SK21/AOG_AutoSteer/SteeringConfigPGNs.pdf

PGNs | 32300 | 32503
| Teensy steering config | subnet change
0 | 44 | 247
1 | 126 | 126
2 | power relay | IP 0
3 | steer relay | IP 1
4 | WAS | IP 2
5 | Current Sensor | CRC
6 steer switch
7 work switch
8 DIR
9 PWM
10 Receiver port
11 RS232 out port
12 RS232 in port
13 IMU port
14 Commands
15 IMU type
16 CRC
byte 14:
bit 0, zero WAS
bit 1, invert roll
bit 2, use ADS1115
bit 3, Auto zero WAS
byte 15:
0, BNO088
1, TM171
