SK21/AOG_AutoSteer/AutoSteer15-3/AS15-3 PinOut.pdf

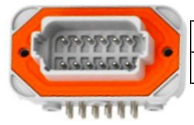
[picture p2: figure]

1 Motor A | 2 GND | 3 12V Out | 4 5V | 5 RS232 TX | 6 RS232 RX
12V In 12 | GND 11 | Motor B 10 | WAS 9 | Str Switch 8 | Wrk Switch 7

AS15-3 PinOut
