SK21/AOG_AutoSteer/AutoSteer15-3/AS15-3 pinout.PNG

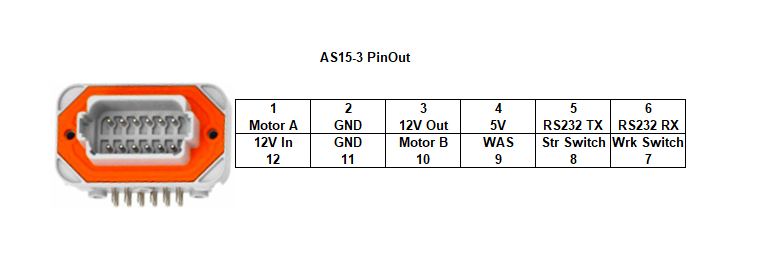
AutoSteer15-3/AS15-3 pinout.PNG
