SK21/AOG_AutoSteer/AutoSteer15-3/AS15.jpg

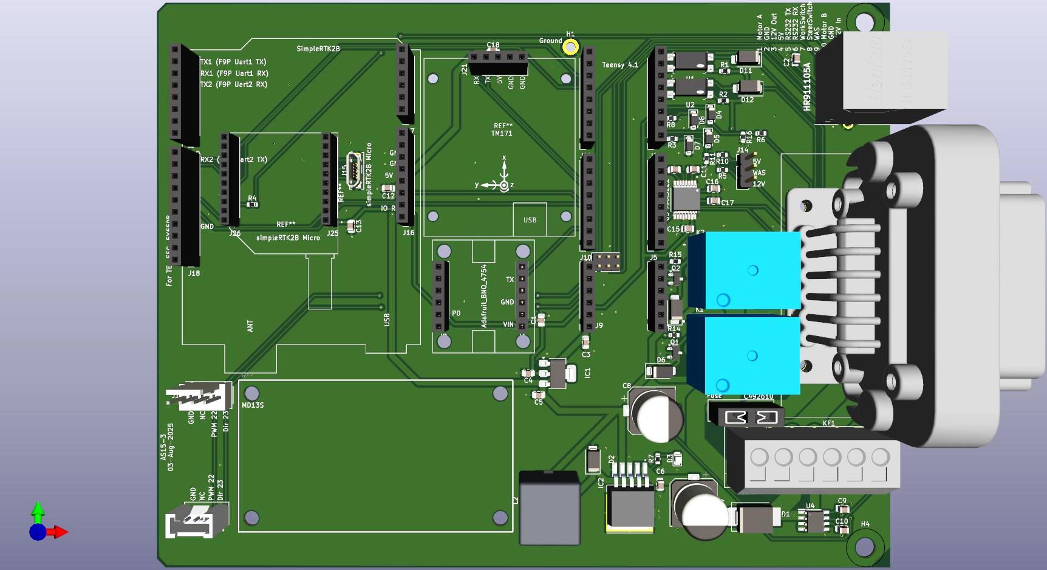
AutoSteer15-3/AS15.jpg
