SK21/AOG_AutoSteer/AutoSteer15-3/Board1.jpg

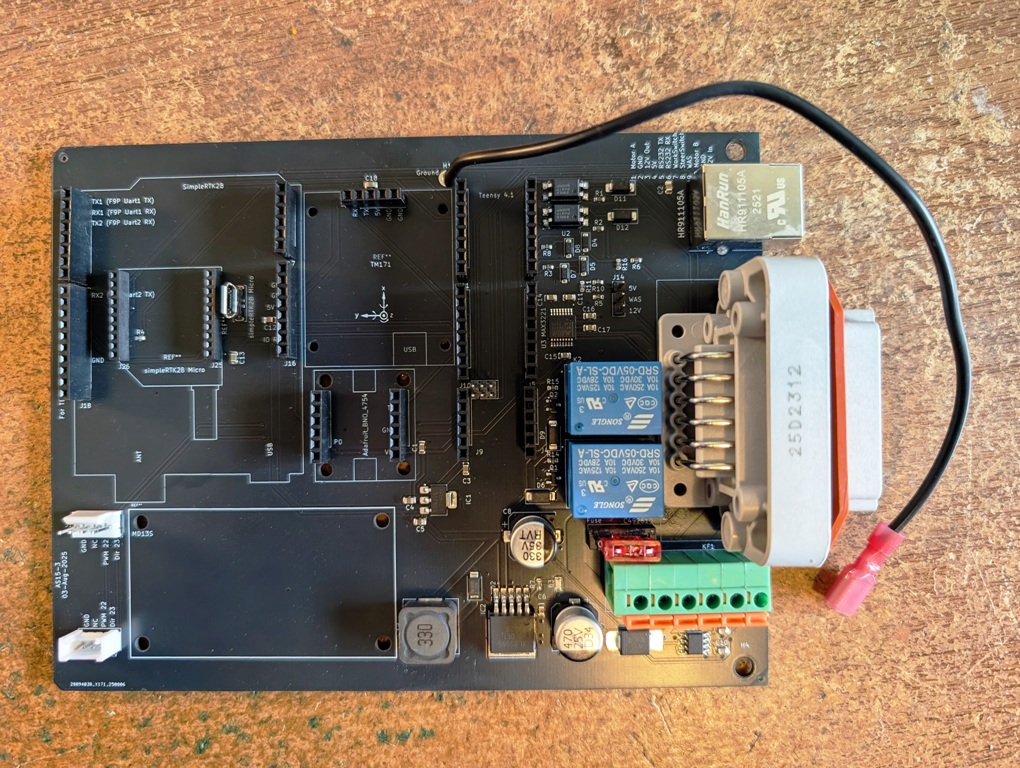
AutoSteer15-3/Board1.jpg
