SK21/AOG_AutoSteer/AutoSteer15-3/Board2.jpg

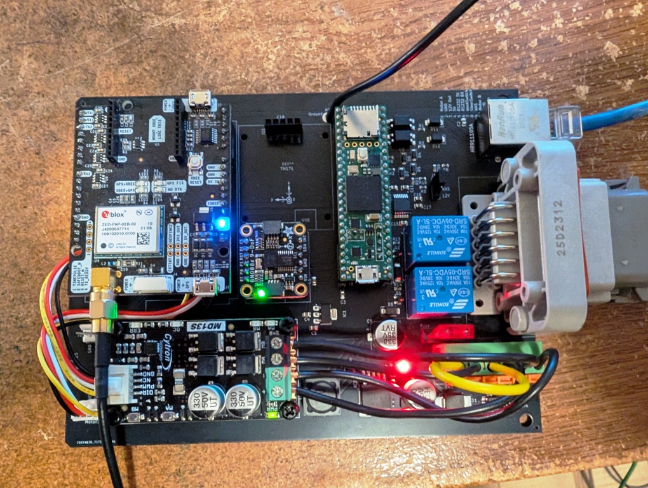
AutoSteer15-3/Board2.jpg
