SK21/AOG_AutoSteer/AutoSteer15-3/control box.jpg

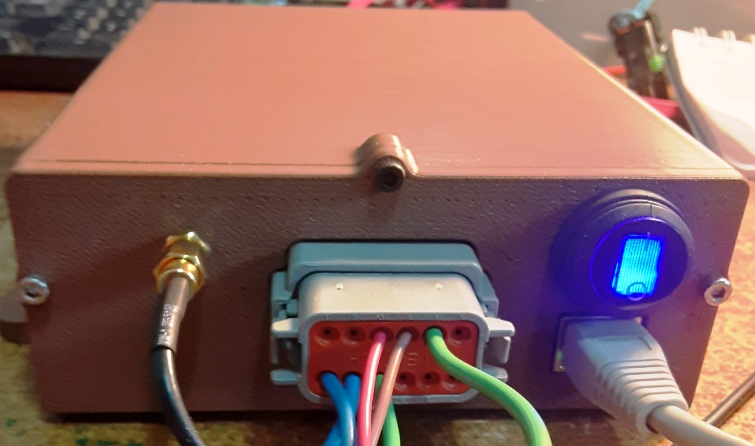
AutoSteer15-3/control box.jpg
