SK21/AOG_AutoSteer/AutoSteer15-3/Grove connector.jpg

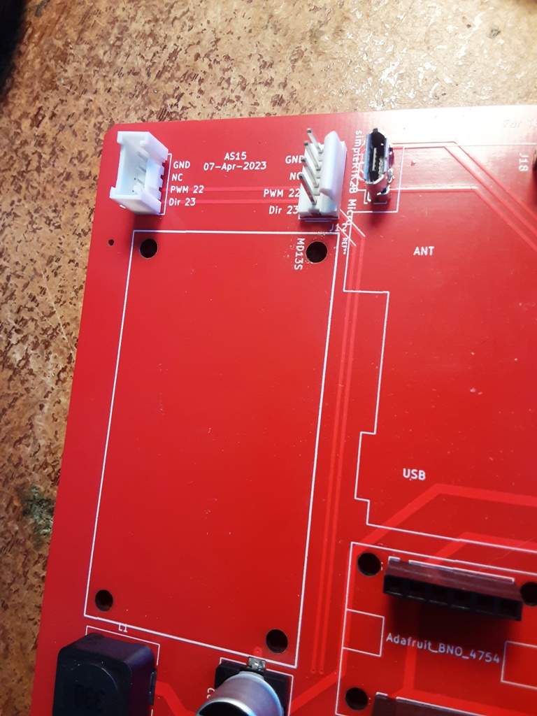
AutoSteer15-3/Grove connector.jpg
