SK21/AOG_AutoSteer/AutoSteer15-3/Teensy ethernet header.jpg

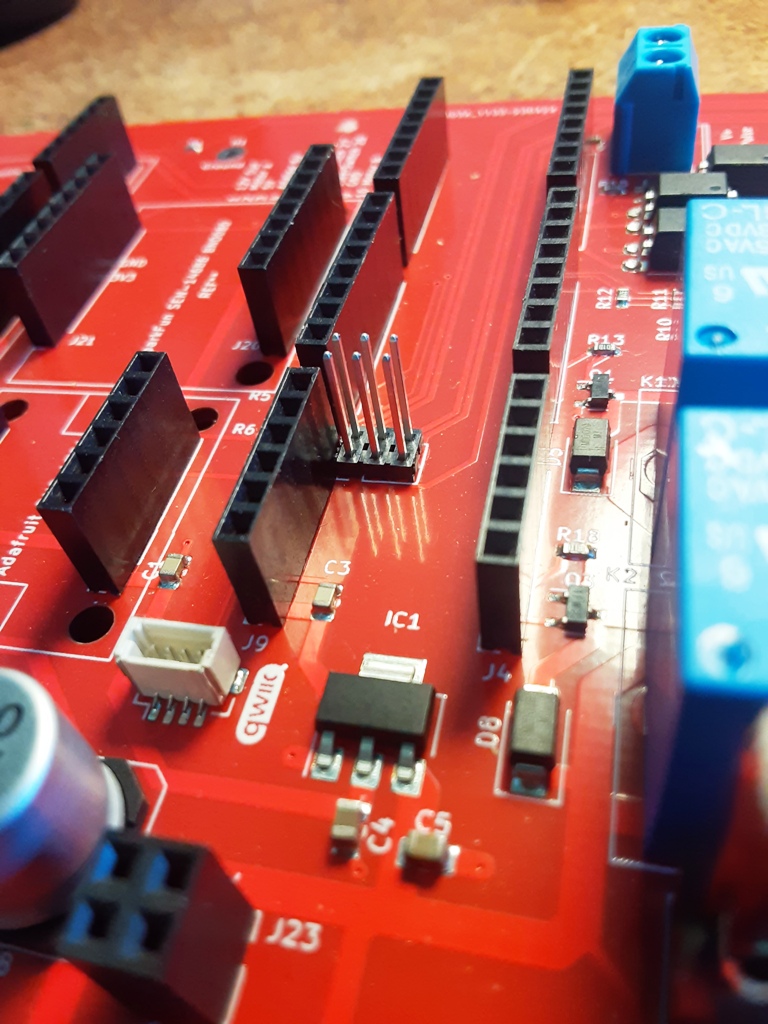
AutoSteer15-3/Teensy ethernet header.jpg
