SK21/AOG_AutoSteer/AutoSteer_for_5/AutoSteer12-2_PCB/AS12.jpg

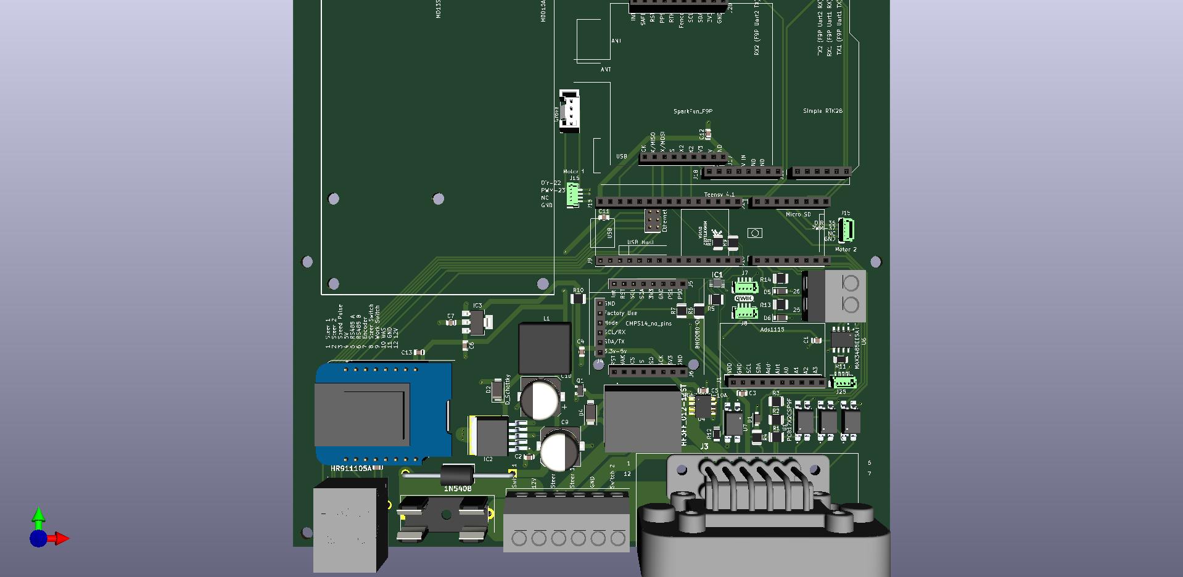
AutoSteer_for_5/AutoSteer12-2_PCB/AS12.jpg
