SK21/AOG_AutoSteer/AutoSteer_for_5/AutoSteer13-3_PCB/AS13pcb.JPG

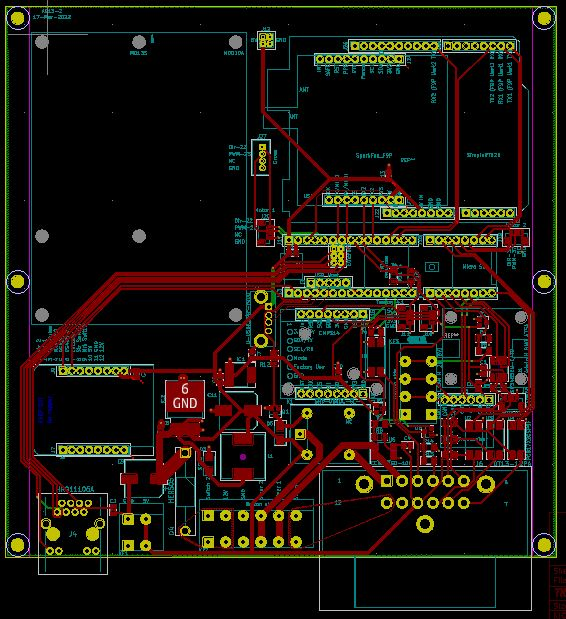
AutoSteer_for_5/AutoSteer13-3_PCB/AS13pcb.JPG
