SK21/AOG_AutoSteer/AutoSteer_for_5/AutoSteer14_PCB/AS14.jpg

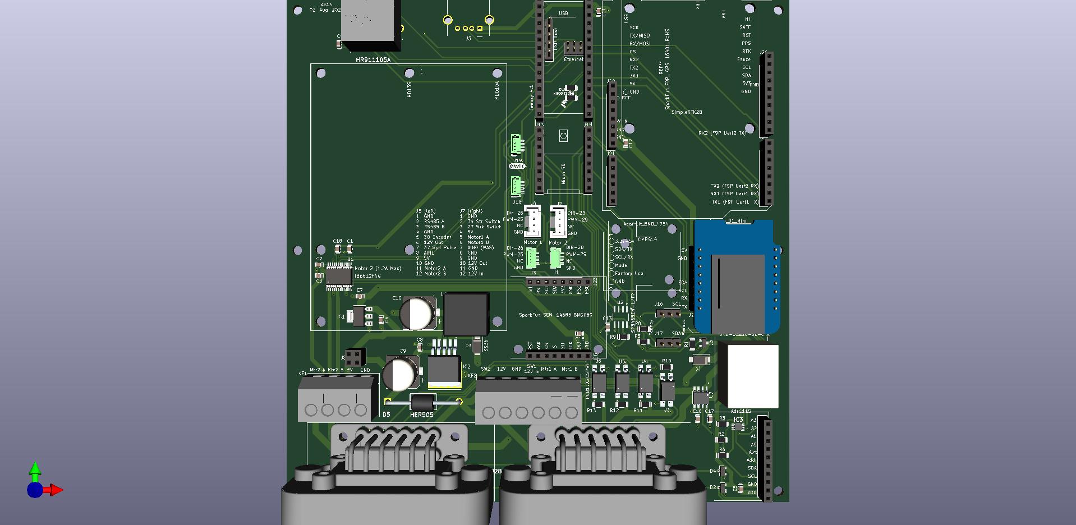
AutoSteer_for_5/AutoSteer14_PCB/AS14.jpg
