SK21/AOG_AutoSteer/AutoSteer_for_5/AutoSteer14_PCB/AS14PinOut.PNG

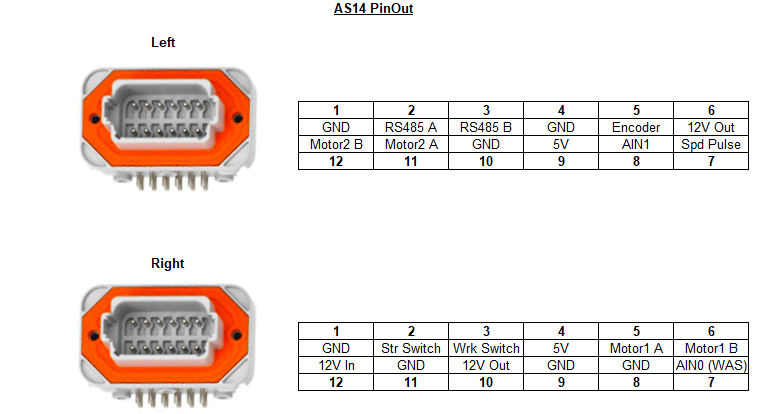
AutoSteer_for_5/AutoSteer14_PCB/AS14PinOut.PNG
