SK21/AOG_AutoSteer/AutoSteer_for_5/Pictures/AS13pic2.jpg

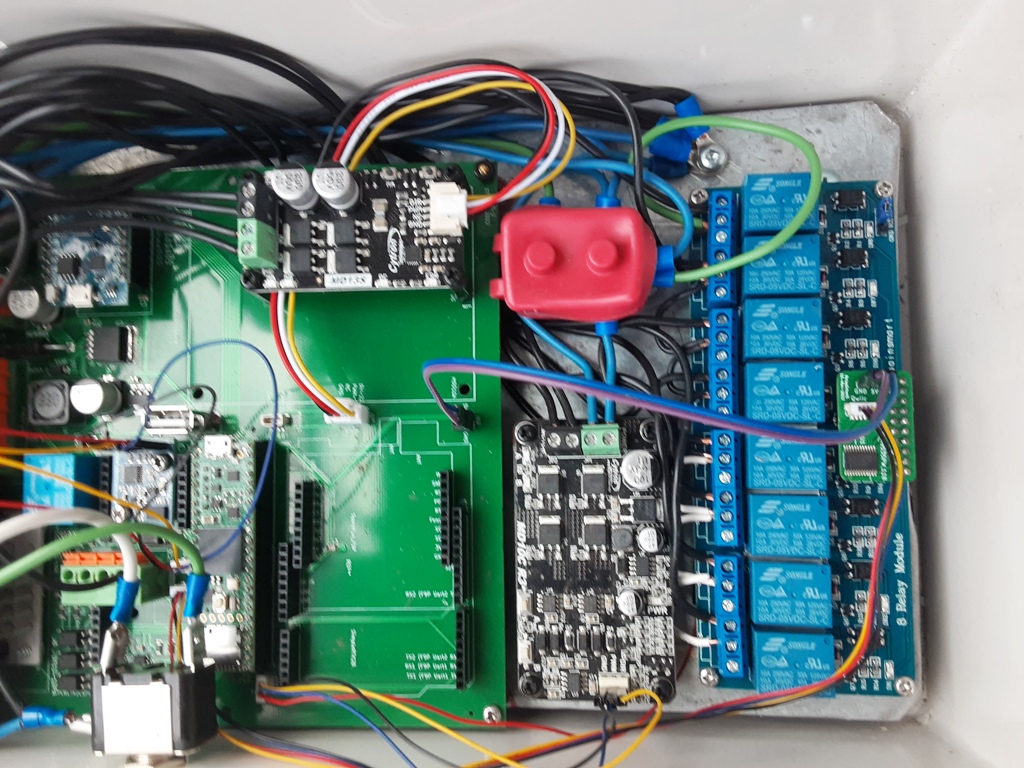
AutoSteer_for_5/Pictures/AS13pic2.jpg
