SK21/AOG_AutoSteer/AutoSteer_for_5/Pictures/AS13pic4.jpg

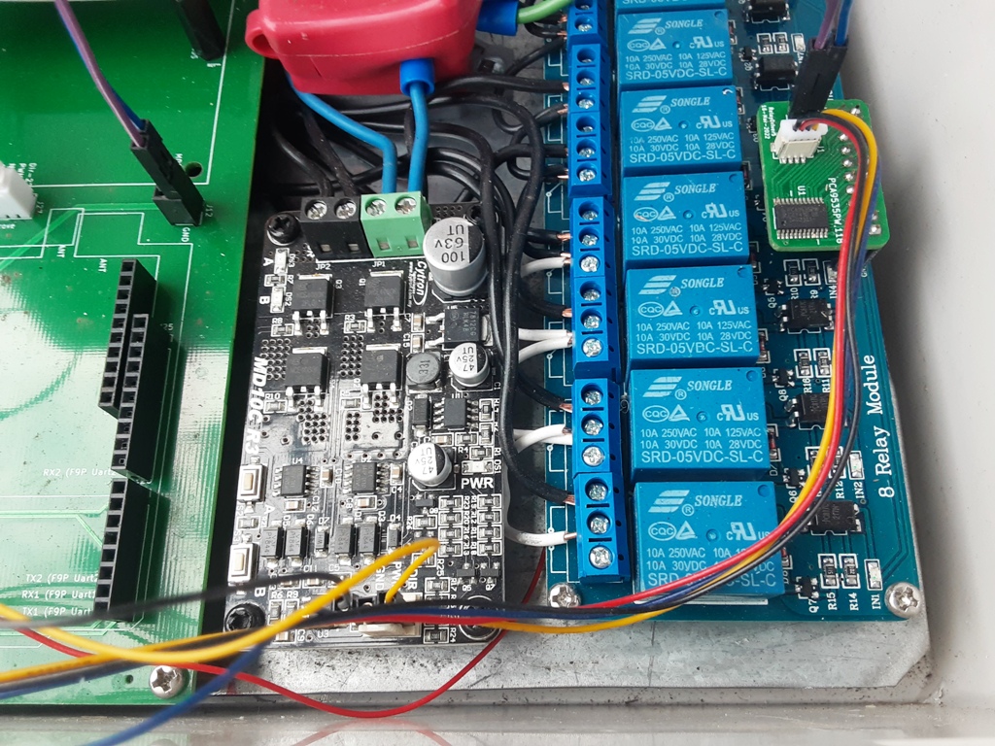
AutoSteer_for_5/Pictures/AS13pic4.jpg
