SK21/AOG_AutoSteer/AutoSteer_for_5/Pictures/AS14.jpg

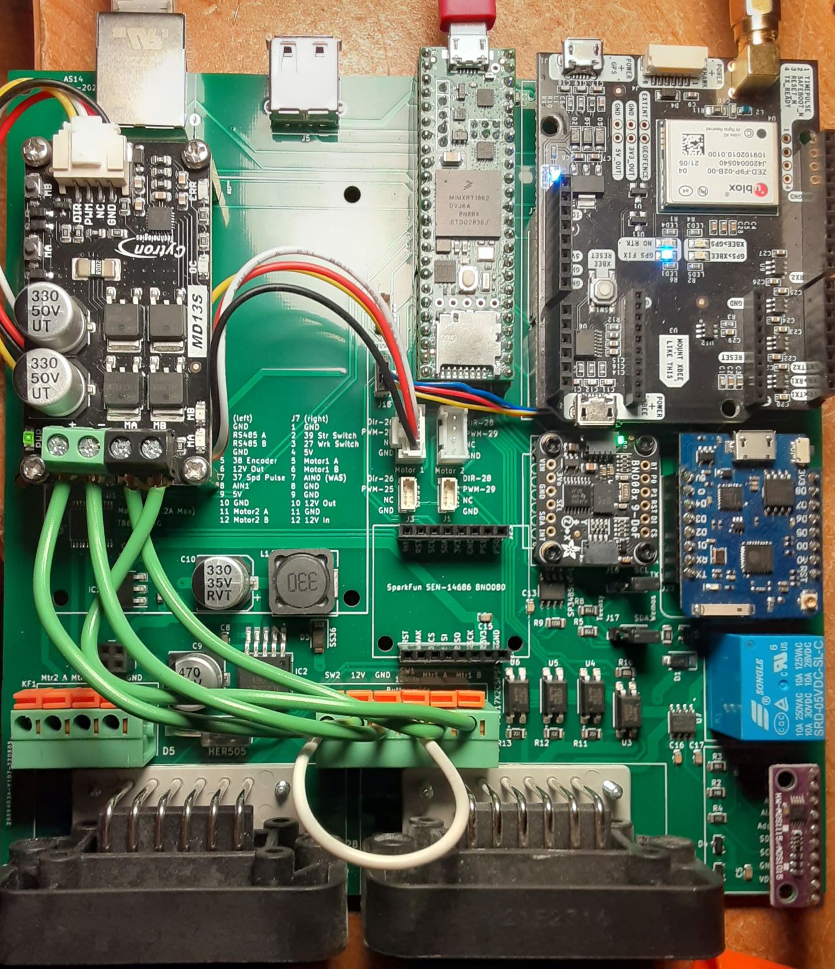
AutoSteer_for_5/Pictures/AS14.jpg
