SK21/AOG_AutoSteer/AutoSteer_for_5/AutoSteer14_PCB/fab/BOM.xls

ID | Name | Designator | Footprint | Quantity | JLCPCB Part #
1 | CL21A106KAYNNNE | C3,C6,C18 | Capacitor_SMD:C_0805_2012Metric | 3 | C15850
2 | 0805F226M250NT | C7 | Capacitor_SMD:C_0805_2012Metric | 1 | C161205
3 | CL21B105KBFNNNE | C8 | Capacitor_SMD:C_0805_2012Metric | 1 | C28323
4 | RVT1V471M1010 | C9 | Capacitor_SMD:CP_Elec_10x10.5 | 1 | C3350
5 | RVT1V331M1010 | C10 | Capacitor_SMD:CP_Elec_10x10.5 | 1 | C72510
6 | CC0805KRX7R9BB104 | C1,C2,C4,C5,C11,C12,C13,C14,C15, C17 | Capacitor_SMD:C_0805_2012Metric | 10 | C49678
7 | CL21B102KBCNNNC | C16 | Capacitor_SMD:C_0805_2012Metric | 1 | C46653
8 | 1N4007F | D1 | Diode_SMD:D_SMA | 1 | C110856
9 | BAV99,215 | D2, D4 | Package_TO_SOT_SMD:SOT-23 | 2 | C2500
10 | SS36 | D3 | MyFootprints:SMA(DO-214AC) | 1 | C116712
11 | HER505 | D5 | MyFootprints:1N5408 | 1 | C364262
12 | AZ1117H-3.3TRE1 | IC1 | Package_TO_SOT_SMD:SOT-223 | 1 | C92517
13 | XL2596S-5.0E1 | IC2 | MyFootprints:TO263-5L | 1 | C74190
14 | PCA9306DCUR | IC3 | MyFootprints:PCA9306DCUR | 1 | C33196
15 | C145961 | J1 | MyFootprints:Qwic_vertical | 1 | C145961
16 | SEEED-110990030 | J2 | MyFootprints:Grove | 1 | C403774
17 | C145961 | J3 | MyFootprints:Qwic_vertical | 1 | C145961
18 | SEEED-110990030 | J4 | MyFootprints:Grove | 1 | C403774
19 | 902-131A1011D10100 | J5 | Connector_USB:USB_A_Molex_67643_Horizontal | 1 | C2345
20 | PZ254V-11-05P | J6 | Connector_PinHeader_2.54mm:PinHeader_1x05_P2.54mm_Vertical | 1 | C492404
21 | DT1312PA | J7, J28 | MyFootprints:DT1312PA | 2
22 | DS1023-2*2SF11 | J8 | Connector_PinSocket_2.54mm:PinSocket_2x02_P2.54mm_Vertical | 1 | C92273
23 | HR911105A | J9 | MyFootprints:HR911105A | 1 | C12074
24 | MTMM-103-10-T-D-355 | J10 | Connector_PinHeader_2.00mm:PinHeader_2x03_P2.00mm_Vertical | 1
25 | C35445 | J11 | Connector_PinSocket_2.54mm:PinSocket_1x10_P2.54mm_Vertical | 1 | C35445
26 | B-2200S15P-A120 | J12, J14 | Connector_PinSocket_2.54mm:PinSocket_1x15_P2.54mm_Vertical | 2 | C124408
27 | C27438 | J13, J15 | Connector_PinSocket_2.54mm:PinSocket_1x08_P2.54mm_Vertical | 2 | C27438
28 | C49257 | J16 | Connector_PinHeader_2.54mm:PinHeader_1x03_P2.54mm_Vertical | 1 | C49257
29 | C49257 | J17 | Connector_PinHeader_2.54mm:PinHeader_1x03_P2.54mm_Vertical | 1 | C49257
30 | C145961 | J18, J19 | MyFootprints:Qwic_vertical | 2 | C145961
31 | C27438 | J20 | Connector_PinSocket_2.54mm:PinSocket_1x08_P2.54mm_Vertical | 1 | C27438
32 | PM254V-11-06-H85 | J21 | Connector_PinSocket_2.54mm:PinSocket_1x06_P2.54mm_Vertical | 1 | C2832269
33 | C27438 | J22 | Connector_PinSocket_2.54mm:PinSocket_1x08_P2.54mm_Vertical | 1 | C27438
34 | C27438 | J23 | Connector_PinSocket_2.54mm:PinSocket_1x08_P2.54mm_Vertical | 1 | C27438
35 | C27438 | J24 | Connector_PinSocket_2.54mm:PinSocket_1x08_P2.54mm_Vertical | 1 | C27438
36 | C27438 | J25 | Connector_PinSocket_2.54mm:PinSocket_1x08_P2.54mm_Vertical | 1 | C27438
37 | C35445 | J26 | Connector_PinSocket_2.54mm:PinSocket_1x10_P2.54mm_Vertical | 1 | C35445
38 | C27438 | J27 | Connector_PinSocket_2.54mm:PinSocket_1x08_P2.54mm_Vertical | 1 | C27438
39 | SRD-05VDC-SL-C | K1 | MyFootprints:Songle_SRD-05VDC-SL-C | 1 | C35449
40 | KF142V-5.08-4P | KF1 | MyFootprints:KF142V-5.08-4P | 1 | C475136
41 | KF142V-5.08-6P | KF2 | MyFootprints:KF142V-5.08-6P | 1 | C475138
42 | SMDRI127-330MT | L1 | MyFootprints:TMPA1265SP-101MN-D | 1 | C9400
43 | BC847B,215 | Q1 | Package_TO_SOT_SMD:SOT-23 | 1 | C57668
44 | 1206W4F1001T5 | R1 | Resistor_SMD:R_1206_3216Metric | 1 | C4410
45 | 1206W4F3480T5E | R2, R3 | Resistor_SMD:R_1206_3216Metric | 2 | C247287
46 | 1206W4J0204T5E | R4 | Resistor_SMD:R_1206_3216Metric | 1 | C37862
47 | 1206W4F2201T5E | R6, R7 | Resistor_SMD:R_1206_3216Metric | 2 | C17948
48 | 1206W4F2150T5E | R5, R8 | Resistor_SMD:R_1206_3216Metric | 2 | C247338
49 | 1206W4F1200T5E | R9 | Resistor_SMD:R_1206_3216Metric | 1 | C17909
50 | 1206W4F1000T5E | R10 | Resistor_SMD:R_1206_3216Metric | 1 | C17901
51 | 1206W4J0201T5E | R11,R12,R13 | Resistor_SMD:R_1206_3216Metric | 3 | C25361
52 | TB6612FNG(O,C,8,EL | U1 | Package_SO:SSOP-24_5.3x8.2mm_P0.65mm | 1 | C88224
53 | SP3485EN-L/TR | U2 | MyFootprints:Maxim_Integrated-S8-2-0-P-MFG | 1 | C8963
54 | PC817X2CSP9F | U3,U4,U5,U6 | MyFootprints:SOIC254P960X420-4N | 4 | C66405
55 | ACS712ELCTR-05B-T | U7 | MyFootprints:SOIC127P600X175-8N | 1 | C44471
