SK21/AOG_AutoSteer/AutoSteer_for_5/AutoSteer12-2_PCB/fab/AS12fab.xls

ID | Name | Designator | Footprint | Quantity | JLCPCB Part #
1 | CL21B105KAFNNNE (https://lcsc.com/product-detail/Multilayer-Ceramic-Capacitors-MLCC-SMD-SMT_Samsung-Electro-Mechanics-CL21B105KAFNNNE_C116352.html) | C2 | Capacitor_SMD:C_0805_2012Metric | 1 | C116352
2 | C2012X5R1E106KT000N (https://lcsc.com/product-detail/Multilayer-Ceramic-Capacitors-MLCC-SMD-SMT_TDK-C2012X5R1E106KT000N_C329933.html) | C6 | Capacitor_SMD:C_0805_2012Metric | 1 | C329933
3 | GRM21BR61E226ME44L (https://lcsc.com/product-detail/Multilayer-Ceramic-Capacitors-MLCC-SMD-SMT_Murata-Electronics-GRM21BR61E226ME44L_C86816.html) | C7 | Capacitor_SMD:C_0805_2012Metric | 1 | C86816
4 | RVT1V471M1010 (https://lcsc.com/product-detail/Aluminum-Electrolytic-Capacitors-SMD_Honor-Elec-RVT1V471M1010_C3350.html) | C9 | Capacitor_SMD:CP_Elec_10x10.5 | 1 | C3350
5 | RVT1V331M1010 (https://lcsc.com/product-detail/Aluminum-Electrolytic-Capacitors-SMD_ROQANG-RVT1V331M1010_C72510.html) | C10 | Capacitor_SMD:CP_Elec_10x10.5 | 1 | C19606
6 | CC0805KRX7R9BB104 (https://lcsc.com/product-detail/Multilayer-Ceramic-Capacitors-MLCC-SMD-SMT_YAGEO-CC0805KRX7R9BB104_C49678.html) | C1,C3,C4,C5,C8,C11,C12,C13 | Capacitor_SMD:C_0805_2012Metric | 8 | C49678
7 | MMSZ5231B (https://lcsc.com/product-detail/Zener-Diodes_Changjiang-Electronics-Tech-CJ-MMSZ5231B_C21563.html) | D1,D5,D6 | Diode_SMD:D_SOD-123F | 3 | C21563
8 | SS36 (https://lcsc.com/product-detail/Schottky-Barrier-Diodes-SBD_Shandong-Jingdao-Microelectronics-SS36_C116712.html) | D2 | MyFootprints:SMA(DO-214AC) | 1 | C116712
9 | 1N5408 (https://lcsc.com/product-detail/Diodes-General-Purpose_Yangzhou-Yangjie-Elec-Tech-1N5408_C698639.html) | D3 | MyFootprints:DO-201AD-28 | 1 | C698639
10 | 1N4007F (https://lcsc.com/product-detail/Diodes-General-Purpose_Shikues-1N4007F_C110856.html) | D4 | D_SMA | 1 | C110856
11 | C3131 (https://lcsc.com/product-detail/span-style-background-color-ff0-Fuse-span-Holders_Xucheng-Elec-C3131_C3131.html) | F1 | MyFootprints:Fuse_Holder_C3131 | 1 | C3131
12 | PCA9306DCUR (https://lcsc.com/product-detail/Translators-Level-Shifters_Texas-Instruments-PCA9306DCUR_C33196.html) | IC1 | SamacSys_Parts:SOP50P310X90-8N | 1 | C33196
13 | XL2596S-5.0E1 (https://lcsc.com/product-detail/DC-DC-Converters_XLSEMI-XL2596S-5-0E1_C74190.html) | IC2 | MyFootprints:TO263-5L | 1 | C74190
14 | AZ1117H-3.3TRE1 (https://lcsc.com/product-detail/Linear-Voltage-Regulators-LDO_Diodes-Incorporated-AZ1117H-3-3TRE1_C92517.html) | IC3 | Package_TO_SOT_SMD:SOT-223 | 1 | C92517
15 | C35445 (https://lcsc.com/product-detail/Female-Headers_BOOMELE-Boom-Precision-Elec-C35445_C35445.html) | J21,J20,J1 | Connector_PinSocket_2.54mm:PinSocket_1x10_P2.54mm_Vertical | 3 | C35445
16 | PM254V-11-06-H85 (https://lcsc.com/product-detail/Female-Headers_XFCN-PM254V-11-06-H85_C2832269.html) | J19,J4 | Connector_PinSocket_2.54mm:PinSocket_1x06_P2.54mm_Vertical | 3 | C2832269
17 | DT1312PA | J3 | MyFootprints:DT1312PA | 1
18 | C27438 (https://lcsc.com/product-detail/Female-Headers_BOOMELE-Boom-Precision-Elec-C27438_C27438.html) | J22,J18,J14,J6,J5,J10,J2,J24 | Connector_PinSocket_2.54mm:PinSocket_1x08_P2.54mm_Vertical | 8 | C27438
19 | C145961 (https://lcsc.com/product-detail/Wire-To-Board-Wire-To-Wire-Connector_BOOMELE-Boom-Precision-Elec-C145961_C145961.html) | J15,J16,J8,J7,J25 | MyFootprints:Qwic_vertical | 5 | C145961
20 | B-2200S15P-A120 (https://lcsc.com/product-detail/Female-Headers_Ckmtw-Shenzhen-Cankemeng-B-2200S15P-A120_C124408.html) | J13,J9 | Connector_PinSocket_2.54mm:PinSocket_1x15_P2.54mm_Vertical | 2 | C124408
21 | MTMM-103-10-T-D-355 | J11 | Connector_PinHeader_2.00mm:PinHeader_2x03_P2.00mm_Vertical | 1
22 | HR911105A (https://lcsc.com/product-detail/Ethernet-Connectors-Modular-Connectors-RJ45-RJ11_HANRUN-Zhongshan-HanRun-Elec-HR911105A_C12074.html) | J12 | Connector_RJ:RJ45_Hanrun_HR911105A | 1 | C12074
23 | X6511FV-09-C85D32 (https://lcsc.com/product-detail/Female-Headers_XKB-Connectivity-X6511FV-09-C85D32_C718236.html) | J17 | Connector_PinSocket_2.54mm:PinSocket_1x09_P2.54mm_Vertical | 1 | C718236
24 | SEEED-110990030 (https://lcsc.com/product-detail/Wire-To-Board-Wire-To-Wire-Connector_Seeed-SEEED-110990030_C403774.html) | J23 | MyFootprints:Grove | 1 | C403774
25 | HF3FF/005-1ZS (https://lcsc.com/product-detail/Power-Relays_HF-Xiamen-Hongfa-Electroacoustic-HF3FF-005-1ZS_C399562.html) | K1 | MyFootprints:HF3FF0121ZST | 1 | C399561
26 | KF142V-5.08-6P (https://lcsc.com/product-detail/Spring-Clamp-System-Terminal-Block_Cixi-Kefa-Elec-KF142V-5-08-6P_C475138.html) | KF1 | MyFootprints:KF142V-5.08-6P | 1 | C475138
27 | KF142V-5.08-2P (https://lcsc.com/product-detail/Spring-Clamp-System-Terminal-Block_Cixi-Kefa-Elec-KF142V-5-08-2P_C475134.html) | KF2 | MyFootprints:KF142V-5.08-2P | 1 | C475134
28 | SMDRI127-330MT (https://lcsc.com/product-detail/Power-Inductors_SXN-Shun-Xiang-Nuo-Elec-SMDRI127-330MT_C9400.html) | L1 | MyFootprints:TMPA1265SP-101MN-D | 1 | C9400
29 | BC847B (https://lcsc.com/product-detail/Bipolar-Transistors-BJT_Guangdong-Hottech-BC847B_C181140.html) | Q1 | Package_TO_SOT_SMD:SOT-23 | 1 | C57668
30 | RK73B2ETTD201J (https://lcsc.com/product-detail/Chip-Resistor-Surface-Mount_KOA-Speer-Elec-RK73B2ETTD201J_C830166.html) | R1,R2,R3,R4,R13,R14 | Resistor_SMD:R_1210_3225Metric | 6 | C830166
31 | CR1210F200KP05Z (https://lcsc.com/product-detail/Chip-Resistor-Surface-Mount_Ever-Ohms-Tech-CR1210F200KP05Z_C174552.html) | R5 | Resistor_SMD:R_1210_3225Metric | 1 | C174552
32 | AC1210FR-07340RL (https://lcsc.com/product-detail/Chip-Resistor-Surface-Mount_YAGEO-AC1210FR-07340RL_C230199.html) | R6,R7 | Resistor_SMD:R_1210_3225Metric | 2 | C230199
33 | RTT12221JTP (https://lcsc.com/product-detail/Chip-Resistor-Surface-Mount_RALEC-RTT12221JTP_C104988.html) | R8,R9 | Resistor_SMD:R_1210_3225Metric | 2 | C104988
34 | 1210W2J0102T5E (https://lcsc.com/product-detail/Chip-Resistor-Surface-Mount_UNI-ROYAL-Uniroyal-Elec-1210W2J0102T5E_C270888.html) | R10 | Resistor_SMD:R_1210_3225Metric | 1 | C270888
35 | 1206W4J0121T5E (https://lcsc.com/product-detail/Chip-Resistor-Surface-Mount_UNI-ROYAL-Uniroyal-Elec-1206W4J0121T5E_C25351.html) | R11 | Resistor_SMD:R_1206_3216Metric | 1 | C25351
36 | RS-06K101JT (https://lcsc.com/product-detail/Chip-Resistor-Surface-Mount_FH-Guangdong-Fenghua-Advanced-Tech-RS-06K101JT_C118845.html) | R12 | Resistor_SMD:R_1206_3216Metric | 1 | C118845
37 | PC817X2CSP9F (https://lcsc.com/product-detail/Optocouplers-Phototransistor-Output_Sharp-Microelectronics-PC817X2CSP9F_C66405.html) | U1,U2,U3,U7 | MyFootprints:SOIC254P960X420-4N | 4 | C66405
38 | CC6900SO-10A (https://lcsc.com/product-detail/Current-Sensors_Cross-chip-CC6900SO-10A_C286005.html) | U4 | MyFootprints:SOIC127P600X175-8N | 1 | C286005
39 | MAX3485EESA+T (https://lcsc.com/product-detail/RS-485-RS-422-ICs_Maxim-Integrated-MAX3485EESA-T_C9943.html) | U6 | MyFootprints:MAX485ESA&plus_T | 1 | C9943
