SK21/AOG_AutoSteer/AutoSteer_for_5/AutoSteer13-3_PCB/fab/AS13fab.xls

Sheet: Sheet1
> C1-C5, C10, C12, C13 | 0.1uF | Capacitor_SMD:C_0805_2012Metric | ~ |  |  |  |  |  |  |  |  | 8
C6 | 10uF | Capacitor_SMD:C_0805_2012Metric | ~ |  |  |  |  |  |  |  |  | 1
C7 | 22uF | Capacitor_SMD:C_0805_2012Metric | ~ |  |  |  |  |  |  |  |  | 1
C8 | 1uF | Capacitor_SMD:C_0805_2012Metric | ~ |  |  |  |  |  |  |  |  | 1
C9 | 470uF | Capacitor_SMD:CP_Elec_10x10.5 | ~ |  |  |  |  |  |  |  |  | 1
C11 | 330uF | Capacitor_SMD:CP_Elec_10x10.5 | ~ |  |  |  |  |  |  |  |  | 1
> D1, D2, D6 | BAV99 | Package_TO_SOT_SMD:SOT-23 | https://assets.nexperia.com/documents/data-sheet/BAV99_SER.pdf |  |  |  |  |  |  |  |  | 3
D3 | SS36 | MyFootprints:SMA(DO-214AC) | ~ |  |  |  |  |  |  |  |  | 1
D4 | HER505 | MyFootprints:1N5408 | ~ |  |  |  |  |  |  |  |  | 1
D5 | 1N4007 | Diode_SMD:D_SMA | ~ |  |  |  |  |  |  |  |  | 1
IC1 | AZ1117 | Package_TO_SOT_SMD:SOT-223 |  |  |  |  |  |  |  |  |  | 1
IC2 | XL2596 | MyFootprints:TO263-5L |  |  |  |  |  |  |  |  |  | 1
J1 | U-USBAS04P-F000 | MyFootprints:U-USBAS04P-F000 | ~ |  |  |  |  |  |  |  |  | 1
J2 | RS485 | MyFootprints:Qwic_vertical | ~ |  |  |  |  |  |  |  |  | 1
J3 | Teensy_USBhost | Connector_PinHeader_2.54mm:PinHeader_1x05_P2.54mm_Vertical | ~ |  |  |  |  |  |  |  |  | 1
J4 | HR911105A | MyFootprints:HR911105A | ~ |  |  |  |  |  |  |  |  | 1
J5 | PM254V-11-06-H85 | Connector_PinSocket_2.54mm:PinSocket_1x06_P2.54mm_Vertical | ~ |  |  |  |  |  |  |  |  | 1
J6 | DT13-12PA | MyFootprints:DT1312PA | https://componentsearchengine.com/Datasheets/1/DT13-12PA.pdf | DT13-12PA | https://www.arrow.com/en/products/dt13-12pa/te-connectivity | Automotive Connectors 12P DT 90DEG RECEP HEADER | 35.26 | TE Connectivity | DT13-12PA | 571-DT13-12PA | https://www.mouser.co.uk/ProductDetail/TE-Connectivity-DEUTSCH/DT13-12PA?qs=vkMqrgFpRahFscUAzs597g%3D%3D | 1
J7 | WemosD1_left | Connector_PinSocket_2.54mm:PinSocket_1x08_P2.54mm_Vertical | ~ |  |  |  |  |  |  |  |  | 1
J8 | Teensy_Ethernet | Connector_PinHeader_2.00mm:PinHeader_2x03_P2.00mm_Vertical | ~ |  |  |  |  |  |  |  |  | 1
J9 | WemosD1_right | Connector_PinSocket_2.54mm:PinSocket_1x08_P2.54mm_Vertical | ~ |  |  |  |  |  |  |  |  | 1
> J10, J11 | I2C-3V3 | MyFootprints:Qwic_vertical | ~ |  |  |  |  |  |  |  |  | 2
> J14, J18 | Conn_01x08_Female | Connector_PinSocket_2.54mm:PinSocket_1x08_P2.54mm_Vertical | ~ |  |  |  |  |  |  |  |  | 2
J15 | BNO080_left | Connector_PinSocket_2.54mm:PinSocket_1x08_P2.54mm_Vertical | ~ |  |  |  |  |  |  |  |  | 1
J16 | BNO080_right | Connector_PinSocket_2.54mm:PinSocket_1x08_P2.54mm_Vertical | ~ |  |  |  |  |  |  |  |  | 1
> J13, J17 | Conn_01x15_Female | Connector_PinSocket_2.54mm:PinSocket_1x15_P2.54mm_Vertical | ~ |  |  |  |  |  |  |  |  | 2
J19 | Motor 2 | MyFootprints:Qwic_vertical | ~ |  |  |  |  |  |  |  |  | 1
J20 | Motor 1 | MyFootprints:Qwic_vertical | ~ |  |  |  |  |  |  |  |  | 1
J21 | SF_F9P_left | Connector_PinSocket_2.54mm:PinSocket_1x09_P2.54mm_Vertical | ~ |  |  |  |  |  |  |  |  | 1
J22 | ArduSimple_tl | Connector_PinSocket_2.54mm:PinSocket_1x08_P2.54mm_Vertical | ~ |  |  |  |  |  |  |  |  | 1
J23 | ArduSimple_bl | Connector_PinSocket_2.54mm:PinSocket_1x06_P2.54mm_Vertical | ~ |  |  |  |  |  |  |  |  | 1
J24 | SF_F9P_right | Connector_PinSocket_2.54mm:PinSocket_1x10_P2.54mm_Vertical | ~ |  |  |  |  |  |  |  |  | 1
J25 | ArduSimple_tr | Connector_PinSocket_2.54mm:PinSocket_1x10_P2.54mm_Vertical | ~ |  |  |  |  |  |  |  |  | 1
J26 | ArduSimple_br | Connector_PinSocket_2.54mm:PinSocket_1x08_P2.54mm_Vertical | ~ |  |  |  |  |  |  |  |  | 1
J27 | Grove | MyFootprints:Grove |  |  |  |  |  |  |  |  |  | 1
K1 | SRD-05VDC-SL-C | MyFootprints:Songle_SRD-05VDC-SL-C |  |  |  |  |  |  |  |  |  | 1
KF1 | KF142V-5.0-2P | MyFootprints:KF142V-5.08-2P |  |  |  |  |  |  |  |  |  | 1
KF2 | KF142V-5.0-6P | MyFootprints:KF142V-5.08-6P |  |  |  |  |  |  |  |  |  | 1
KF3 | KF142V-5.0-4P | MyFootprints:KF142V-5.08-4P |  |  |  |  |  |  |  |  |  | 1
L1 | SMDRI127-330MT | MyFootprints:TMPA1265SP-101MN-D | ~ |  |  |  |  |  |  |  |  | 1
Q1 | BC847 | Package_TO_SOT_SMD:SOT-23 | http://www.infineon.com/dgdl/Infineon-BC847SERIES_BC848SERIES_BC849SERIES_BC850SERIES-DS-v01_01-en.pdf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 |  |  |  |  |  |  |  |  | 1
> R1-R3 | 200 | Resistor_SMD:R_1206_3216Metric | ~ |  |  |  |  |  |  |  |  | 3
R4 | 100 | Resistor_SMD:R_1206_3216Metric | ~ |  |  |  |  |  |  |  |  | 1
R5 | 120 | Resistor_SMD:R_1206_3216Metric | ~ |  |  |  |  |  |  |  |  | 1
> R6, R8, R13 | 1K | Resistor_SMD:R_1206_3216Metric | ~ |  |  |  |  |  |  |  |  | 3
> R7, R9, R14 | 2K | Resistor_SMD:R_1206_3216Metric | ~ |  |  |  |  |  |  |  |  | 3
> R10, R11 | 2.2K | Resistor_SMD:R_1206_3216Metric | ~ |  |  |  |  |  |  |  |  | 2
R12 | 1K | Resistor_SMD:R_1210_3225Metric | ~ |  |  |  |  |  |  |  |  | 1
U1 | SP3485EN-L/TR | MyFootprints:Maxim_Integrated-S8-2-0-P-MFG | https://datasheets.maximintegrated.com/en/ds/MAX3483-MAX3491.pdf |  |  |  |  |  |  |  |  | 1
> U2-U5 | PC817X2CSP9F | MyFootprints:SOIC254P960X420-4N |  |  |  |  |  |  |  |  |  | 4
U6 | CC6900SO-10A | MyFootprints:SOIC127P600X175-8N |  |  |  |  |  |  |  |  |  | 1

Sheet: AS13
ID | Name | Designator | Footprint | Quantity | JLCPCB Part # | Description | Part # verified | Footprint verified | Schematic verified | Notes
1 | RVT1V331M1010 | C11 | CP_Elec_10x10.5 | 1 | C72510 | 330uF | xx | x | x
2 | CC0805KRX7R9BB104 | C2,C5,C4,C3,C10,C1,C13,C12 | C_0805_2012Metric | 8 | C49678 | 0.1uF | xx | x | x
3 | CL21A106KAYNNNE | C6 | C_0805_2012Metric | 1 | C15850 | 10uF | xx | x | x
4 | CL21A226MAQNNNE | C7 | C_0805_2012Metric | 1 | C45783 | 22uF | xx | x | x
5 | CL21B105KBFNNNE | C8 | C_0805_2012Metric | 1 | C28323 | 1uF | xx | x | x
6 | RVT1V471M1010 | C9 | CP_Elec_10x10.5 | 1 | C3350 | 470uF | xx | x | x
7 | SS36 | D3 | SMA(DO-214AC) | 1 | C116712 | SS36 | xx | x | x
8 | HER505 | D4 | 1N5408 | 1 | C364262 | HER505 | xx | x | x
9 | 1N4007F | D5 | D_SMA | 1 | C110856 | 1N4007 | xx | x | x
10 | BAV99,215 | D6,D2,D1 | SOT-23 | 3 | C2500 | BAV99 | xx | x | x
11 | AZ1117H-3.3TRE1 | IC1 | SOT-223 | 1 | C92517 | AZ1117 | xx | x | x
12 | XL2596S-5.0E1 | IC2 | TO263-5L | 1 | C74190 | XL2596 | xx | x | x
13 | U-USBAS04P-F000 | J1 | U-USBAS04P-F000 | 1 | C386735 | U-USBAS04P-F000 | xx | x | x
14 | C145961 | J11,J10 | Qwic_vertical | 2 | C145961 | I2C-3V3 | xx | x | x
15 | C92273 | J12 | PinSocket_2x02_P2.54mm_Vertical | 1 | C92273 | 5V power | xx | x | x
16 | C27438 | J15 | PinSocket_1x08_P2.54mm_Vertical | 1 | C27438 | BNO080_left | xx | x | x
17 | C27438 | J16 | PinSocket_1x08_P2.54mm_Vertical | 1 | C27438 | BNO080_right | xx | x | x
18 | B-2200S15P-A120 | J17,J13 | PinSocket_1x15_P2.54mm_Vertical | 2 | C124408 | Conn_01x15_Female | xx | x | x
19 | C27438 | J18,J14 | PinSocket_1x08_P2.54mm_Vertical | 2 | C27438 | Conn_01x08_Female | xx | x | x
20 | C145961 | J19 | Qwic_vertical | 1 | C145961 | Motor 2 | xx | x | x
21 | C145961 | J2 | Qwic_vertical | 1 | C145961 | RS485 | xx | x | x
22 | C145961 | J20 | Qwic_vertical | 1 | C145961 | Motor 1 | xx | x | x
23 | C39576 | J21 | PinSocket_1x09_P2.54mm_Vertical | 1 | C39576 | SF_F9P_left | xx | x | x
24 | C27438 | J22 | PinSocket_1x08_P2.54mm_Vertical | 1 | C27438 | ArduSimple_tl | xx | x | x
25 | PM254V-11-06-H85 | J23 | PinSocket_1x06_P2.54mm_Vertical | 1 | C2832269 | ArduSimple_bl | xx | x | x
26 | C35445 | J24 | PinSocket_1x10_P2.54mm_Vertical | 1 | C35445 | SF_F9P_right | xx | x | x
27 | C35445 | J25 | PinSocket_1x10_P2.54mm_Vertical | 1 | C35445 | ArduSimple_tr | xx | x | x
28 | C27438 | J26 | PinSocket_1x08_P2.54mm_Vertical | 1 | C27438 | ArduSimple_br | xx | x | x
29 | SEEED-110990030 | J27 | Grove | 1 | C403774 | Grove | xx | x | x
30 | PZ254-1-05-Z-8.5 | J3 | PinHeader_1x05_P2.54mm_Vertical | 1 | C2894928 | Teensy_USBhost | xx | x | x
31 | HR911105A | J4 | HR911105A | 1 | C12074 | HR911105A | xx | x | x
32 | PM254V-11-06-H85 | J5 | PinSocket_1x06_P2.54mm_Vertical | 1 | C2832269 | PM254V-11-06-H85 | xx | x | x
33 | DT13-12PA | J6 | DT1312PA | 1 |  | DT13-12PA
34 | C27438 | J7 | PinSocket_1x08_P2.54mm_Vertical | 1 | C27438 | WemosD1_left | xx | x | x
35 | MTMM-103-10-T-D-355 | J8 | PinHeader_2x03_P2.00mm_Vertical | 1 |  | Teensy_Ethernet
36 | C27438 | J9 | PinSocket_1x08_P2.54mm_Vertical | 1 | C27438 | WemosD1_right | xx | x | x
37 | SRD-05VDC-SL-C | K1 | Songle_SRD-05VDC-SL-C | 1 | C35449 | SRD-05VDC-SL-C | xx | x | x
38 | KF142V-5.08-2P | KF1 | KF142V-5.08-2P | 1 | C475134 | KF142V-5.0-2P | xx | x | x
39 | KF142V-5.08-6P | KF2 | KF142V-5.08-6P | 1 | C475138 | KF142V-5.0-6P | xx | x | x
40 | KF142V-5.08-4P | KF3 | KF142V-5.08-4P | 1 | C475136 | KF142V-5.0-4P | xx | x | x
41 | SMDRI127-330MT | L1 | TMPA1265SP-101MN-D | 1 | C9400 | SMDRI127-330MT | xx | x | x
42 | BC847B,215 | Q1 | SOT-23 | 1 | C57668 | BC847 | xx | x | x
43 | 1206W4F2201T5E | R11,R10 | R_1206_3216Metric | 2 | C17948 | 2.2K | xx | x | x
44 | 1206W4F1001T5 | R12,R13,R8,R6 | R_1206_3216Metric | 4 | C4410 | 1K | xx | x | x
45 | 1206W4F2001T5E | R14,R9,R7 | R_1206_3216Metric | 3 | C17944 | 2K | xx | x | x
46 | 1206W4J0201T5E | R3,R2,R1 | R_1206_3216Metric | 3 | C25361 | 200 | xx | x | x
47 | 1206W4F1000T5E | R4 | R_1206_3216Metric | 1 | C17901 | 100 | xx | x | x
48 | 1206W4F1200T5E | R5 | R_1206_3216Metric | 1 | C17909 | 120 | xx | x | x
49 | SP3485EN-L/TR | U1 | Maxim_Integrated-S8-2-0-P-MFG | 1 | C8963 | SP3485EN-L/TR | xx | x | x
50 | PC817X2CSP9F | U5,U3,U2,U4 | SOIC254P960X420-4N | 4 | C66405 | PC817X2CSP9F | xx | x | x
51 | CC6900SO-10A | U6 | SOIC127P600X175-8N | 1 | C286005 | CC6900SO-10A | xx | x | x
