SK21/AOG_AutoSteer/AutoSteer_for_5/Steer Box/AS14 box v18.3mf

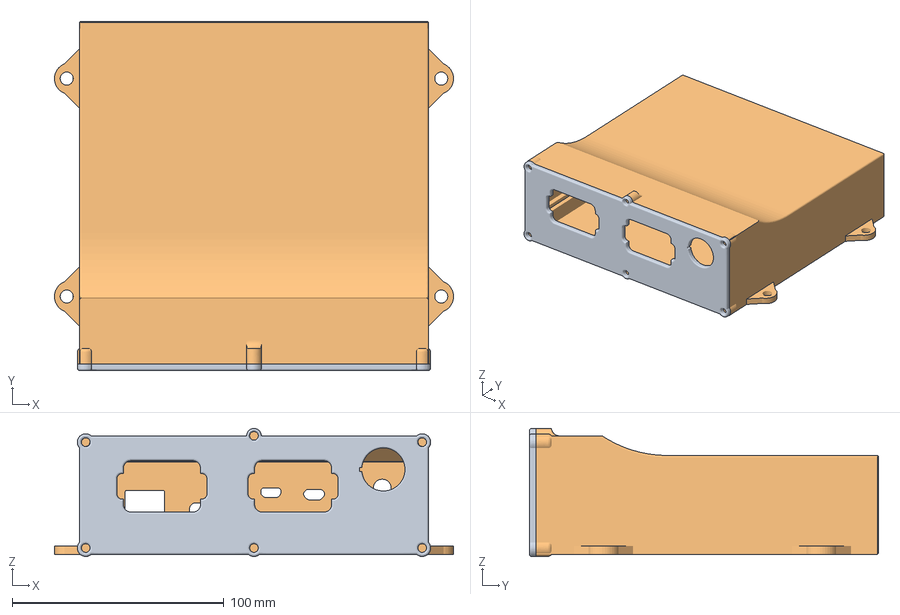
[picture p22: CAD file, 2023-04-19]
AutoSteer_for_5/Steer Box/AS14 box v18.3mf
188.6 x 165.0 x 60.5 mm
