SK21/AOG_AutoSteer/(list of files, cad)

Other CAD files:
AutoSteer_for_5/Steer Box/AS14 box v18.stl
