SK21/AOG_AutoSteer/AutoSteer_for_5/AutoSteer12-2_PCB/Assembly/AS12 config1.JPG

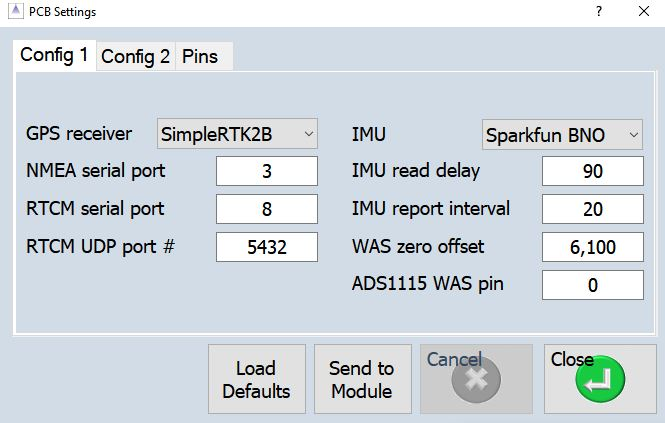
AutoSteer_for_5/AutoSteer12-2_PCB/Assembly/AS12 config1.JPG
