SK21/AOG_AutoSteer/AutoSteer_for_5/AutoSteer12-2_PCB/Assembly/Grove header AS13pcb.jpg

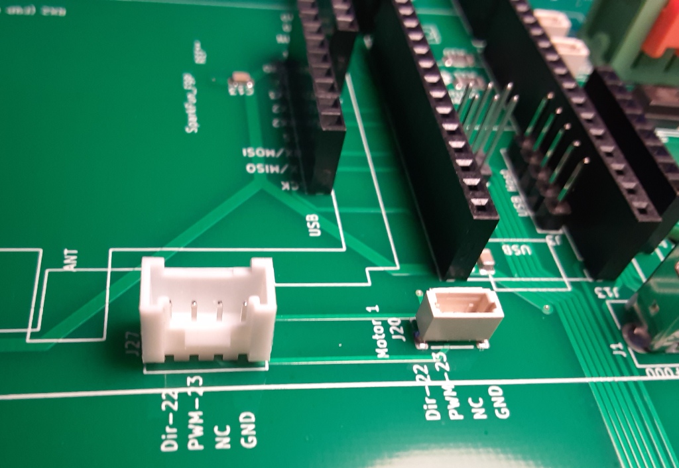
AutoSteer_for_5/AutoSteer12-2_PCB/Assembly/Grove header AS13pcb.jpg
