SK21/AOG_AutoSteer/AutoSteer_for_5/AutoSteer12-2_PCB/Assembly/header_socket_3x2_3.jpg

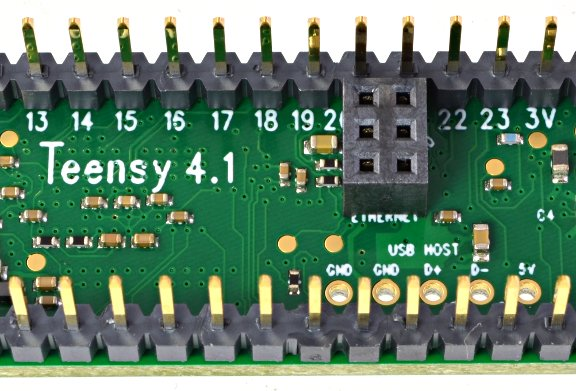
AutoSteer_for_5/AutoSteer12-2_PCB/Assembly/header_socket_3x2_3.jpg
