SK21/AOG_AutoSteer/AutoSteer_for_5/AutoSteer13-3_PCB/Assembly/AS13 config2.JPG

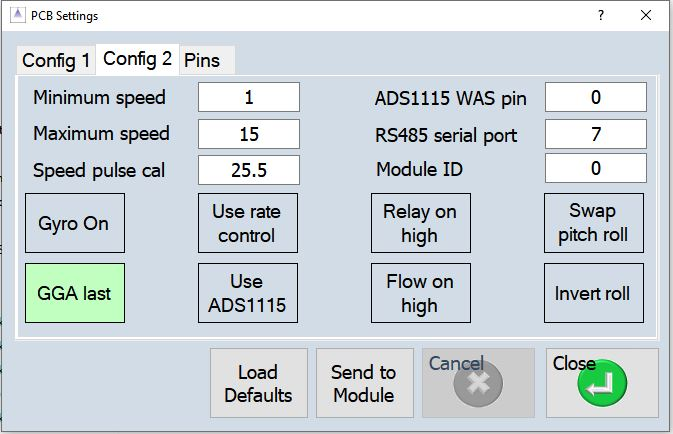
AutoSteer_for_5/AutoSteer13-3_PCB/Assembly/AS13 config2.JPG
