SK21/AOG_AutoSteer/AutoSteer15-3/AS15-3 schematic.pdf

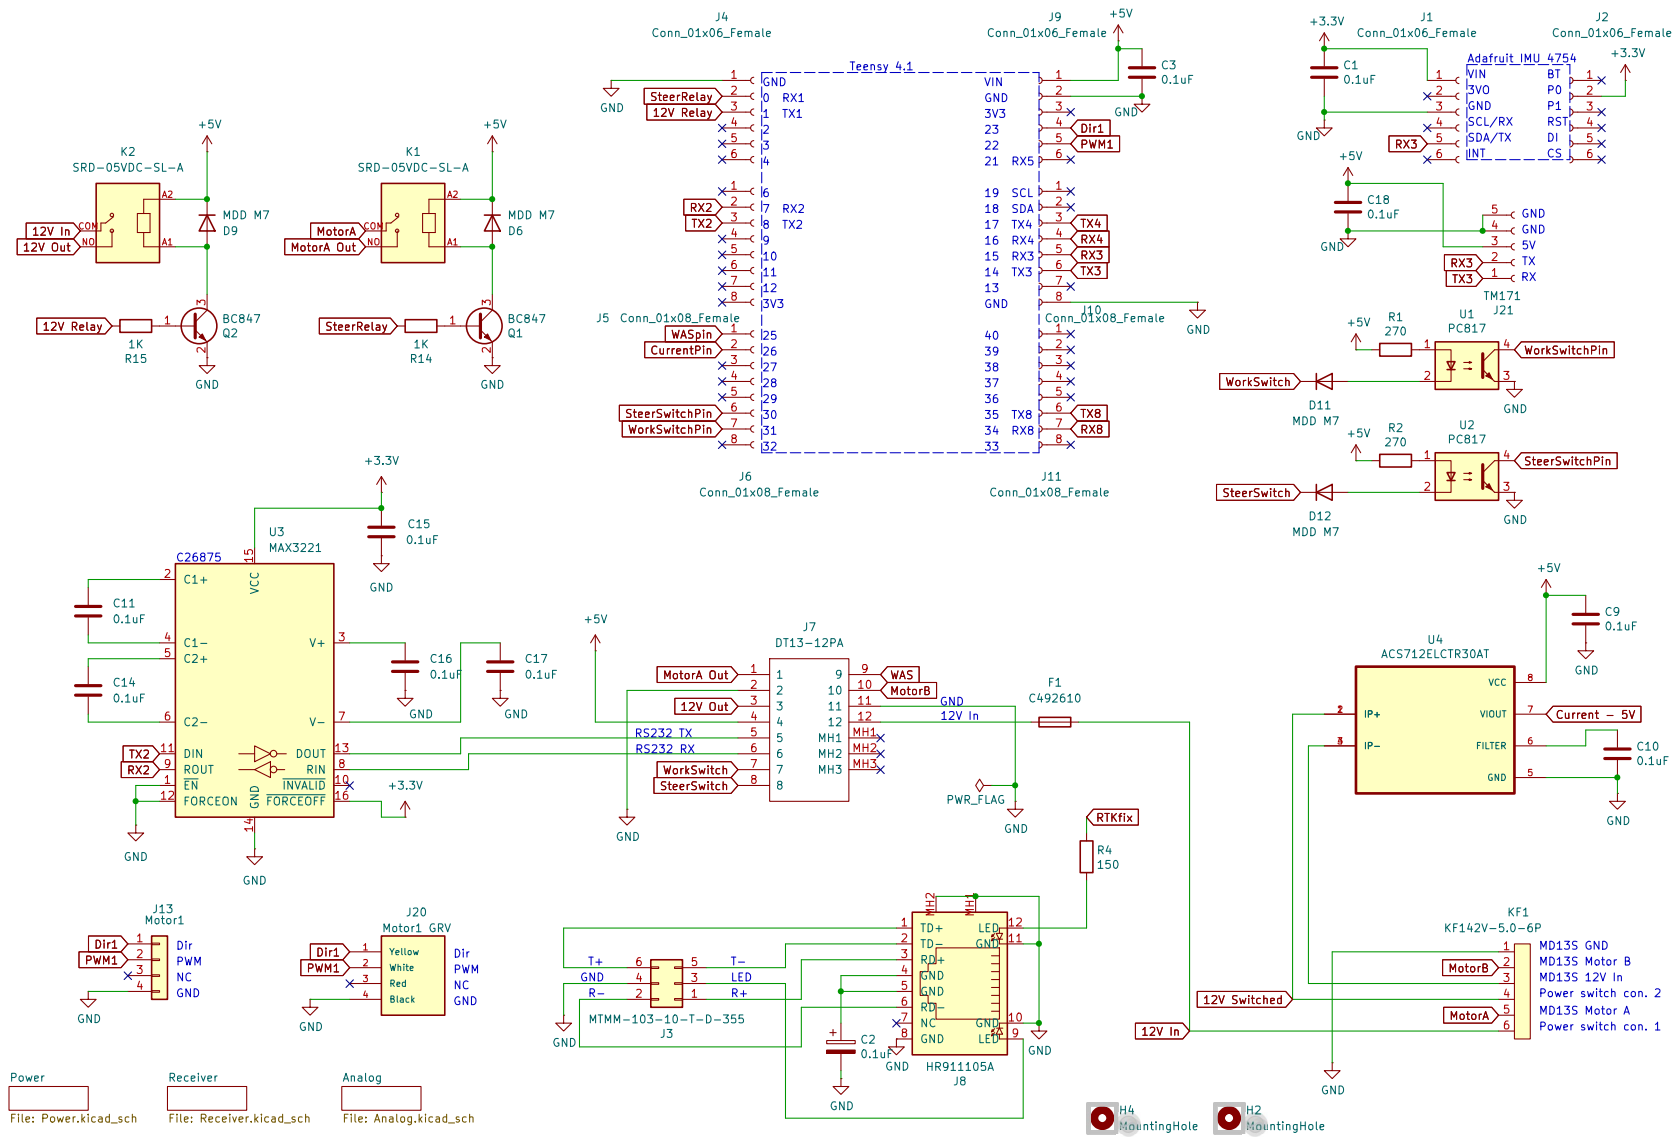
[picture p31: page 1]

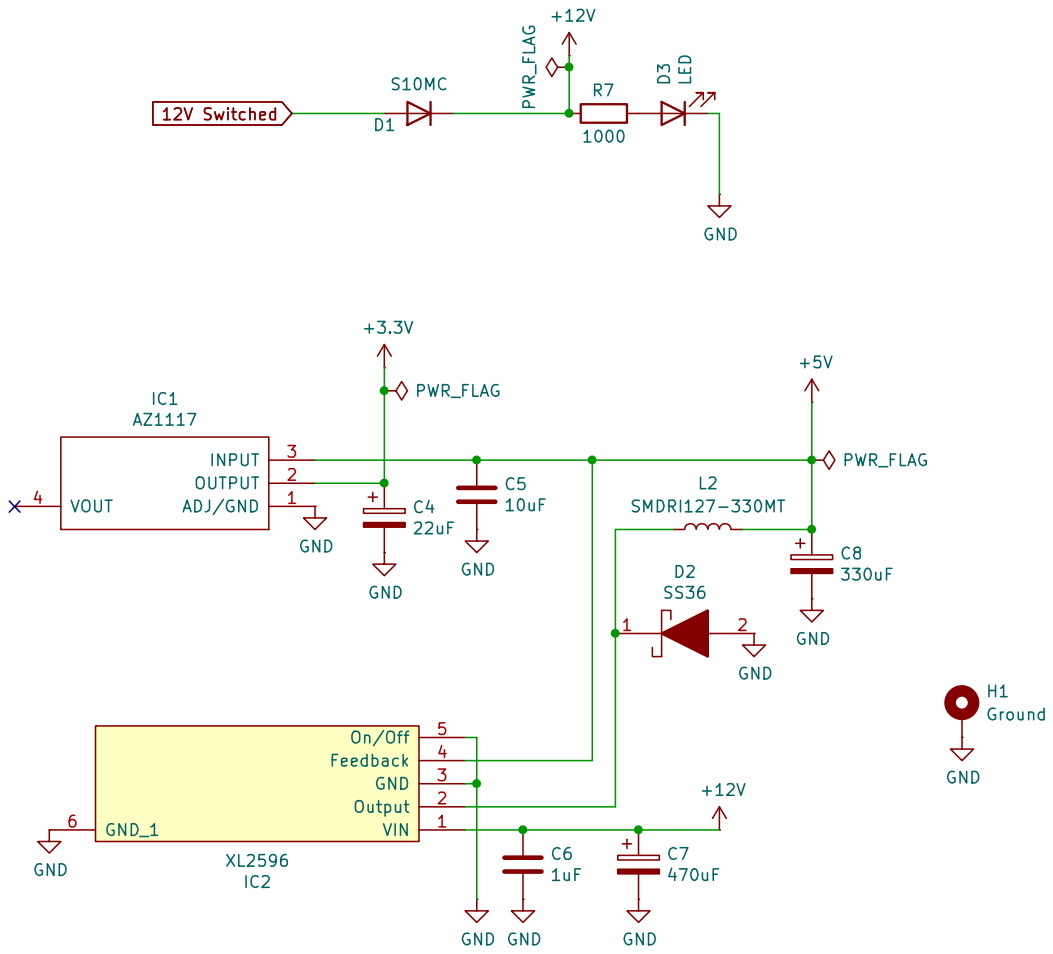
[picture p32: page 2]

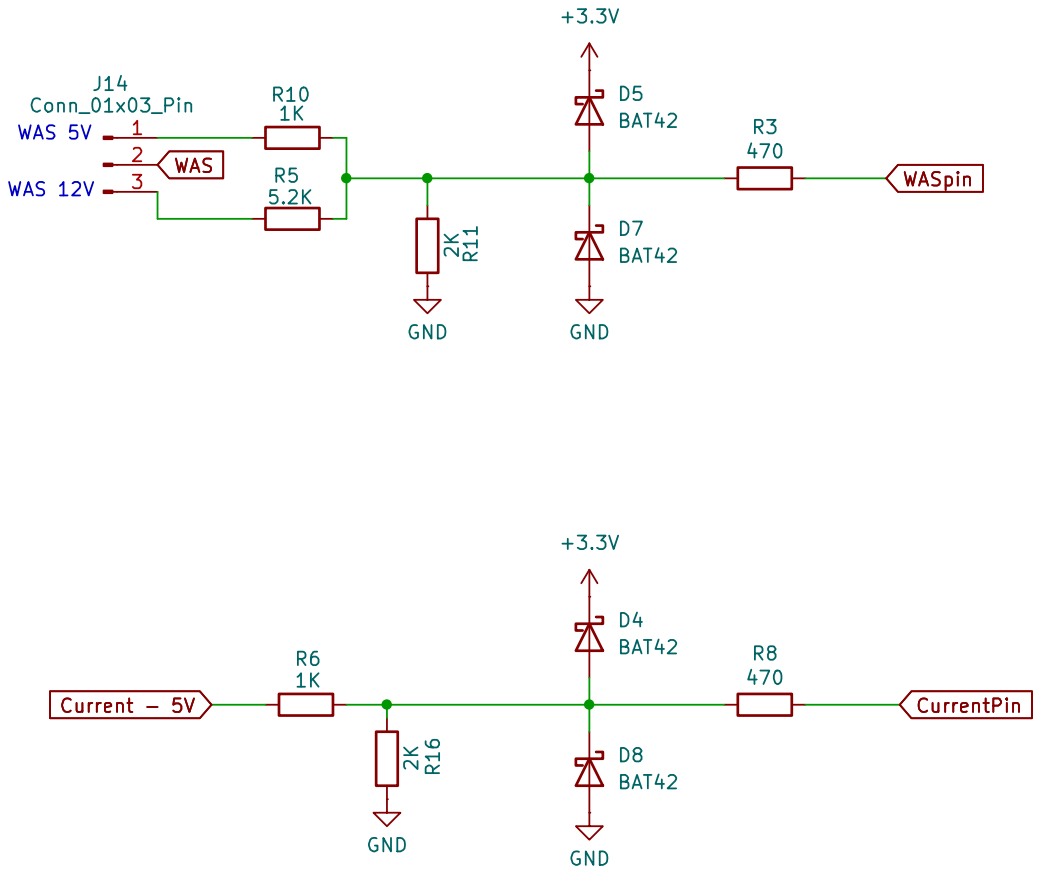
[picture p33: page 3]

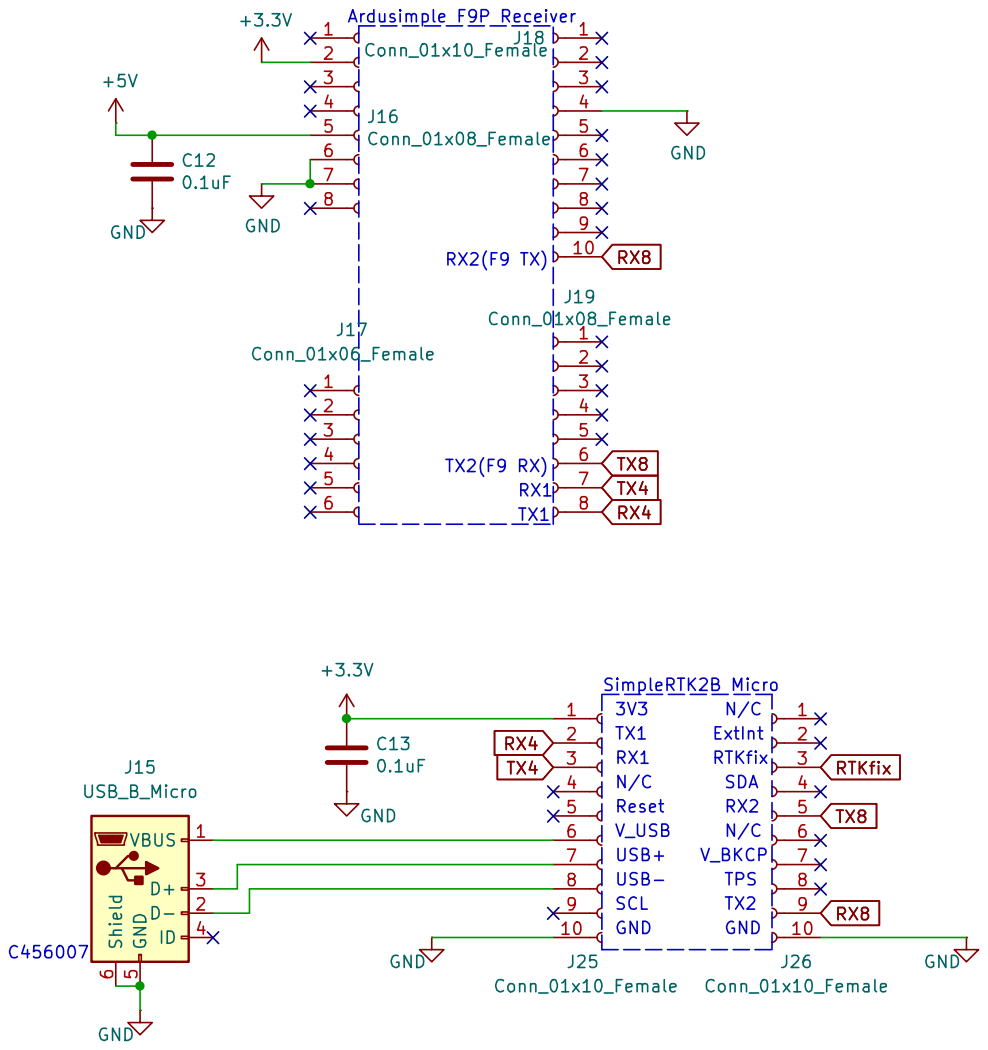
[picture p34: page 4]
