SK21/AOG_AutoSteer/AutoSteer15-3/AS15.kicad_pcb

## KiCad design AutoSteer15-3/AS15.kicad_pcb (2026-08-04)

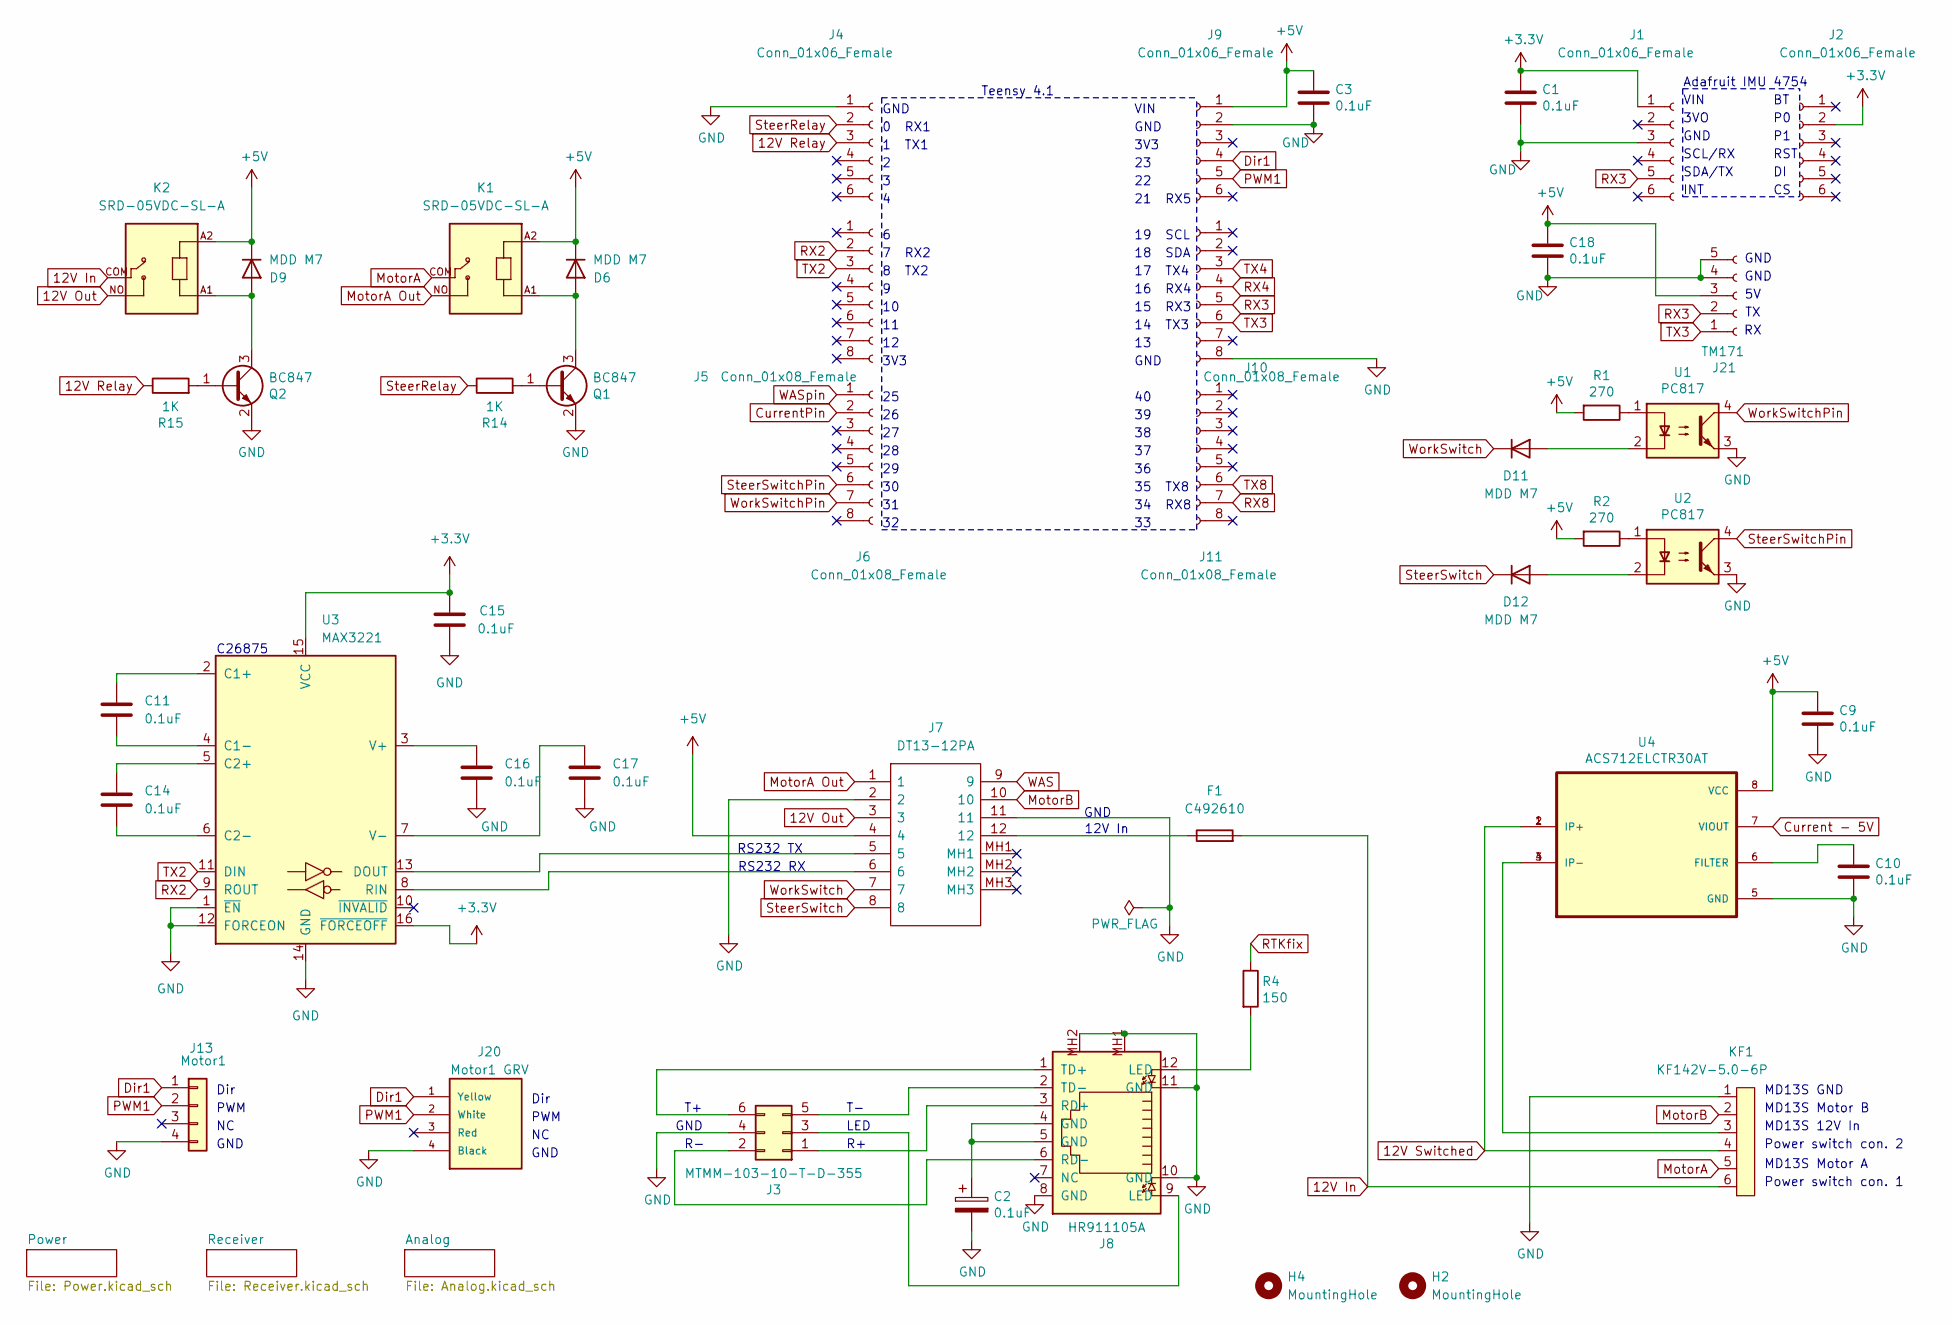
[picture p35: schematic AS15.kicad_sch, AS15-3]

Parts:
C1, C2, C3, C9, C10, C11, C14, C15, C16, C17, C18: 0.1uF; C_0805_2012Metric
D6, D9, D11, D12: MDD M7; D_SMA
F1: C492610; Fuse_Holder_C492610
H2, H4: MountingHole; MountingHole_4.3mm_M4
J1, J2, J4, J9: Conn_01x06_Female; PinSocket_1x06_P2.54mm_Vertical
J3: MTMM-103-10-T-D-355; PinHeader_2x03_P2.00mm_Vertical
J5, J6, J10, J11: Conn_01x08_Female; PinSocket_1x08_P2.54mm_Vertical
J7: DT13-12PA; DT1312PA; Manufacturer_Part_Number DT13-12PA; Mouser Part Number 571-DT13-12PA
J8: HR911105A
J13: Motor1; Molex_KK-254_AE-6410-04A_1x04_P2.54mm_Vertical
J20: Motor1 GRV; Grove
J21: TM171; PinSocket_1x05_P2.54mm_Vertical
K1, K2: SRD-05VDC-SL-A; RELAY_SRD-05VDC-SL-A
KF1: KF142V-5.0-6P; KF142V-5.08-6P
Q1, Q2: BC847; SOT-23
R1, R2: 270; R_0603_1608Metric
R4: 150; R_0603_1608Metric
R14, R15: 1K; R_0603_1608Metric
U1, U2: PC817; SMD-4_4.6x7.62mm_P2.54mm
U3: MAX3221; SOP65P777X199-16N
U4: ACS712ELCTR30AT; SOIC127P600X175-8N; PARTREV 1.0

Connections:
12V In: F1.2, K2.COM, KF1.6
12V Out: J7.3, K2.NO
12V Relay: J4.3, R15.1
12V Switched: KF1.4, U4.1 (IP+), U4.2 (IP+); also elsewhere on the board
+3.3V: C1.1, C15.1, J1.1, J2.2, U3.15 (VCC), U3.16 (~FORCEOFF); also elsewhere on the board
+5V: C3.1, C9.1, C18.1, D6.1 (K), D9.1 (K), J7.4, J9.1, J21.3, K1.A2, K2.A2, R1.2, R2.2, U4.8 (VCC); also elsewhere on the board
Current - 5V: U4.7 (VIOUT); also elsewhere on the board
CurrentPin: J6.2; also elsewhere on the board
Dir1: J9.4, J13.1, J20.1 (Yellow)
GND: C1.2, C2.2, C3.2, C9.2, C10.2, C15.2, C16.2, C17.2, C18.2, J1.3, J3.4, J4.1, J7.2, J7.11, J8.8 (GND), J8.10 (GND), J8.11 (GND), J8.MH1, J8.MH2, J9.2, J10.8, J13.4, J20.4 (Black), J21.4, J21.5, KF1.1, Q1.2 (E), Q2.2 (E), U1.3, U2.3, U3.1 (~EN), U3.12 (FORCEON), U3.14 (GND), U4.5 (GND); also elsewhere on the board
MotorA: K1.COM, KF1.5
MotorA Out: J7.1, K1.NO
MotorB: J7.10, KF1.2
unnamed: C2.1, J8.4 (GND), J8.5 (GND)
unnamed: D6.2 (A), K1.A1, Q1.3 (C)
unnamed: D9.2 (A), K2.A1, Q2.3 (C)
unnamed: D11.2 (A), U1.2
unnamed: D12.2 (A), U2.2
unnamed: F1.1, J7.12
unnamed: J3.1, J8.3 (RD+)
unnamed: J3.2, J8.6 (RD-)
unnamed: J3.3, J8.9 (LED)
unnamed: J3.5, J8.2 (TD-)
unnamed: J3.6, J8.1 (TD+)
unnamed: J8.12 (LED), R4.2
unnamed: KF1.3, U4.3 (IP-), U4.4 (IP-)
unnamed: Q1.1 (B), R14.2
unnamed: Q2.1 (B), R15.2
unnamed: R1.1, U1.1
unnamed: R2.1, U2.1
unnamed: C11.1, U3.2 (C1+)
unnamed: C11.2, U3.4 (C1-)
unnamed: C14.1, U3.5 (C2+)
unnamed: C14.2, U3.6 (C2-)
unnamed: J7.5, U3.13 (DOUT)
unnamed: J7.6, U3.8 (RIN)
unnamed: C16.1, U3.3 (V+)
unnamed: C17.1, U3.7 (V-)
unnamed: C10.1, U4.6 (FILTER)
PWM1: J9.5, J13.2, J20.2 (White)
RTKfix: R4.1; also elsewhere on the board
RX2: J5.2, U3.9 (ROUT)
RX3: J1.5, J10.5, J21.2
RX4: J10.4; also elsewhere on the board
RX8: J11.7; also elsewhere on the board
SteerRelay: J4.2, R14.1
SteerSwitch: D12.1 (K), J7.8
SteerSwitchPin: J6.6, U2.4
TX2: J5.3, U3.11 (DIN)
TX3: J10.6, J21.1
TX4: J10.3; also elsewhere on the board
TX8: J11.6; also elsewhere on the board
WAS: J7.9; also elsewhere on the board
WASpin: J6.1; also elsewhere on the board
WorkSwitch: D11.1 (K), J7.7
WorkSwitchPin: J6.7, U1.4

Notes on the sheet:
3V3
GND
RS232 TX
C26875
7 RX2
19 SCL
Teensy 4.1
MD13S Motor B
LED
8 TX2
35 TX8
Dir
16 RX4
SCL/RX
MD13S GND
14 TX3
VIN
17 TX4
RST
PWM
3VO
12V In
Power switch con. 1
MD13S Motor A
MD13S 12V In
34 RX8
Power switch con. 2
1 TX1
RS232 RX
18 SDA
INT
0 RX1
SDA/TX
21 RX5
15 RX3
Adafruit IMU 4754

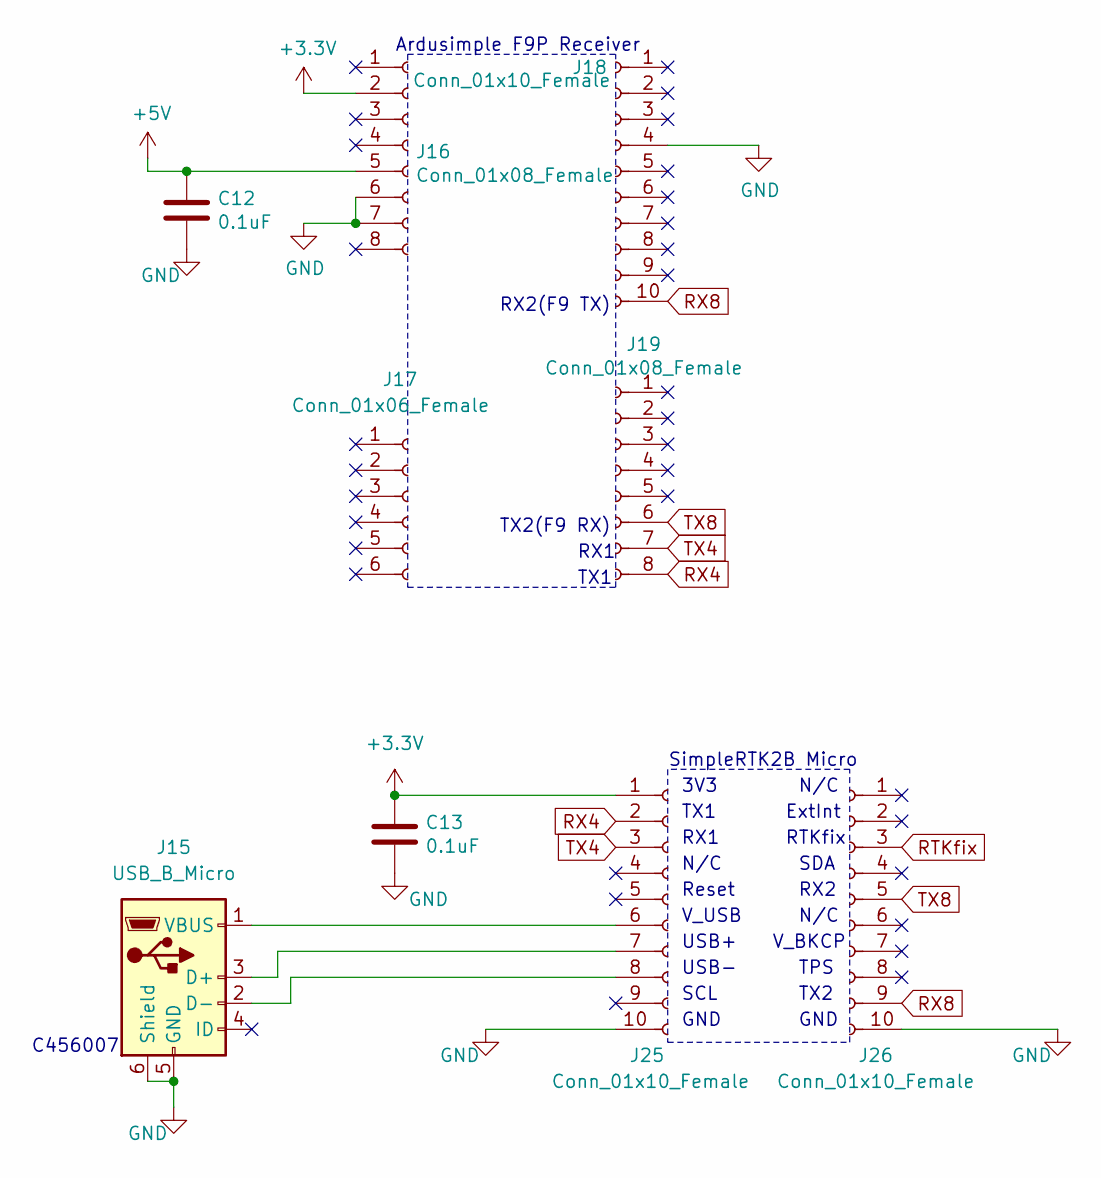
[picture p36: schematic Receiver.kicad_sch]

Parts:
C12, C13: 0.1uF; C_0805_2012Metric
J15: USB_B_Micro; USB_Micro-B_Wuerth_614105150721_Vertical
J16, J19: Conn_01x08_Female; PinSocket_1x08_P2.54mm_Vertical
J17: Conn_01x06_Female; PinSocket_1x06_P2.54mm_Vertical
J18: Conn_01x10_Female; PinSocket_1x10_P2.54mm_Vertical
J25, J26: Conn_01x10_Female; PinSocket_1x10_P2.00mm_Vertical

Connections:
+3.3V: C13.1, J16.2, J25.1; also elsewhere on the board
+5V: C12.1, J16.5; also elsewhere on the board
GND: C12.2, C13.2, J15.5 (GND), J15.6 (Shield), J16.6, J16.7, J18.4, J25.10, J26.10; also elsewhere on the board
unnamed: J15.3 (D+), J25.7
unnamed: J15.2 (D-), J25.8
unnamed: J15.1 (VBUS), J25.6
RTKfix: J26.3; also elsewhere on the board
RX4: J19.8, J25.2; also elsewhere on the board
RX8: J18.10, J26.9; also elsewhere on the board
TX4: J19.7, J25.3; also elsewhere on the board
TX8: J19.6, J26.5; also elsewhere on the board

Notes on the sheet:
RX1
3V3
TX1
SCL
RX2(F9 TX)
GND
N/C
USB-
TPS
SDA
TX2
V_USB
V_BKCP
RX2
C456007
ExtInt
Reset
Ardusimple F9P Receiver
SimpleRTK2B Micro
RTKfix
TX2(F9 RX)
USB+

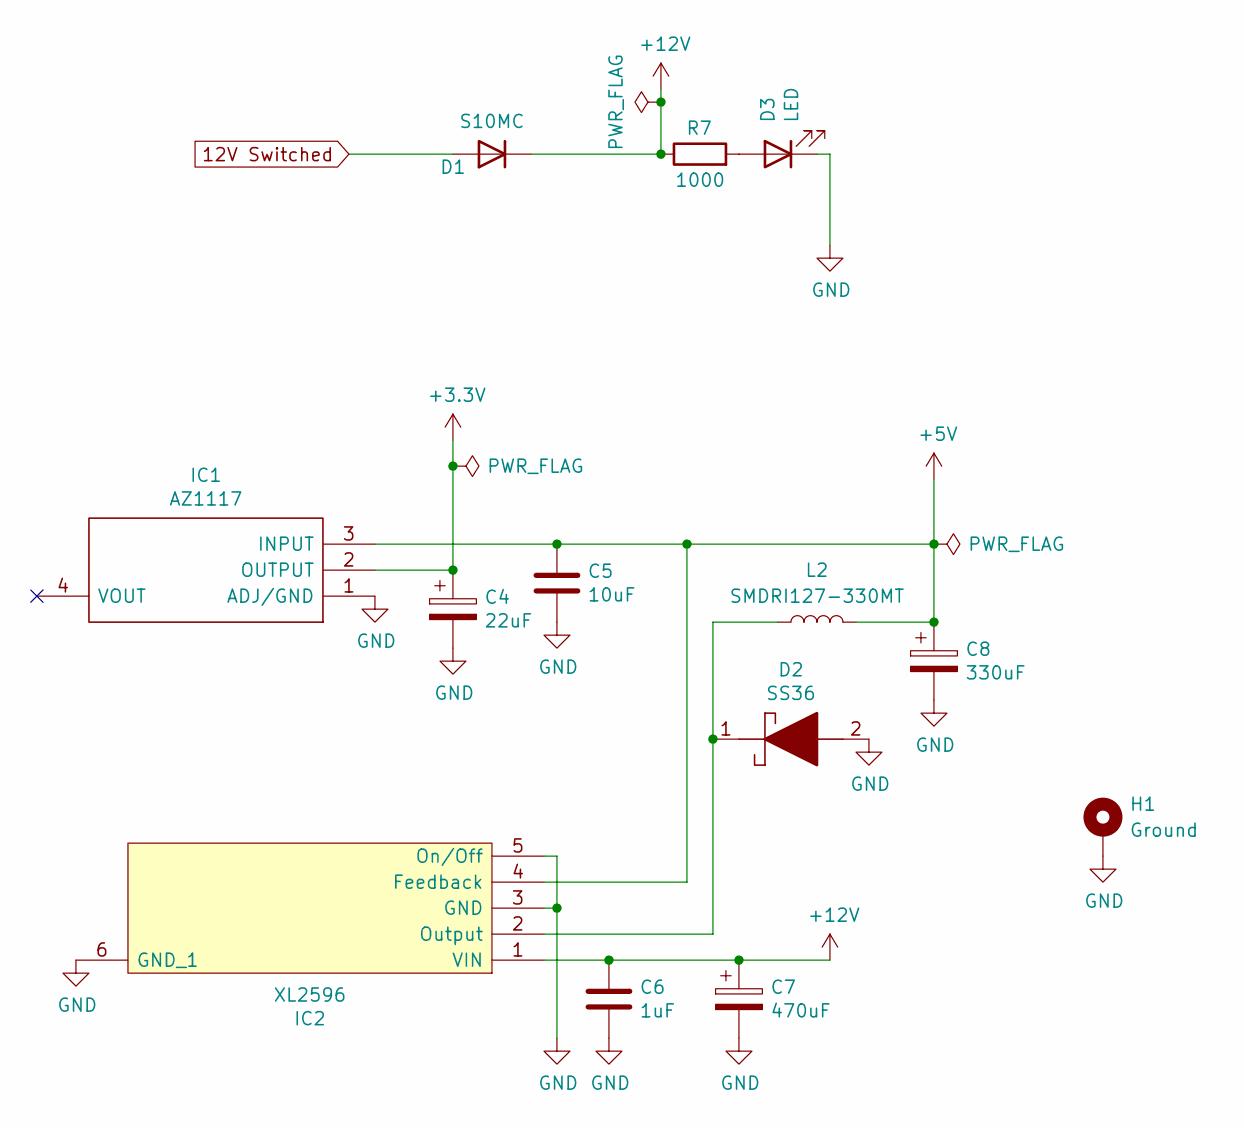
[picture p37: schematic Power.kicad_sch]

Parts:
C4: 22uF; C_0805_2012Metric
C5: 10uF; C_0805_2012Metric
C6: 1uF; C_0805_2012Metric
C7: 470uF; CP_Elec_10x10.5
C8: 330uF; CP_Elec_10x10.5
D1: S10MC; D_SMC_larger_pads
D2: SS36; SMA(DO-214AC)
D3: LED; LED_0805_2012Metric
H1: Ground; MountingHole_2.2mm_M2_DIN965_Pad
IC1: AZ1117; SOT-223
IC2: XL2596; TO263-5L
L2: SMDRI127-330MT; TMPA1265SP-101MN-D
R7: 1000; R_0603_1608Metric

Connections:
12V Switched: D1.2 (A); also elsewhere on the board
+3.3V: C4.1, IC1.2 (OUTPUT); also elsewhere on the board
+5V: C5.1, C8.1, IC1.3 (INPUT), IC2.4 (Feedback), L2.2; also elsewhere on the board
+12V: C6.1, C7.1, D1.1 (K), IC2.1 (VIN), R7.1
GND: C4.2, C5.2, C6.2, C7.2, C8.2, D2.2, D3.1 (K), H1.1, IC1.1 (ADJ/GND), IC2.3 (GND), IC2.5 (On/Off), IC2.6 (GND_1); also elsewhere on the board
unnamed: D3.2 (A), R7.2
unnamed: D2.1, IC2.2 (Output), L2.1

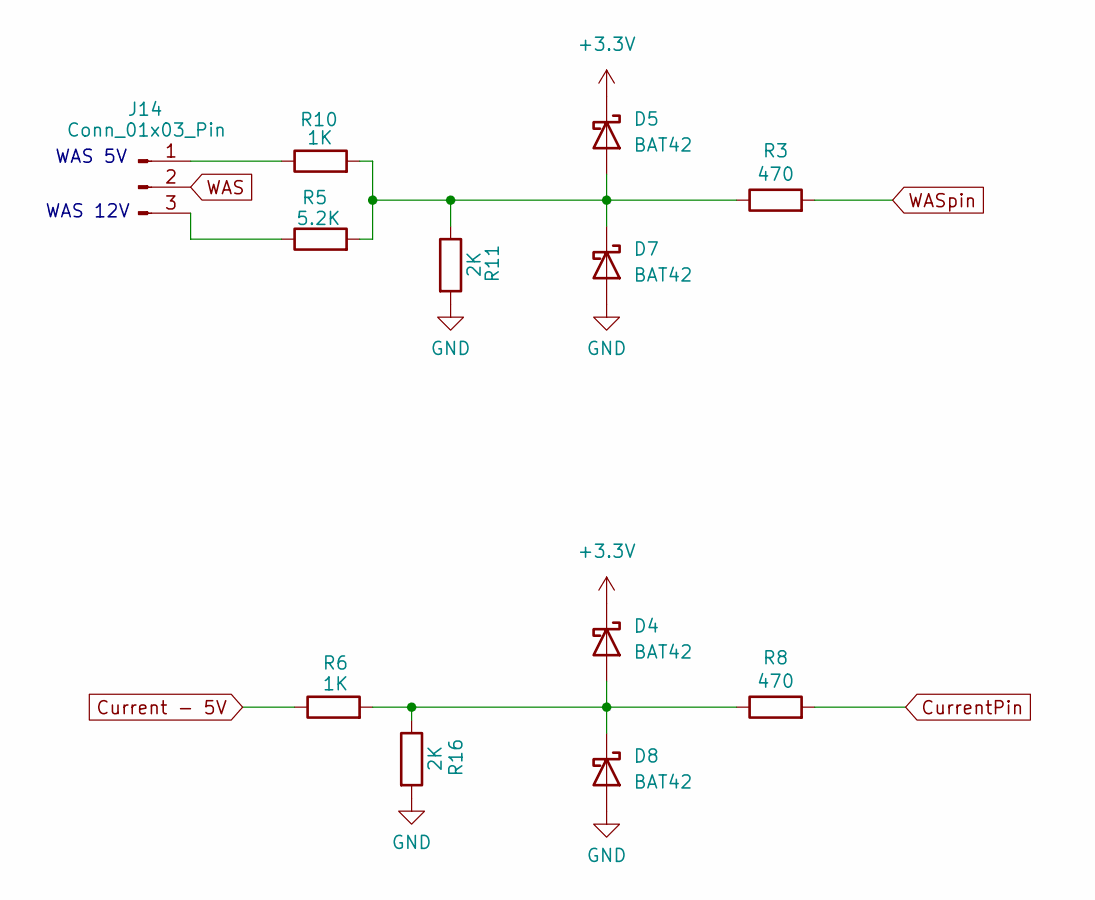
[picture p38: schematic Analog.kicad_sch]

Parts:
D4, D5, D7, D8: BAT42; D_SOD-123
J14: Conn_01x03_Pin; PinHeader_1x03_P2.54mm_Vertical
R3, R8: 470; R_0603_1608Metric
R5: 5.2K; R_0603_1608Metric
R6, R10: 1K; R_0603_1608Metric
R11, R16: 2K; R_0603_1608Metric

Connections:
+3.3V: D4.1 (K), D5.1 (K); also elsewhere on the board
Current - 5V: R6.1; also elsewhere on the board
CurrentPin: R8.2; also elsewhere on the board
GND: D7.2 (A), D8.2 (A), R11.2, R16.2; also elsewhere on the board
unnamed: D4.2 (A), D8.1 (K), R6.2, R8.1, R16.1
unnamed: D5.2 (A), D7.1 (K), R3.1, R5.2, R10.2, R11.1
unnamed: J14.1, R10.1
unnamed: J14.3, R5.1
WAS: J14.2; also elsewhere on the board
WASpin: R3.2; also elsewhere on the board

Notes on the sheet:
WAS 12V
WAS 5V

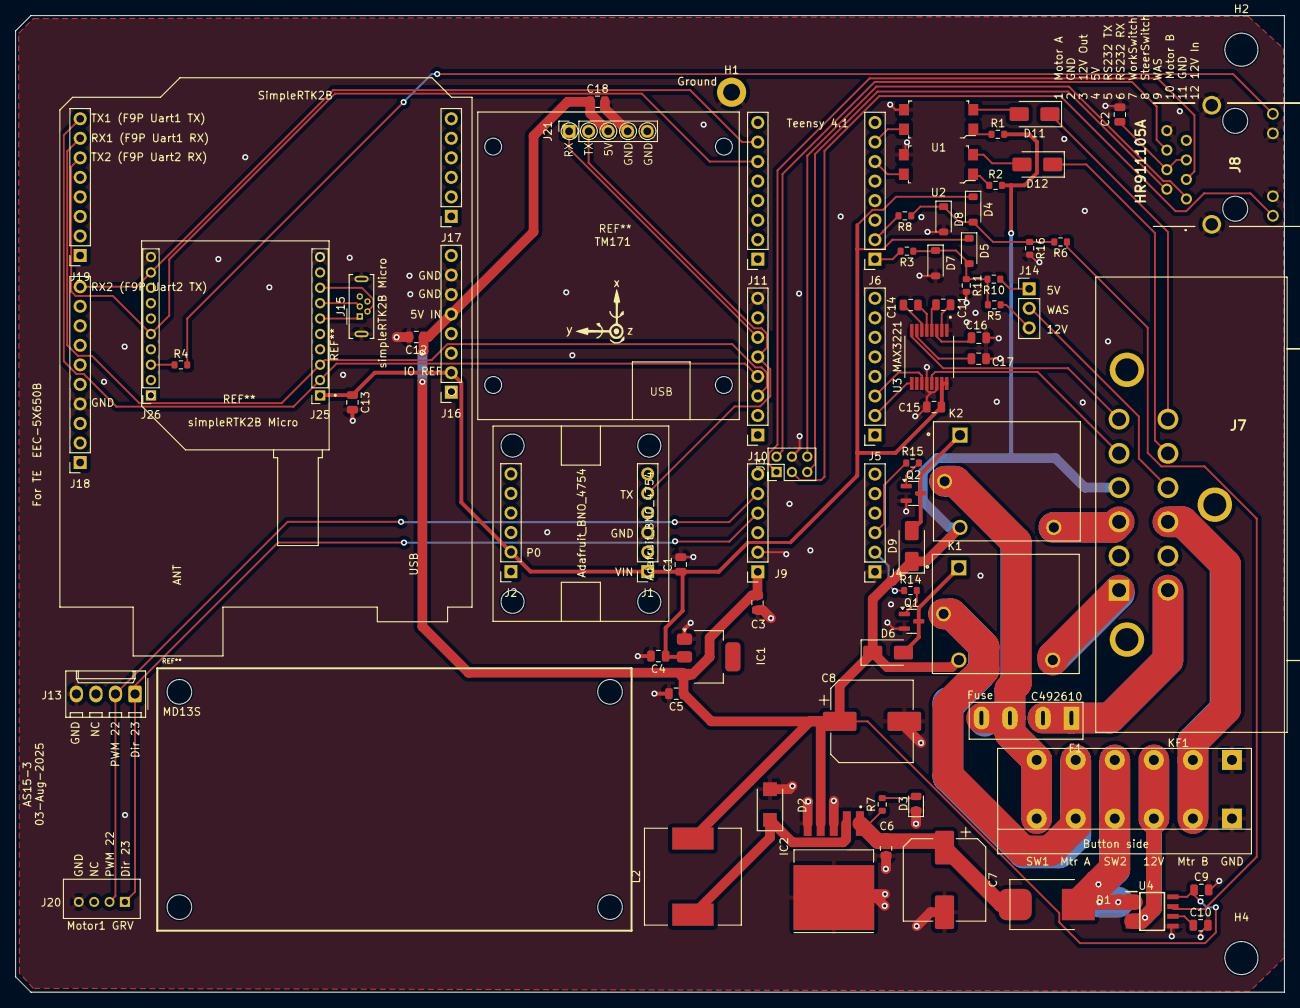
[picture p39: board AS15.kicad_pcb from above]

Board: 2 copper layers, 165.0 x 127.0 mm, 80 parts (0 on the bottom side), 66 nets.
