SK21/AOG_AutoSteer/AutoSteer_for_5/AutoSteer12-2_PCB/AS12.kicad_pcb

## KiCad design AutoSteer_for_5/AutoSteer12-2_PCB/AS12.kicad_pcb (2023-04-19)

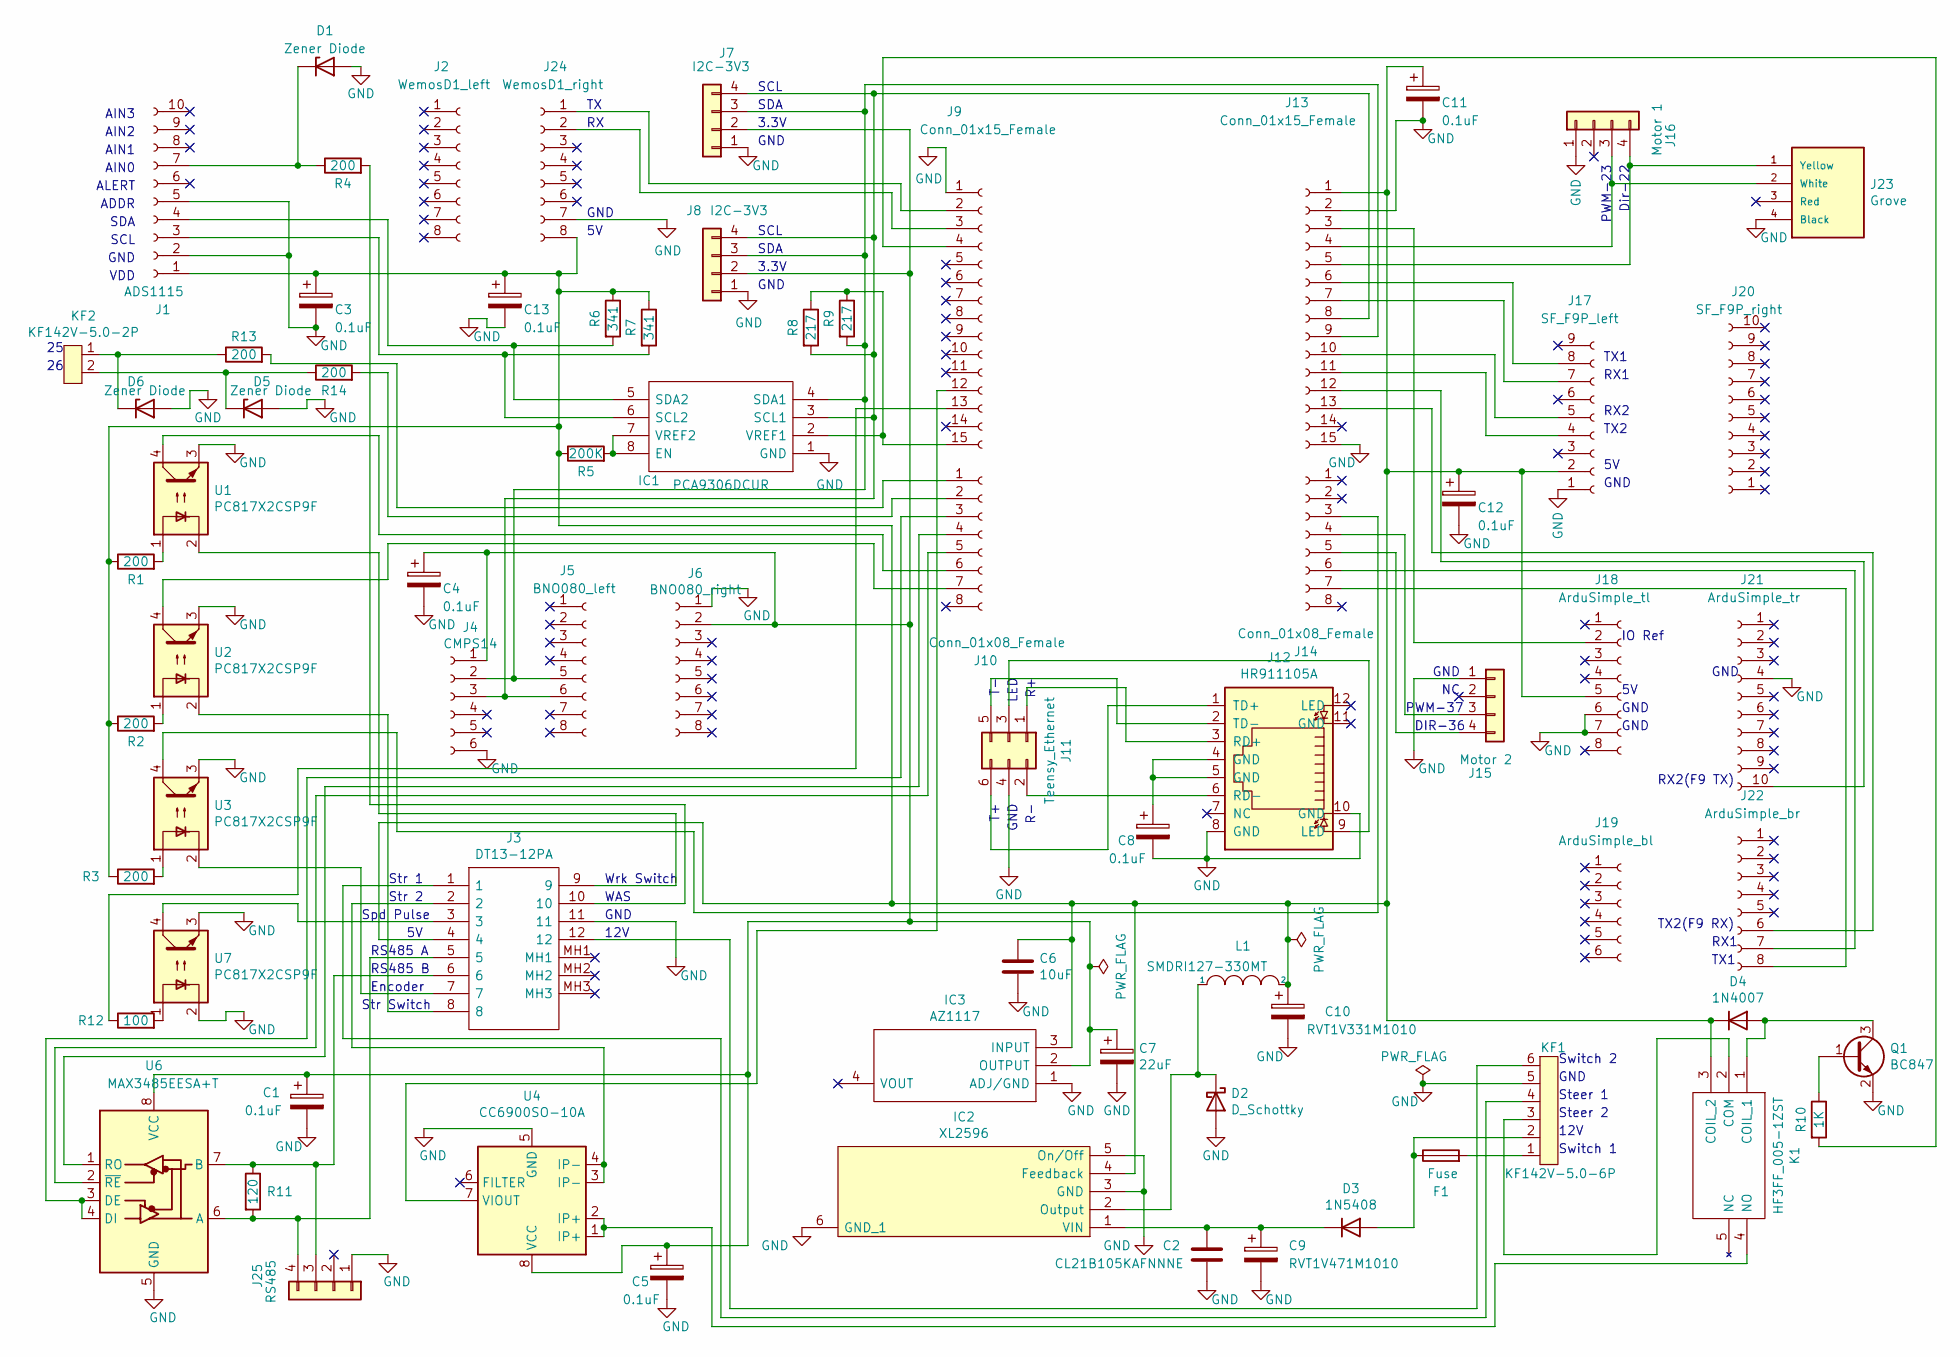
[picture p40: schematic AS12.sch, AS12-2]

Parts:
C1, C3, C4, C5, C8, C11, C12, C13: 0.1uF; C_0805_2012Metric
C2: CL21B105KAFNNNE; C_0805_2012Metric
C6: 10uF; C_0805_2012Metric
C7: 22uF; C_0805_2012Metric
C9: RVT1V471M1010; CP_Elec_10x10.5
C10: RVT1V331M1010; CP_Elec_10x10.5
D1, D5, D6: Zener Diode; D_SOD-123F
D2: D_Schottky; SMA(DO-214AC)
D3: 1N5408; DO-201AD-28
D4: 1N4007; D_SMA
F1: Fuse; Fuse_Holder_C3131
IC1: PCA9306DCUR; SOP50P310X90-8N; Mouser Part Number 595-PCA9306DCUR
IC2: XL2596; TO263-5L
IC3: AZ1117; SOT-223
J1: ADS1115; PinSocket_1x10_P2.54mm_Vertical
J2: WemosD1_left; PinSocket_1x08_P2.54mm_Vertical
J3: DT13-12PA; DT1312PA; Manufacturer_Part_Number DT13-12PA; Mouser Part Number 571-DT13-12PA
J4: CMPS14; PinSocket_1x06_P2.54mm_Vertical
J5: BNO080_left; PinSocket_1x08_P2.54mm_Vertical
J6: BNO080_right; PinSocket_1x08_P2.54mm_Vertical
J7, J8: I2C-3V3; Qwic_vertical
J9, J13: Conn_01x15_Female; PinSocket_1x15_P2.54mm_Vertical
J10, J14: Conn_01x08_Female; PinSocket_1x08_P2.54mm_Vertical
J11: Teensy_Ethernet; PinHeader_2x03_P2.00mm_Vertical
J12: HR911105A
J15: Motor 2; Qwic_vertical
J16: Motor 1; Qwic_vertical
J17: SF_F9P_left; PinSocket_1x09_P2.54mm_Vertical
J18: ArduSimple_tl; PinSocket_1x08_P2.54mm_Vertical
J19: ArduSimple_bl; PinSocket_1x06_P2.54mm_Vertical
J20: SF_F9P_right; PinSocket_1x10_P2.54mm_Vertical
J21: ArduSimple_tr; PinSocket_1x10_P2.54mm_Vertical
J22: ArduSimple_br; PinSocket_1x08_P2.54mm_Vertical
J23: Grove
J24: WemosD1_right; PinSocket_1x08_P2.54mm_Vertical
J25: RS485; Qwic_vertical
K1: HF3FF_005-1ZST; HF3FF0121ZST; Manufacturer_Part_Number HF3FF/012-1ZST
KF1: KF142V-5.0-6P; KF142V-5.08-6P
KF2: KF142V-5.0-2P; KF142V-5.08-2P
L1: SMDRI127-330MT; TMPA1265SP-101MN-D
Q1: BC847; SOT-23
R1, R2, R3, R4, R13, R14: 200; R_1210_3225Metric
R5: 200K; R_1210_3225Metric
R6, R7: 341; R_1210_3225Metric
R8, R9: 217; R_1210_3225Metric
R10: 1K; R_1210_3225Metric
R11: 120; R_1206_3216Metric
R12: 100; R_1206_3216Metric
U1, U2, U3, U7: PC817X2CSP9F; SOIC254P960X420-4N
U4: CC6900SO-10A; SOIC127P600X175-8N
U6: MAX3485EESA+T; Maxim_Integrated-S8-2-0-P-MFG

Connections:
GND: C1.2, C2.2, C3.2, C4.2, C5.2, C6.2, C7.2, C8.2, C9.2, C10.2, C11.2, C12.2, C13.2, D1.2 (A), D2.2 (A), D5.2 (A), D6.2 (A), IC1.1 (GND), IC2.3 (GND), IC2.5 (On/Off), IC2.6 (GND_1), IC3.1 (ADJ/GND), J1.2, J1.5, J3.11, J4.6, J6.1, J7.1, J8.1, J9.1, J11.4, J12.8 (GND), J12.10 (GND), J13.2, J13.15, J15.1, J16.1, J17.1, J18.6, J18.7, J21.4, J23.4 (Black), J24.7, J25.1, KF1.5, Q1.2 (E), U1.3, U2.3, U3.3, U4.5 (GND), U6.5 (GND), U7.2, U7.3
unnamed: C1.1, C4.1, C5.1, C7.1, IC3.2 (OUTPUT), J4.1, J6.2, J7.2, J8.2, U4.8 (VCC), U6.8 (VCC)
unnamed: C2.1, C9.1, D3.1 (K), IC2.1 (VIN)
unnamed: C8.1, J12.4 (GND), J12.5 (GND)
unnamed: C3.1, C6.1, C10.1, C11.1, C12.1, C13.1, D4.1 (K), IC2.4 (Feedback), IC3.3 (INPUT), J1.1, J3.4, J13.1, J17.2, J18.5, J24.8, K1.3 (COIL_2), L1.2, R1.1, R2.1, R3.1, R5.1, R6.1, R7.1
unnamed: D1.1 (K), J1.7, R4.1
unnamed: D2.1 (K), IC2.2 (Output), L1.1
unnamed: D3.2 (A), F1.1, KF1.2
unnamed: D4.2 (A), K1.1 (COIL_1), Q1.3 (C)
unnamed: D5.1 (K), KF2.2, R14.1
unnamed: D6.1 (K), KF2.1, R13.1
unnamed: F1.2, KF1.1
unnamed: IC1.2 (VREF1), J9.15, R8.1, R9.1
unnamed: IC1.3 (SCL1), J4.3, J5.6, J7.4, J8.4, J13.8, R8.2
unnamed: IC1.4 (SDA1), J4.2, J5.5, J7.3, J8.3, J13.9, R9.2
unnamed: IC1.5 (SDA2), J1.4, R6.2
unnamed: IC1.6 (SCL2), J1.3, R7.2
unnamed: IC1.7 (VREF2), IC1.8 (EN), R5.2
unnamed: J3.1, KF1.4
unnamed: J3.2, U4.3 (IP-), U4.4 (IP-)
unnamed: J3.3, U7.4
unnamed: J3.7, U3.2
unnamed: J3.8, U2.2
unnamed: J3.9, U1.2
unnamed: J3.10, R4.2
unnamed: J3.12, KF1.6
unnamed: J9.4, R10.2
unnamed: J9.12, U4.7 (VIOUT)
unnamed: J9.13, R12.1
unnamed: J10.1, R13.2
unnamed: J10.2, R14.2
unnamed: J10.3, U6.3 (DE), U6.4 (DI)
unnamed: J10.4, U6.1 (RO)
unnamed: J10.5, U6.2 (~RE)
unnamed: J10.6, U1.4
unnamed: J10.7, U2.4
unnamed: J11.1, J12.3 (RD+)
unnamed: J11.2, J12.6 (RD-)
unnamed: J11.3, J12.9 (LED)
unnamed: J11.5, J12.2 (TD-)
unnamed: J11.6, J12.1 (TD+)
unnamed: J13.3, J18.2
unnamed: J13.4, J16.3, J23.2 (White)
unnamed: J13.5, J16.4, J23.1 (Yellow)
unnamed: J13.6, J17.8
unnamed: J13.7, J17.7
unnamed: J13.10, J17.5
unnamed: J13.11, J17.4
unnamed: J13.12, J21.10
unnamed: J13.13, J22.6
unnamed: J14.3, U3.4
unnamed: J14.4, J15.3
unnamed: J14.5, J15.4
unnamed: J14.6, J22.7
unnamed: J14.7, J22.8
unnamed: J9.2, J24.1
unnamed: J9.3, J24.2
unnamed: J3.6, J25.3, R11.1, U6.7 (B)
unnamed: J3.5, J25.4, R11.2, U6.6 (A)
unnamed: K1.2 (COM), KF1.3
unnamed: K1.4 (NO), U4.1 (IP+), U4.2 (IP+)
unnamed: Q1.1 (B), R10.1
unnamed: R1.2, U1.1
unnamed: R2.2, U2.1
unnamed: R3.2, U3.1
unnamed: R12.2, U7.1

Notes on the sheet:
Dir-22
PWM-23
Steer 2
Switch 1
Steer 1
SCL
SDA
3.3V
GND
VDD
ADDR
ALERT
AIN0
AIN1
AIN2
AIN3
LED
Spd Pulse
WAS
RS485 B
RS485 A
Encoder
Str Switch
Wrk Switch
Str 1
IO Ref
TX1
RX1
TX2(F9 RX)
RX2(F9 TX)
Switch 2
12V
PWM-37
DIR-36
Str 2
12V
TX2
RX2

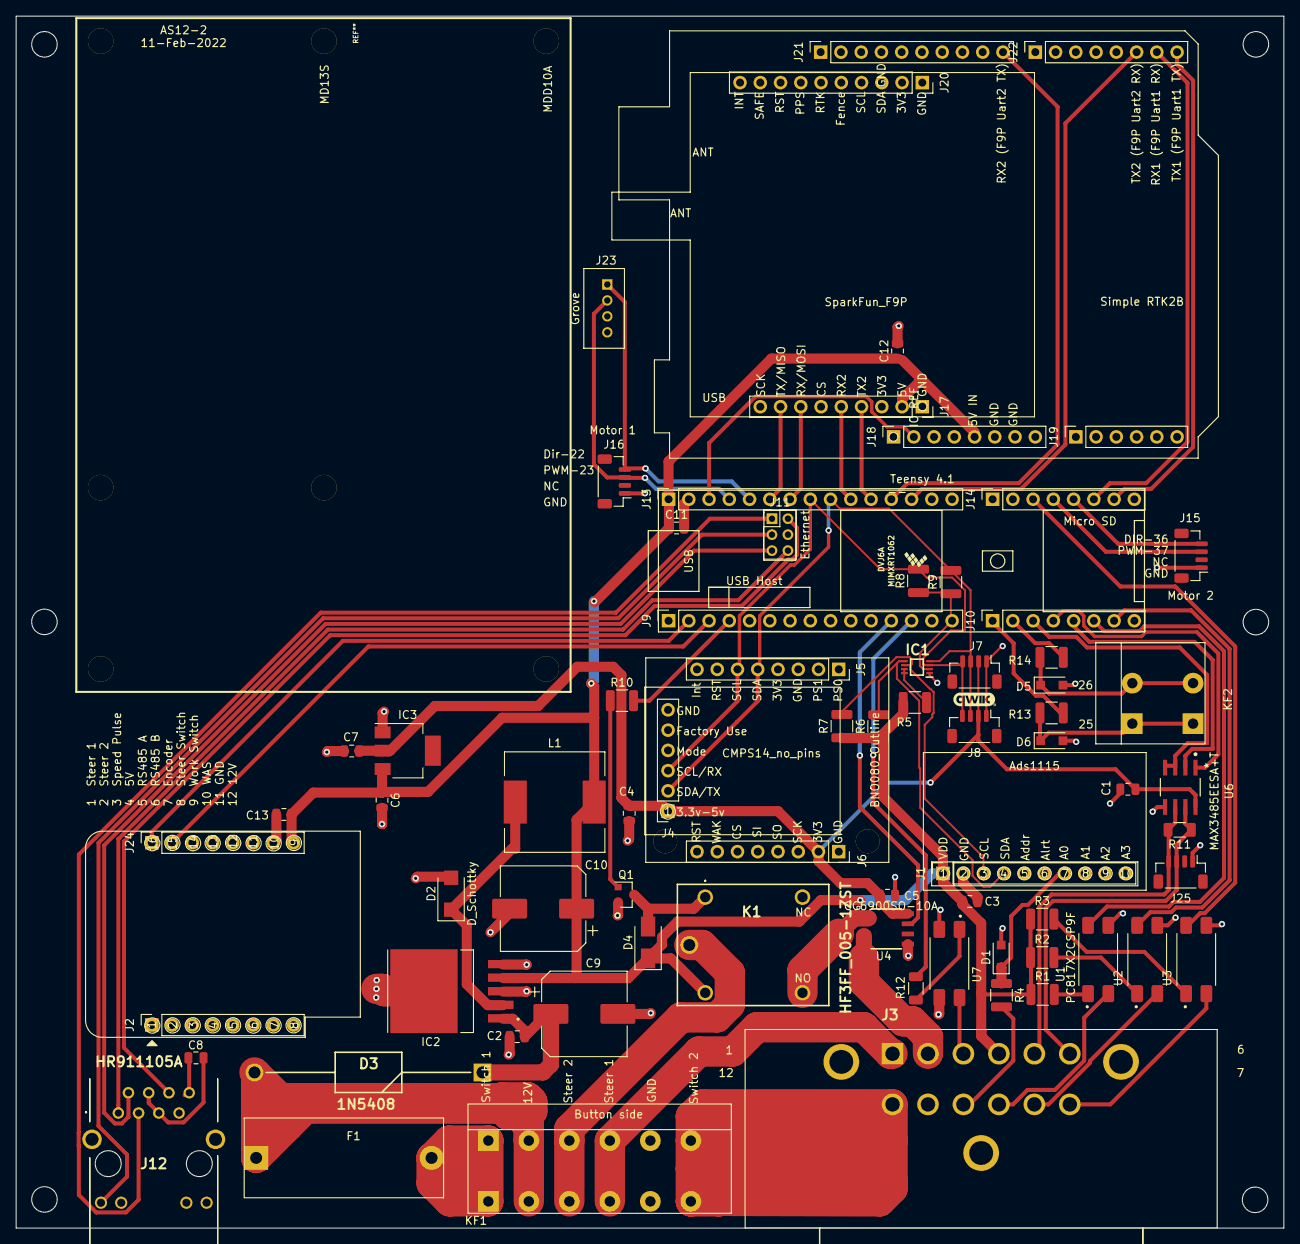
[picture p41: board AS12.kicad_pcb from above]

Board: 2 copper layers, 159.0 x 152.0 mm, 81 parts (0 on the bottom side), 66 nets.

Other parts of the board:
 : MountingHole_3.2mm_M3
 #2,  #3,  #4,  #5,  #6: MountingHole_3.2mm_M3
--: Teensy 4.1; Teensy41_no_pins
M1: CMPS14_no_pins
