SK21/AOG_AutoSteer/AutoSteer_for_5/AutoSteer13-3_PCB/AS13.kicad_pcb

## KiCad design AutoSteer_for_5/AutoSteer13-3_PCB/AS13.kicad_pcb (2023-04-19)

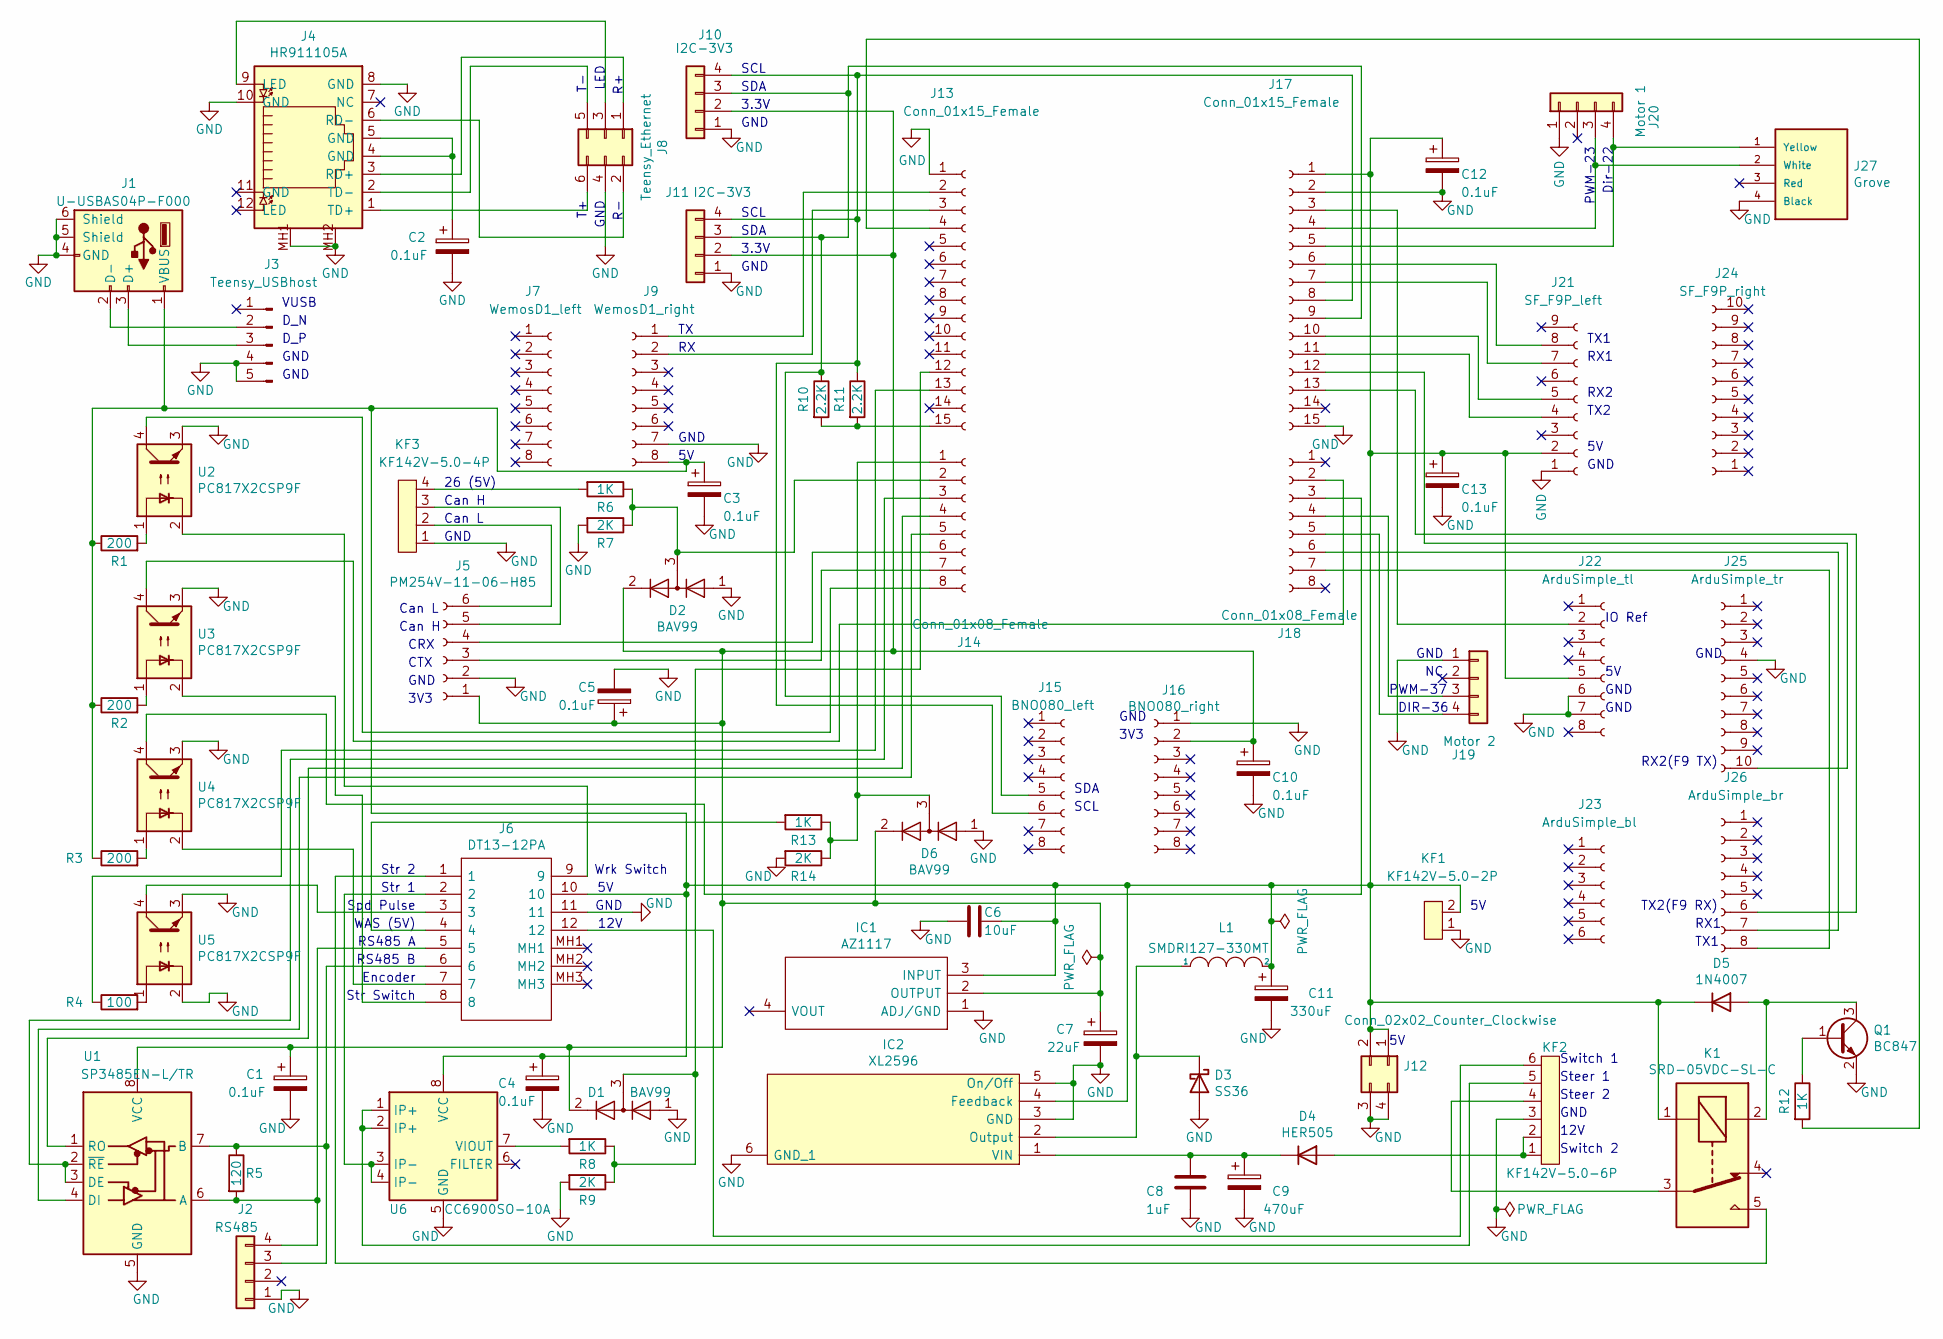
[picture p42: schematic AS13.sch, AS13-3]

Parts:
C1, C2, C3, C4, C5, C10, C12, C13: 0.1uF; C_0805_2012Metric
C6: 10uF; C_0805_2012Metric
C7: 22uF; C_0805_2012Metric
C8: 1uF; C_0805_2012Metric
C9: 470uF; CP_Elec_10x10.5
C11: 330uF; CP_Elec_10x10.5
D1, D2, D6: BAV99; SOT-23
D3: SS36; SMA(DO-214AC)
D4: HER505; 1N5408
D5: 1N4007; D_SMA
IC1: AZ1117; SOT-223
IC2: XL2596; TO263-5L
J1: U-USBAS04P-F000
J2: RS485; Qwic_vertical
J3: Teensy_USBhost; PinHeader_1x05_P2.54mm_Vertical
J4: HR911105A
J5: PM254V-11-06-H85; PinSocket_1x06_P2.54mm_Vertical
J6: DT13-12PA; DT1312PA; Manufacturer_Part_Number DT13-12PA; Mouser Part Number 571-DT13-12PA
J7: WemosD1_left; PinSocket_1x08_P2.54mm_Vertical
J8: Teensy_Ethernet; PinHeader_2x03_P2.00mm_Vertical
J9: WemosD1_right; PinSocket_1x08_P2.54mm_Vertical
J10, J11: I2C-3V3; Qwic_vertical
J12: Conn_02x02_Counter_Clockwise; PinSocket_2x02_P2.54mm_Vertical
J13, J17: Conn_01x15_Female; PinSocket_1x15_P2.54mm_Vertical
J14, J18: Conn_01x08_Female; PinSocket_1x08_P2.54mm_Vertical
J15: BNO080_left; PinSocket_1x08_P2.54mm_Vertical
J16: BNO080_right; PinSocket_1x08_P2.54mm_Vertical
J19: Motor 2; Qwic_vertical
J20: Motor 1; Qwic_vertical
J21: SF_F9P_left; PinSocket_1x09_P2.54mm_Vertical
J22: ArduSimple_tl; PinSocket_1x08_P2.54mm_Vertical
J23: ArduSimple_bl; PinSocket_1x06_P2.54mm_Vertical
J24: SF_F9P_right; PinSocket_1x10_P2.54mm_Vertical
J25: ArduSimple_tr; PinSocket_1x10_P2.54mm_Vertical
J26: ArduSimple_br; PinSocket_1x08_P2.54mm_Vertical
J27: Grove
K1: SRD-05VDC-SL-C; Songle_SRD-05VDC-SL-C
KF1: KF142V-5.0-2P; KF142V-5.08-2P
KF2: KF142V-5.0-6P; KF142V-5.08-6P
KF3: KF142V-5.0-4P; KF142V-5.08-4P
L1: SMDRI127-330MT; TMPA1265SP-101MN-D
Q1: BC847; SOT-23
R1, R2, R3: 200; R_1206_3216Metric
R4: 100; R_1206_3216Metric
R5: 120; R_1206_3216Metric
R6, R8, R12, R13: 1K; R_1206_3216Metric
R7, R9, R14: 2K; R_1206_3216Metric
R10, R11: 2.2K; R_1206_3216Metric
U1: SP3485EN-L/TR; Maxim_Integrated-S8-2-0-P-MFG
U2, U3, U4, U5: PC817X2CSP9F; SOIC254P960X420-4N
U6: CC6900SO-10A; SOIC127P600X175-8N

Connections:
GND: C1.2, C2.2, C3.2, C4.2, C5.2, C6.2, C7.2, C8.2, C9.2, C10.2, C11.2, C12.2, C13.2, D1.1 (K), D2.1 (K), D3.2 (A), D6.1 (K), IC1.1 (ADJ/GND), IC2.3 (GND), IC2.5 (On/Off), IC2.6 (GND_1), J1.4 (GND), J1.5 (Shield), J1.6 (Shield), J2.1, J3.4, J3.5, J4.8 (GND), J4.10 (GND), J4.MH1, J4.MH2, J5.2, J6.11, J8.4, J9.7, J10.1, J11.1, J12.3, J12.4, J13.1, J16.1, J17.2, J17.15, J19.1, J20.1, J21.1, J22.6, J22.7, J25.4, J27.4 (Black), KF1.1, KF2.3, KF3.1, Q1.2 (E), R7.2, R9.2, R14.2, U1.5 (GND), U2.3, U3.3, U4.3, U5.2, U5.3, U6.5 (GND)
unnamed: C1.1, C5.1, C7.1, C10.1, D1.2 (A), D2.2 (A), D6.2 (A), IC1.2 (OUTPUT), J5.1, J10.2, J11.2, J16.2, U1.8 (VCC)
unnamed: C2.1, J4.4 (GND), J4.5 (GND)
unnamed: C8.1, C9.1, D4.1 (K), IC2.1 (VIN)
unnamed: C3.1, C4.1, C6.1, C11.1, C12.1, C13.1, D5.1 (K), IC1.3 (INPUT), IC2.4 (Feedback), J1.1 (VBUS), J6.10, J9.8, J12.1, J12.2, J17.1, J21.2, J22.5, K1.1, KF1.2, L1.2, R1.1, R2.1, R3.1, U6.8 (VCC)
unnamed: D1.3 (K), J13.12, R8.1, R9.1
unnamed: D2.3 (K), J14.2, R6.1, R7.1
unnamed: D3.1 (K), IC2.2 (Output), L1.1
unnamed: D4.2 (A), KF2.1, KF2.2
unnamed: D5.2 (A), K1.2, Q1.3 (C)
unnamed: D6.3 (K), J14.1, R13.1, R14.1
unnamed: J1.2 (D-), J3.2
unnamed: J1.3 (D+), J3.3
unnamed: J2.3, J6.6, R5.1, U1.7 (B)
unnamed: J2.4, J6.5, R5.2, U1.6 (A)
unnamed: J4.1 (TD+), J8.6
unnamed: J4.2 (TD-), J8.5
unnamed: J4.3 (RD+), J8.1
unnamed: J4.6 (RD-), J8.2
unnamed: J4.9 (LED), J8.3
unnamed: J5.5, KF3.3
unnamed: J5.6, KF3.2
unnamed: J6.1, K1.5
unnamed: J6.2, U6.3 (IP-), U6.4 (IP-)
unnamed: J6.3, U5.4
unnamed: J6.4, R13.2
unnamed: J6.7, U4.2
unnamed: J6.8, U3.2
unnamed: J6.9, U2.2
unnamed: J6.12, KF2.6
unnamed: J10.3, J11.3, J15.5, J17.9, R10.1
unnamed: J10.4, J11.4, J15.6, J17.8, R11.1
unnamed: J9.1, J13.2
unnamed: J9.2, J13.3
unnamed: J13.4, R12.2
unnamed: J13.13, R4.1
unnamed: J13.15, R10.2, R11.2
unnamed: J14.3, U1.2 (~RE), U1.3 (DE)
unnamed: J14.4, U1.1 (RO)
unnamed: J14.5, U1.4 (DI)
unnamed: J5.4, J14.6
unnamed: J5.3, J14.7
unnamed: J14.8, U2.4
unnamed: J17.3, J22.2
unnamed: J17.4, J20.3, J27.2 (White)
unnamed: J17.5, J20.4, J27.1 (Yellow)
unnamed: J17.6, J21.8
unnamed: J17.7, J21.7
unnamed: J17.10, J21.5
unnamed: J17.11, J21.4
unnamed: J17.12, J25.10
unnamed: J17.13, J26.6
unnamed: J18.2, U3.4
unnamed: J18.3, U4.4
unnamed: J18.4, J19.3
unnamed: J18.5, J19.4
unnamed: J18.6, J26.7
unnamed: J18.7, J26.8
unnamed: K1.3, KF2.4
unnamed: KF2.5, U6.1 (IP+), U6.2 (IP+)
unnamed: KF3.4, R6.2
unnamed: Q1.1 (B), R12.1
unnamed: R1.2, U2.1
unnamed: R2.2, U3.1
unnamed: R3.2, U4.1
unnamed: R4.2, U5.1
unnamed: R8.2, U6.7 (VIOUT)

Notes on the sheet:
Dir-22
PWM-23
Steer 2
Switch 1
Steer 1
SCL
SDA
3.3V
GND
LED
WAS (5V)
RS485 B
RS485 A
Encoder
Str Switch
Wrk Switch
Str 1
IO Ref
TX1
RX1
TX2(F9 RX)
RX2(F9 TX)
Switch 2
12V
PWM-37
DIR-36
Str 2
12V
TX2
RX2
Spd Pulse
VUSB
D_N
D_P
3V3
Can L
Can H
CRX
CTX
26 (5V)

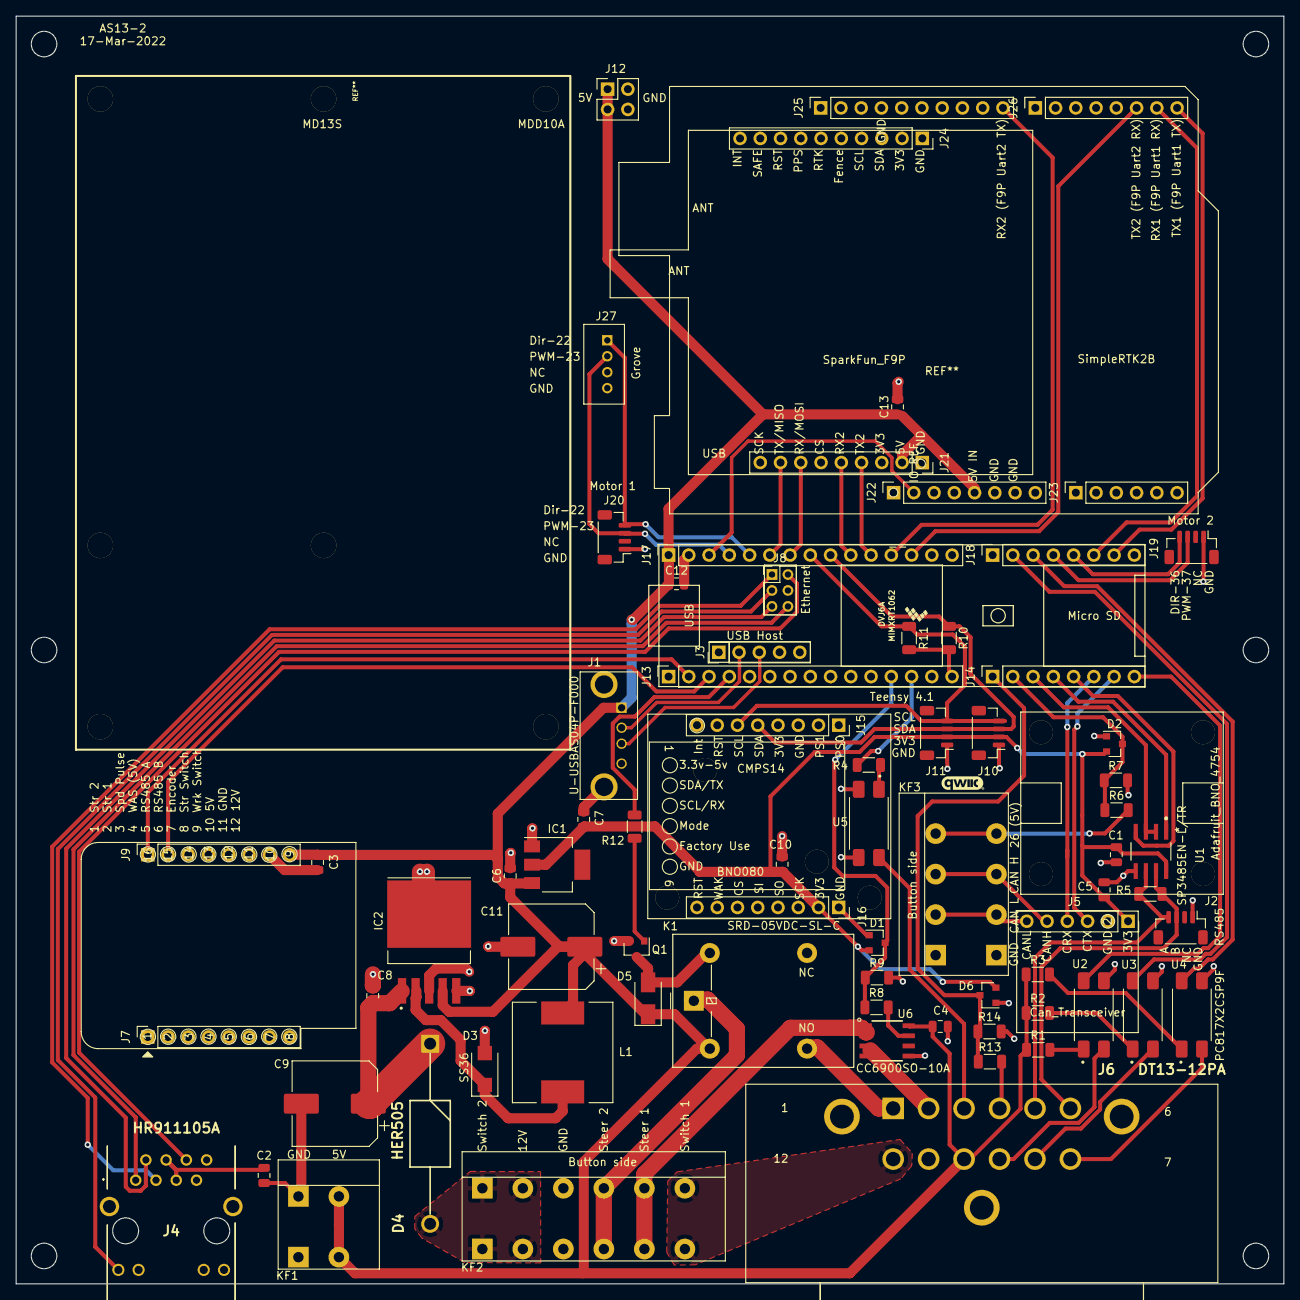
[picture p43: board AS13.kicad_pcb from above]

Board: 2 copper layers, 159.0 x 159.0 mm, 82 parts (0 on the bottom side), 67 nets.

Other parts of the board:
  : MountingHole_3.2mm_M3
  #2,   #3,   #4,   #5,   #6: MountingHole_3.2mm_M3
--: Teensy 4.1; Teensy41_no_pins
M1: CMPS14; CMPS14_no_pins
