SK21/AOG_AutoSteer/AutoSteer_for_5/AutoSteer14_PCB/AS14.kicad_pcb

## KiCad design AutoSteer_for_5/AutoSteer14_PCB/AS14.kicad_pcb (2023-04-19)

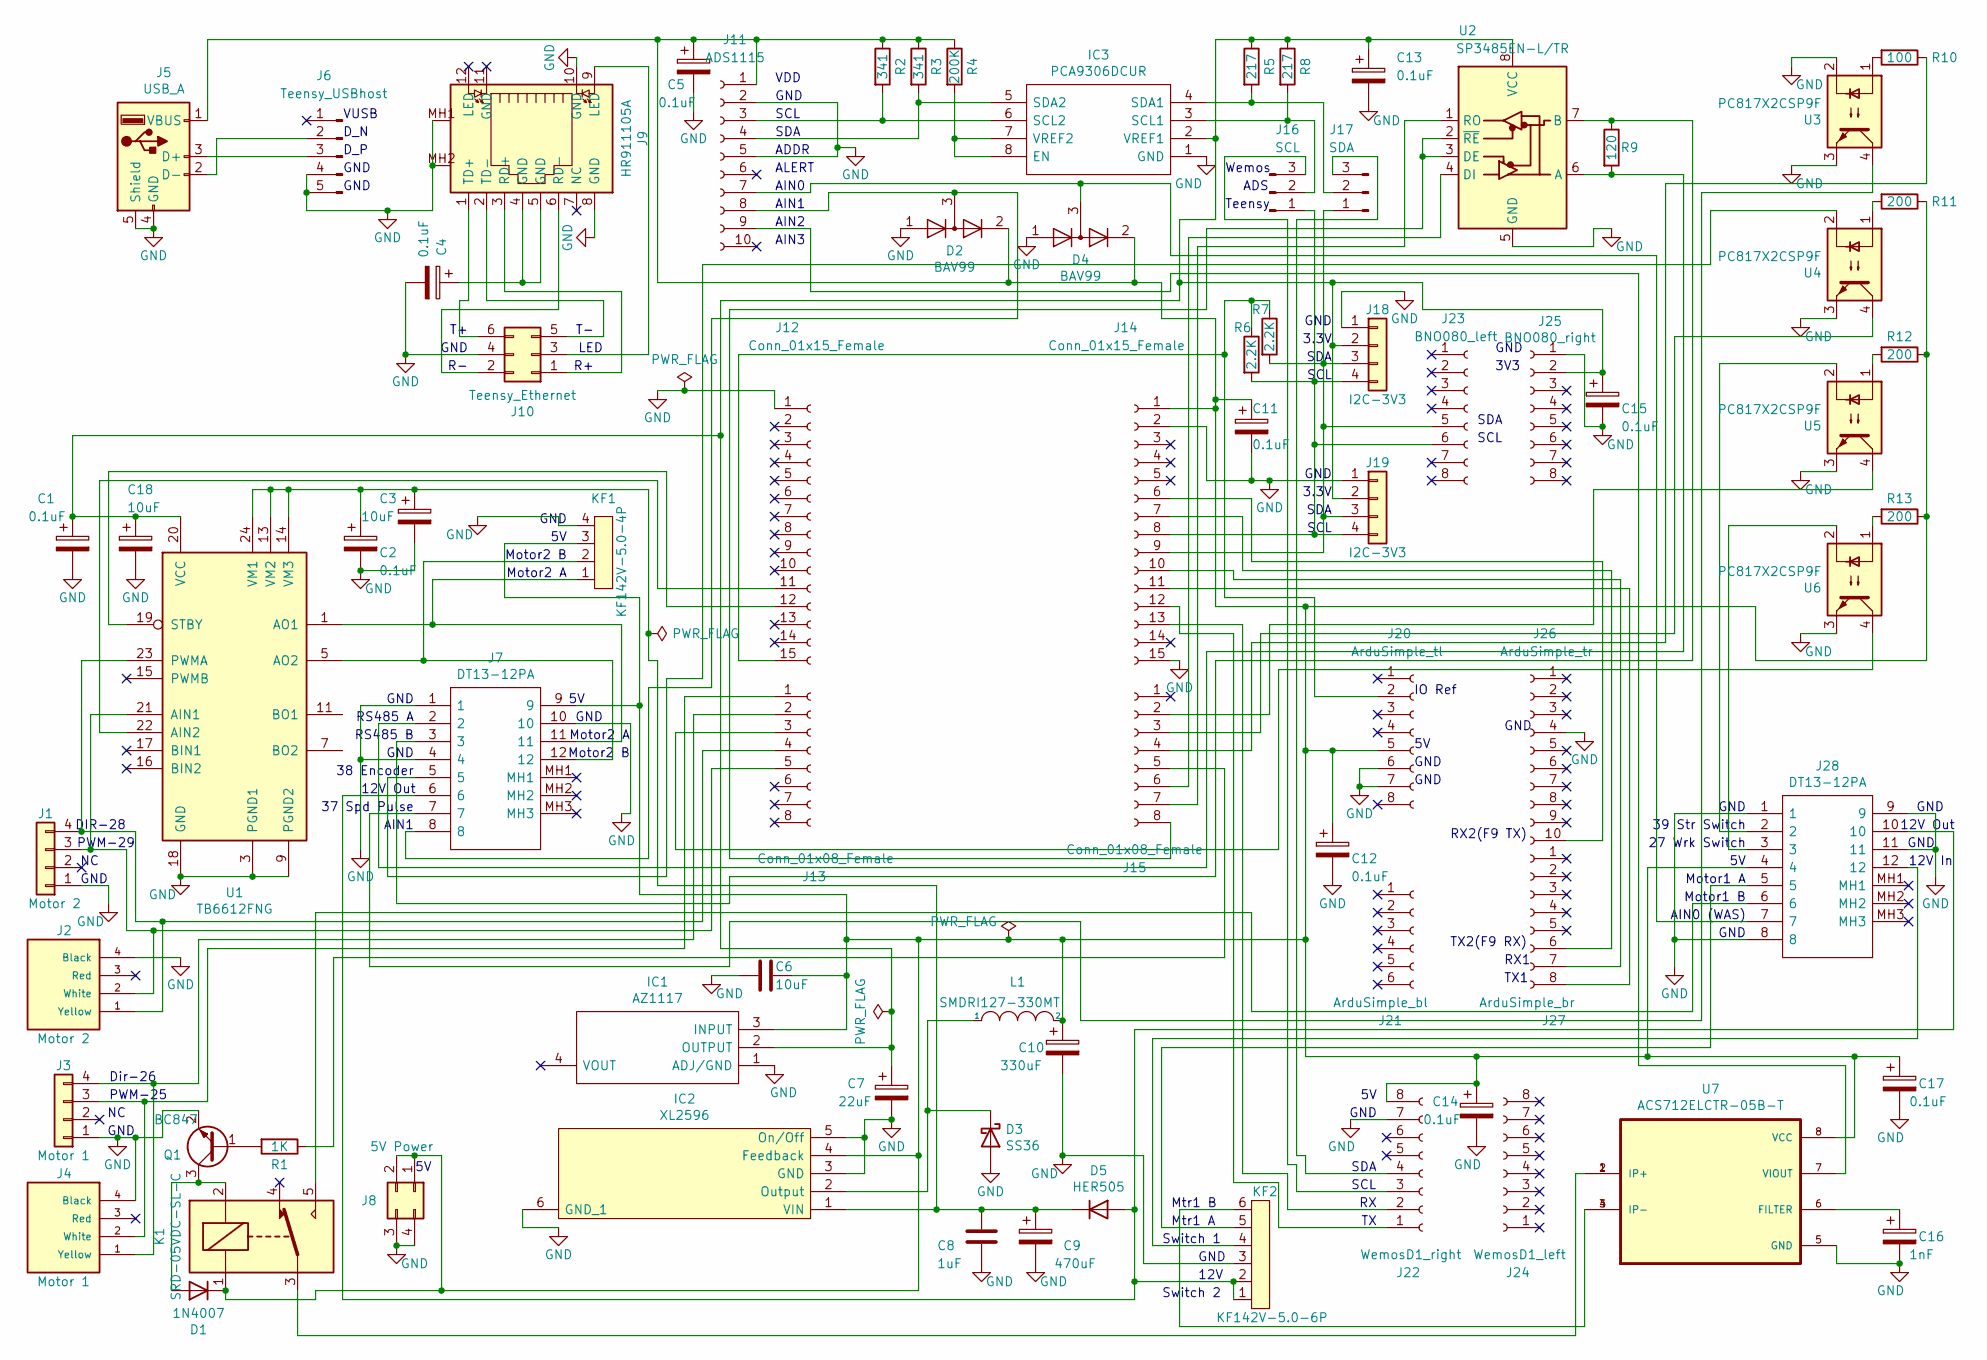
[picture p44: schematic AS14.sch]

Parts:
C1, C2, C4, C5, C11, C12, C13, C14, C15, C17: 0.1uF; C_0805_2012Metric
C3, C6, C18: 10uF; C_0805_2012Metric
C7: 22uF; C_0805_2012Metric
C8: 1uF; C_0805_2012Metric
C9: 470uF; CP_Elec_10x10.5
C10: 330uF; CP_Elec_10x10.5
C16: 1nF; C_0805_2012Metric
D1: 1N4007; D_SMA
D2, D4: BAV99; SOT-23
D3: SS36; SMA(DO-214AC)
D5: HER505; 1N5408
IC1: AZ1117; SOT-223
IC2: XL2596; TO263-5L
IC3: PCA9306DCUR; Mouser Part Number 595-PCA9306DCUR
J1: Motor 2; Qwic_vertical
J2: Motor 2; Grove
J3: Motor 1; Qwic_vertical
J4: Motor 1; Grove
J5: USB_A; USB_A_Molex_67643_Horizontal
J6: Teensy_USBhost; PinHeader_1x05_P2.54mm_Vertical
J7, J28: DT13-12PA; DT1312PA; Manufacturer_Part_Number DT13-12PA; Mouser Part Number 571-DT13-12PA
J8: 5V Power; PinSocket_2x02_P2.54mm_Vertical
J9: HR911105A
J10: Teensy_Ethernet; PinHeader_2x03_P2.00mm_Vertical
J11: ADS1115; PinSocket_1x10_P2.54mm_Vertical
J12, J14: Conn_01x15_Female; PinSocket_1x15_P2.54mm_Vertical
J13, J15: Conn_01x08_Female; PinSocket_1x08_P2.54mm_Vertical
J16: SCL; PinHeader_1x03_P2.54mm_Vertical
J17: SDA; PinHeader_1x03_P2.54mm_Vertical
J18, J19: I2C-3V3; Qwic_vertical
J20: ArduSimple_tl; PinSocket_1x08_P2.54mm_Vertical
J21: ArduSimple_bl; PinSocket_1x06_P2.54mm_Vertical
J22: WemosD1_right; PinSocket_1x08_P2.54mm_Vertical
J23: BNO080_left; PinSocket_1x08_P2.54mm_Vertical
J24: WemosD1_left; PinSocket_1x08_P2.54mm_Vertical
J25: BNO080_right; PinSocket_1x08_P2.54mm_Vertical
J26: ArduSimple_tr; PinSocket_1x10_P2.54mm_Vertical
J27: ArduSimple_br; PinSocket_1x08_P2.54mm_Vertical
K1: SRD-05VDC-SL-C; Songle_SRD-05VDC-SL-C
KF1: KF142V-5.0-4P; KF142V-5.08-4P
KF2: KF142V-5.0-6P; KF142V-5.08-6P
L1: SMDRI127-330MT; TMPA1265SP-101MN-D
Q1: BC847; SOT-23
R1: 1K; R_1206_3216Metric
R2, R3: 341; R_1206_3216Metric
R4: 200K; R_1206_3216Metric
R5, R8: 217; R_1206_3216Metric
R6, R7: 2.2K; R_1206_3216Metric
R9: 120; R_1206_3216Metric
R10: 100; R_1206_3216Metric
R11, R12, R13: 200; R_1206_3216Metric
U1: TB6612FNG; SSOP-24_5.3x8.2mm_P0.65mm
U2: SP3485EN-L/TR; Maxim_Integrated-S8-2-0-P-MFG
U3, U4, U5, U6: PC817X2CSP9F; SOIC254P960X420-4N
U7: ACS712ELCTR-05B-T; SOIC127P600X175-8N; PARTREV 1.0

Connections:
GND: C1.2, C2.2, C3.2, C4.2, C5.2, C6.2, C7.2, C8.2, C9.2, C10.2, C11.2, C12.2, C13.2, C14.2, C15.2, C16.2, C17.2, C18.2, D2.1 (K), D3.2 (A), D4.1 (K), IC1.1 (ADJ/GND), IC2.3 (GND), IC2.5 (On/Off), IC2.6 (GND_1), IC3.1 (GND), J1.1, J2.4 (Black), J3.1, J4.4 (Black), J5.4 (GND), J5.5 (Shield), J6.4, J6.5, J7.1, J7.4, J7.10, J8.3, J8.4, J9.8 (GND), J9.10 (GND), J9.MH1, J9.MH2, J10.4, J11.2, J11.5, J12.1, J14.2, J14.15, J18.1, J19.1, J20.6, J20.7, J22.7, J25.1, J26.4, J28.1, J28.8, J28.9, J28.11, KF1.4, KF2.3, Q1.2 (E), U1.3 (PGND1), U1.4 (PGND1), U1.9 (PGND2), U1.10 (PGND2), U1.18 (GND), U2.5 (GND), U3.2, U3.3, U4.3, U5.3, U6.3, U7.5 (GND)
unnamed: C1.1, C7.1, C13.1, C15.1, C18.1, IC1.2 (OUTPUT), IC3.2 (VREF1), J18.2, J19.2, J25.2, R5.1, R8.1, U1.20 (VCC), U2.8 (VCC)
unnamed: C2.1, C3.1, C8.1, C9.1, D5.1 (K), IC2.1 (VIN), U1.13 (VM2), U1.14 (VM3), U1.24 (VM1)
unnamed: C4.1, J9.4 (GND), J9.5 (GND)
unnamed: C5.1, C6.1, C10.1, C11.1, C12.1, C14.1, C17.1, D1.1 (K), D2.2 (A), D4.2 (A), IC1.3 (INPUT), IC2.4 (Feedback), J5.1 (VBUS), J7.9, J8.1, J8.2, J11.1, J14.1, J20.5, J22.8, J28.4, K1.1, KF1.3, L1.2, R2.1, R3.1, R4.1, R11.1, R12.1, R13.1, U7.8 (VCC)
unnamed: C16.1, U7.6 (FILTER)
unnamed: D1.2 (A), K1.2, Q1.3 (C)
unnamed: D2.3 (K), J7.8, J11.8
unnamed: D3.1 (K), IC2.2 (Output), L1.1
unnamed: D4.3 (K), J11.7, J28.7
unnamed: D5.2 (A), J7.6, J28.10, KF2.1, KF2.2
unnamed: IC3.3 (SCL1), J16.2, R8.2
unnamed: IC3.4 (SDA1), J17.2, R5.2
unnamed: IC3.5 (SDA2), J11.4, R3.2
unnamed: IC3.6 (SCL2), J11.3, R2.2
unnamed: IC3.7 (VREF2), IC3.8 (EN), R4.2
unnamed: J1.3, J2.2 (White), J13.5, U1.21 (AIN1)
unnamed: J1.4, J2.1 (Yellow), J13.4, U1.23 (PWMA)
unnamed: J5.2 (D-), J6.2
unnamed: J5.3 (D+), J6.3
unnamed: J7.2, R9.2, U2.6 (A)
unnamed: J7.3, R9.1, U2.7 (B)
unnamed: J7.5, U4.2
unnamed: J7.7, U3.4
unnamed: J7.11, KF1.1, U1.1 (AO1), U1.2 (AO1)
unnamed: J7.12, KF1.2, U1.5 (AO2), U1.6 (AO2)
unnamed: J9.3 (RD+), J10.1
unnamed: J9.6 (RD-), J10.2
unnamed: J9.9 (LED), J10.3
unnamed: J9.2 (TD-), J10.5
unnamed: J9.1 (TD+), J10.6
unnamed: J11.9, U7.7 (VIOUT)
unnamed: J12.11, U1.22 (AIN2)
unnamed: J12.12, U1.19 (STBY)
unnamed: J12.15, J20.2, R6.1, R7.1
unnamed: J3.3, J4.2 (White), J13.1
unnamed: J3.4, J4.1 (Yellow), J13.2
unnamed: J13.3, U6.4
unnamed: J14.6, J26.10
unnamed: J14.7, J27.6
unnamed: J14.8, J16.1, J18.4, J19.4, J23.6, R6.2
unnamed: J14.9, J17.1, J18.3, J19.3, J23.5, R7.2
unnamed: J14.10, J27.7
unnamed: J14.11, J27.8
unnamed: J14.12, J22.1
unnamed: J14.13, J22.2
unnamed: J15.2, U5.4
unnamed: J15.3, U4.4
unnamed: J15.4, R10.1
unnamed: J15.5, R1.1
unnamed: J15.6, U2.4 (DI)
unnamed: J15.7, U2.1 (RO)
unnamed: J15.8, U2.2 (~RE), U2.3 (DE)
unnamed: J16.3, J22.3
unnamed: J17.3, J22.4
unnamed: J28.2, U5.2
unnamed: J28.3, U6.2
unnamed: J28.5, KF2.5
unnamed: J28.6, K1.5
unnamed: J28.12, KF2.4
unnamed: K1.3, U7.1 (IP+), U7.2 (IP+)
unnamed: KF2.6, U7.3 (IP-), U7.4 (IP-)
unnamed: Q1.1 (B), R1.2
unnamed: R10.2, U3.1
unnamed: R11.2, U4.1
unnamed: R12.2, U5.1
unnamed: R13.2, U6.1
unnamed: U1.7 (BO2), U1.8 (BO2)
unnamed: U1.11 (BO1), U1.12 (BO1)

Notes on the sheet:
Dir-26
PWM-25
Mtr1 B
Switch 1
Mtr1 A
SCL
SDA
3.3V
GND
IO Ref
RX2(F9 TX)
Switch 2
12V
PWM-29
DIR-28
Motor2 B
3V3
Motor2 A
12V Out
TX2(F9 RX)
RX1
TX1
LED
VDD
ADDR
ALERT
AIN0
AIN1
AIN2
AIN3
12V In
ADS
Teensy
Wemos
Motor1 A
Motor1 B
27 Wrk Switch
37 Spd Pulse
39 Str Switch
RS485 A
RS485 B
AIN0 (WAS)
VUSB
D_N
D_P
38 Encoder

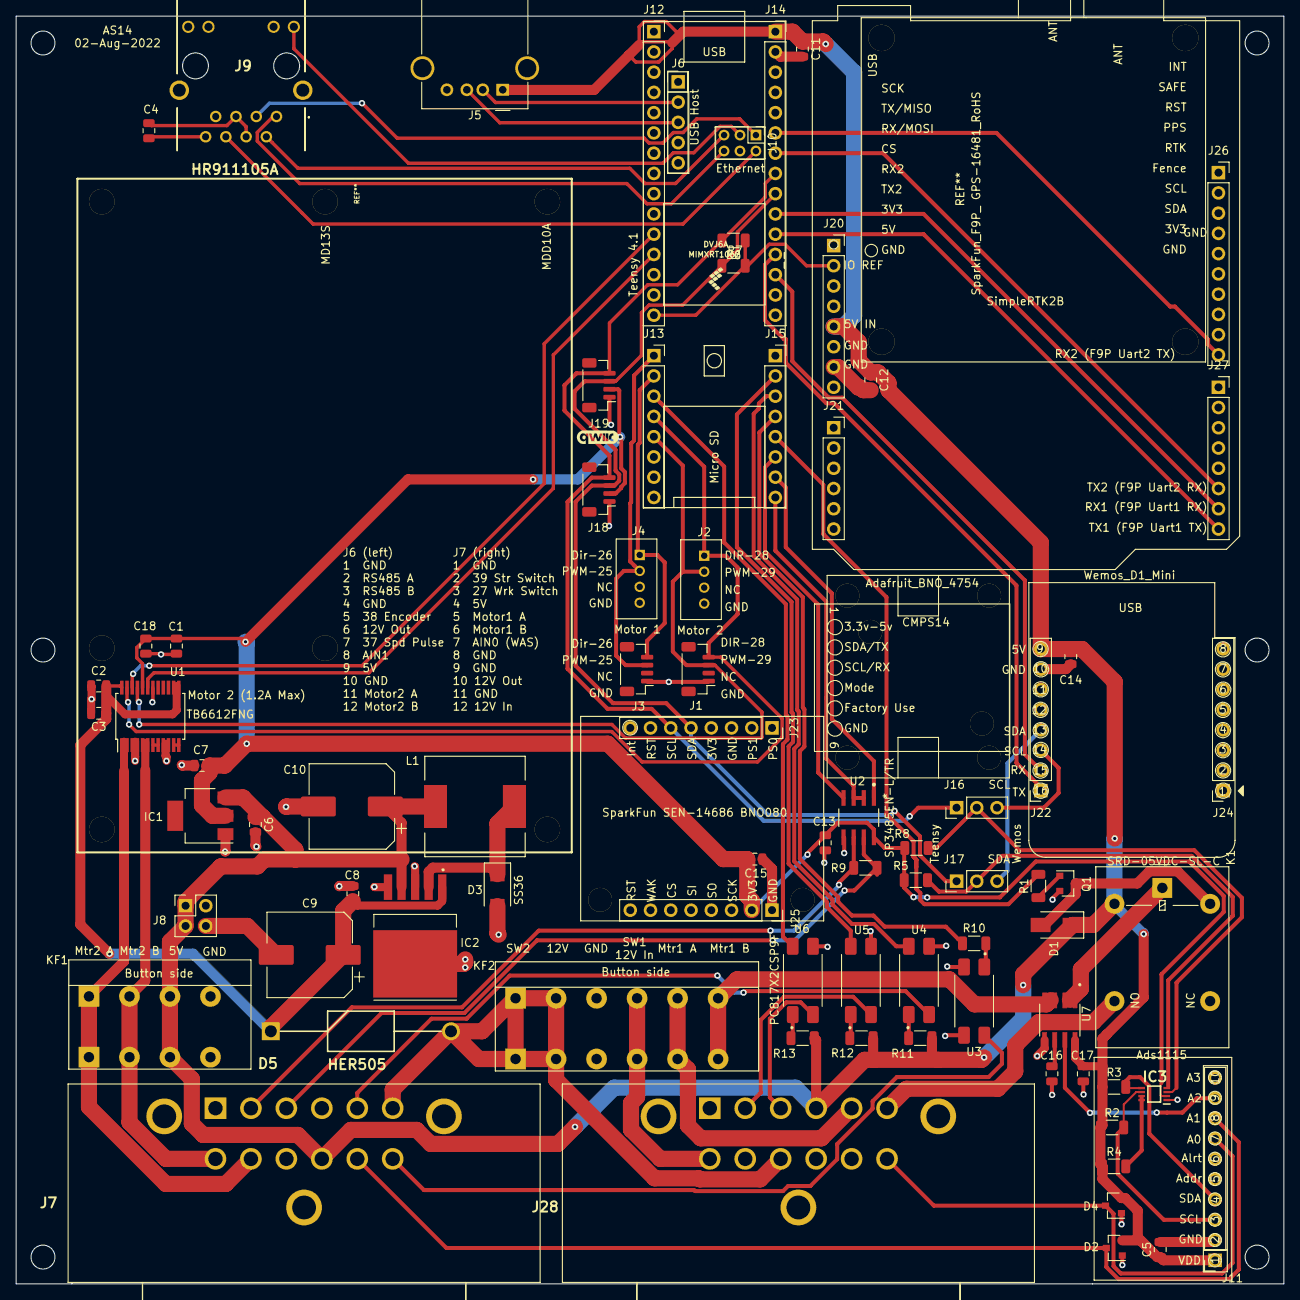
[picture p45: board AS14.kicad_pcb from above]

Board: 2 copper layers, 159.0 x 159.0 mm, 87 parts (0 on the bottom side), 69 nets.

Other parts of the board:
 : MountingHole_3mm
 #2,  #3,  #4,  #5,  #6: MountingHole_3mm
--: Teensy 4.1; Teensy41_no_pins
M1: CMPS14; CMPS14_no_pins
