SK21/AOG_AutoSteer/AutoSteer_for_5/AutoSteerTeensy/AutoSteerTeensy.ino

# define InoDescription "AutoSteerTeensy   24-Nov-2022"
// autosteer and rate control
// for use with Teensy 4.1 

#include <Wire.h>
#include <EEPROM.h> 
#include <NativeEthernet.h>
#include <NativeEthernetUdp.h>
#include <Watchdog_t4.h>	// https://github.com/tonton81/WDT_T4
#include "BNO08x_AOG.h"		// https://github.com/Math-51/Autosteer_USB_4.3.10_BN08x
#include "zNMEAParser.h"	
#include <ADC.h>
#include <ADC_util.h>
#include "PCA95x5_AOG.h"	// modified from https://github.com/hideakitai/PCA95x5

// debug variables
bool DebugOn = false;
byte DebugVal1;
byte DebugVal2;
byte DebugVal3;
uint16_t DebugVal4;
uint16_t DebugVal5;
uint16_t DebugVal6;
uint32_t DebugTime;

struct PCBconfig	// 29 bytes, AS14 default
{
	uint8_t Receiver = 1;			// 0 none, 1 SimpleRTK2B, 2 Sparkfun F9p
	uint8_t NMEAserialPort = 4;		// from receiver
	uint8_t	RTCMserialPort = 5;		// to receiver
	uint8_t WemosSerialPort = 3;	// serial port connected to Wemos D1 Mini
	uint8_t RS485PortNumber = 8;	// serial port #
	uint16_t RTCMport = 2233;		// local port to listen on for RTCM data
	uint8_t IMU = 1;				// 0 none, 1 Sparkfun BNO, 2 CMPS14, 3 Adafruit BNO
	uint8_t IMUdelay = 90;			// how many ms after last sentence should imu sample, 90 for SparkFun, 4 for CMPS14   
	uint8_t IMU_Interval = 40;		// for Sparkfun 
	uint16_t ZeroOffset = 6500;
	uint8_t	IPpart3 = 1;			// IP address, 3rd octet.
	uint8_t MinSpeed = 1;
	uint8_t MaxSpeed = 15;
	uint16_t PulseCal = 255;		// Hz/KMH X 10
	uint8_t	AnalogMethod = 0;		// 0 use ADS1115 for WAS(AIN0), AIN1, current(AIN2), 1 use Teensy analog pin for WAS, 2 use ADS1115 from Wemos D1 Mini
	uint8_t RelayControl = 0;		// 0 - no relays, 1 - RS485, 2 - PCA9555 8 relays, 3 - PCA9555 16 relays
	uint8_t ModuleID = 0;
	uint8_t SwapRollPitch = 0;		// 0 use roll value for roll, 1 use pitch value for roll
	uint8_t InvertRoll = 0;
	uint8_t UseTB6612 = 0;			// 0 - don't use TB6612 motor driver, 1 - use TB6612 motor driver for motor 2
	uint8_t GyroOn = 0;
	uint8_t RelayOnSignal = 0;		// value that turns on relays
	uint8_t FlowOnDirection = 0;	// sets on value for flow valve or sets motor direction
	uint8_t UseRate = 0;
	uint8_t UseLinearActuator = 0;	// to engage or retract steering motor, uses motor 2
	uint8_t	GGAlast = 1;
};

PCBconfig PCB;

struct PCBpinConfig	// 13 bytes, AS14 default
{
	uint8_t Motor1Dir = 26;			// motor 1 direction
	uint8_t	Motor1PWM = 25;			// motor 1 pwm
	uint8_t	STEERSW = 39;
	uint8_t	WAS = 25;				// wheel angle sensor
	uint8_t	SteerSW_Relay = 36;		// pin for steering disconnect relay
	uint8_t	WORKSW = 27;
	uint8_t CurrentSensor = 10;
	uint8_t	PressureSensor = 26;
	uint8_t	Encoder = 38;
	uint8_t	Motor2Dir = 28;			// motor 2 direction, TB6612 IN1
	uint8_t	Motor2PWM = 29;			// motor 2 pwm, TB6612 PWM
	uint8_t	SpeedPulse = 37;
	uint8_t	RS485SendEnable = 33;
};

PCBpinConfig PINS;

struct PCBanalog
{
	int16_t AIN0;	// WAS
	int16_t AIN1;	// linear actuator position or pressure sensor
	int16_t AIN2;	// current
	int16_t AIN3;
};

PCBanalog AINs;

struct WemosWifi
{
	uint8_t Enabled;
	uint32_t StartTime;
	uint8_t MasterOn;
	uint8_t RelaysLo;
	uint8_t RelaysHi;
};

WemosWifi WifiSwitches;

#define MaxReadBuffer 100

#define LOW_HIGH_DEGREES 5.0	//How many degrees before decreasing Max PWM
#define CMPS14_ADDRESS 0x60 
const int16_t AdsI2Caddress = 0x48;
WDT_T4<WDT1> wdt;

// timing loops
const uint16_t  LOOP_TIME = 25;	// 40 hz, main loop
uint32_t  LoopLast = LOOP_TIME;

const uint16_t RateLoopTime = 50;		//in msec = 20hz
uint32_t RateLoopLast = RateLoopTime;

const uint16_t RateSendTime = 200;
uint32_t RateSendLast = RateSendTime;

uint16_t  AGIOport = 9999; // port that AGIO listens on

// UDP Steering traffic, to and from AGIO
EthernetUDP UDPsteering;
uint16_t  UDPsteeringPort = 8888;		// local port to listen on
uint8_t data[MaxReadBuffer];  // Buffer For Receiving UDP Data

// UDP GPS traffic, NMEA from module to AGIO, RTCM from AGIO to module
EthernetUDP UDPgps;
char GPSbuffer[512];	// buffer for ntrip data

//steering variables
float steerAngleActual = 0;
float steerAngleSetPoint = 0; //the desired angle from AgOpen
int16_t steeringPosition = 0;
float steerAngleError = 0; //setpoint - actual
float Speed_KMH = 0.0;
int8_t guidanceStatus;

float IMU_Heading = 0;
float IMU_Roll = 0;
float IMU_Pitch = 0;
float IMU_YawRate = 0;

// switches
int8_t SteerSwitch = LOW;	// Low on, High off
int8_t SWreading = HIGH;
int8_t SWprevious = LOW;
uint32_t  SWtime = 0;
const uint16_t  SWdebounce = 50;
int8_t switchByte = 0;
int8_t workSwitch = 0;
float SensorReading;

//pwm variables
int16_t pwmDrive = 0;
int16_t MaxPWMvalue = 255;

//Heart beat hello AgIO
uint8_t helloFromAutoSteer[] = { 128, 129, 126, 126, 5, 0, 0, 0, 0, 0, 71 };
int16_t helloSteerPosition = 0;

//fromAutoSteerData FD 253 - ActualSteerAngle*100 -5,6, SwitchByte-7, pwmDisplay-8
uint8_t PGN_253[] = { 128, 129, 123, 253, 8, 0, 0, 0, 0, 0,0,0,0, 12 };

//fromAutoSteerData FD 250 - sensor values etc
uint8_t PGN_250[] = { 128, 129, 123, 250, 8, 0, 0, 0, 0, 0,0,0,0, 12 };

//Variables for settings  
struct Storage {
	uint8_t Kp = 40;  //proportional gain
	uint8_t lowPWM = 10;  //band of no action
	int16_t wasOffset = 0;
	uint8_t minPWM = 9;
	uint8_t highPWM = 60;//max PWM value
	float steerSensorCounts = 30;
	float AckermanFix = 1;     //sent as percent
};  Storage steerSettings;  //11 bytes

 //Variables for settings - 0 is false  
struct Setup {
	uint8_t InvertWAS = 0;
	uint8_t IsRelayActiveHigh = 0; //if zero, active low (default)
	uint8_t MotorDriveDirection = 0;
	uint8_t SingleInputWAS = 1;
	uint8_t CytronDriver = 1;
	uint8_t SteerSwitch = 0;  //1 if switch selected
	uint8_t SteerButton = 0;  //1 if button selected
	uint8_t ShaftEncoder = 0;
	uint8_t PressureSensor = 0;
	uint8_t CurrentSensor = 0;
	uint8_t PulseCountMax = 5;
	uint8_t IsDanfoss = 0;
};  Setup steerConfig;          //9 bytes

//EEPROM
int16_t EEread = 0;
#define EEP_Ident 4450	// if not in eeprom, overwrite
#define PCB_Ident 8230

// Rate control
bool MasterOn[2];
#define MaxFlowSensorCount 2
bool FlowEnabled[MaxFlowSensorCount];
float rateError[MaxFlowSensorCount];
float UPM[MaxFlowSensorCount];
int RatePWM[MaxFlowSensorCount];
uint32_t RateCommTime[MaxFlowSensorCount];

byte PIDkp[] = { 20 };
byte PIDki[] = { 0 };
byte PIDminPWM[] = { 50 };
byte PIDLowMax[] = { 100 };
byte PIDHighMax[] = { 255 };
byte PIDdeadband[] = { 3 };
byte PIDbrakePoint[] = { 20 };
byte AdjustTime[MaxFlowSensorCount];

byte InCommand[] = { 0, 0 };		// command byte from RateController
byte ControlType[MaxFlowSensorCount];	// 0 standard, 1 fast close, 2 motor
uint16_t TotalPulses[MaxFlowSensorCount];
byte ManualPWMsetting;
float RateSetting[MaxFlowSensorCount];
float MeterCal[MaxFlowSensorCount];

bool AutoOn = true;
byte RelayLo;
byte RelayHi;
byte PowerRelayLo;
byte PowerRelayHi;

float ManualAdjust[MaxFlowSensorCount];
uint16_t ManualLast[MaxFlowSensorCount];

bool UseMultiPulses[MaxFlowSensorCount];

// Rate port
EthernetUDP UDPrate;
uint16_t ListeningPortRate = 28888;
uint16_t DestinationPortRate = 29999;
uint8_t RateData[MaxReadBuffer];  // Buffer For Receiving UDP Data

// Config port
EthernetUDP UDPconfig;
uint16_t ListeningPortConfig = 28800;
uint16_t DestinationPortConfig = 29900;
uint8_t ConfigData[MaxReadBuffer];

uint8_t ErrorCount;
NMEAParser<2> parser;
BNO080 myIMU;

uint32_t CommTime;
bool IMUstarted = false;
bool ADSfound = false;
ADC* adc = new ADC(); // adc object for analog pins

HardwareSerial* SerialRTCM;
HardwareSerial* SerialNMEA;
HardwareSerial* SerialRS485;
HardwareSerial* SerialWemos;

PCA9555 ioex;
bool IOexpanderFound = false;
byte PGNlength;

////  function prototypes	https://forum.arduino.cc/t/declaration-of-functions/687199
//bool GoodCRC(byte[], byte);
//byte CRC(byte[], byte, byte);

uint32_t Analogtime;

void setup()
{
	// watchdog timer
	WDT_timings_t config;
	config.timeout = 60;	// seconds
	wdt.begin(config);

	pinMode(LED_BUILTIN, OUTPUT);

	Serial.begin(38400);
	delay(5000);
	Serial.println();
	Serial.println(InoDescription);
	Serial.println();

	EEPROM.get(0, EEread);              // read identifier

	if (EEread != EEP_Ident)   // check on first start and write EEPROM
	{
		EEPROM.put(0, EEP_Ident);
		EEPROM.put(10, steerSettings);
		EEPROM.put(40, steerConfig);
	}
	else
	{
		EEPROM.get(10, steerSettings);     // read the Settings
		EEPROM.get(40, steerConfig);
	}

	// pcb data
	EEPROM.get(100, EEread);

	if (EEread != PCB_Ident)
	{
		EEPROM.put(100, PCB_Ident);
		EEPROM.put(110, PCB);
		EEPROM.put(150, PINS);
	}
	else
	{
		EEPROM.get(110, PCB);
		EEPROM.get(150, PINS);
	}

	// on-board motor controller
	digitalWrite(10, PCB.UseTB6612);	// enable motor controller

	// gps receiver
	// SerialNMEA
	switch (PCB.NMEAserialPort)
	{
	case 1:
		SerialNMEA = &Serial1;
		break;
	case 2:
		SerialNMEA = &Serial2;
		break;
	case 3:
		SerialNMEA = &Serial3;
		break;
	case 4:
		SerialNMEA = &Serial4;
		break;
	case 5:
		SerialNMEA = &Serial5;
		break;
	case 6:
		SerialNMEA = &Serial6;
		break;
	case 7:
		SerialNMEA = &Serial7;
		break;
	default:
		SerialNMEA = &Serial8;
		break;
	}

	// SerialRTCM
	switch (PCB.RTCMserialPort)
	{
	case 1:
		SerialRTCM = &Serial1;
		break;
	case 2:
		SerialRTCM = &Serial2;
		break;
	case 3:
		SerialRTCM = &Serial3;
		break;
	case 4:
		SerialRTCM = &Serial4;
		break;
	case 5:
		SerialRTCM = &Serial5;
		break;
	case 6:
		SerialRTCM = &Serial6;
		break;
	case 7:
		SerialRTCM = &Serial7;
		break;
	default:
		SerialRTCM = &Serial8;
		break;
	}

	// Wemos D1 Mini serial port
	switch (PCB.WemosSerialPort)
	{
	case 1:
		SerialWemos = &Serial1;
		break;
	case 2:
		SerialWemos = &Serial2;
		break;
	case 3:
		SerialWemos = &Serial3;
		break;
	case 4:
		SerialWemos = &Serial4;
		break;
	case 5:
		SerialWemos = &Serial5;
		break;
	case 6:
		SerialWemos = &Serial6;
		break;
	case 7:
		SerialWemos = &Serial7;
		break;
	default:
		SerialWemos = &Serial8;
		break;
	}
	SerialWemos->begin(38400);

	if (PCB.Receiver != 0)
	{
		SerialRTCM->begin(115200);	// RTCM
		SerialNMEA->begin(115200);	// NMEA

		parser.setErrorHandler(errorHandler);
		parser.addHandler("G-GGA", GGA_Handler);
		parser.addHandler("G-VTG", VTG_Handler);

		static char NMEAreceiveBuffer[512];
		static char NMEAsendBuffer[512];
		static char RTCMreceiveBuffer[512];
		static char RTCMsendBuffer[512];

		SerialNMEA->addMemoryForRead(NMEAreceiveBuffer, 512);
		SerialNMEA->addMemoryForWrite(NMEAsendBuffer, 512);
		SerialRTCM->addMemoryForRead(RTCMreceiveBuffer, 512);
		SerialRTCM->addMemoryForWrite(RTCMsendBuffer, 512);
	}

	pinMode(PINS.Encoder, INPUT_PULLUP);
	pinMode(PINS.WORKSW, INPUT_PULLUP);
	pinMode(PINS.STEERSW, INPUT_PULLUP);
	pinMode(PINS.Motor1Dir, OUTPUT);
	pinMode(PINS.Motor1PWM, OUTPUT);
	pinMode(PINS.SteerSW_Relay, OUTPUT);
	pinMode(PINS.SpeedPulse, OUTPUT);
	pinMode(PINS.Motor2Dir, OUTPUT);
	pinMode(PINS.Motor2PWM, OUTPUT);
	//pinMode(PINS.WAS, INPUT_PULLUP);


	// analog pins
	adc->adc0->setAveraging(16); // set number of averages
	adc->adc0->setResolution(12); // set bits of resolution
	adc->adc0->setConversionSpeed(ADC_CONVERSION_SPEED::MED_SPEED); // change the conversion speed
	adc->adc0->setSamplingSpeed(ADC_SAMPLING_SPEED::MED_SPEED); // change the sampling speed

	Wire.begin();			// I2C on pins SCL 19, SDA 18
	Wire.setClock(400000); //Increase I2C data rate to 400kHz

	if (PCB.AnalogMethod==0)
	{
		// ADS1115
		Serial.println("Starting ADS ...");
		ErrorCount = 0;
		while (!ADSfound)
		{
			Wire.beginTransmission(AdsI2Caddress);
			Wire.write(0b00000000);	//Point to Conversion register
			Wire.endTransmission();
			Wire.requestFrom(AdsI2Caddress, 2);
			ADSfound = Wire.available();
			Serial.print(".");
			delay(500);
			if (ErrorCount++ > 10) break;
		}
		Serial.println("");
		if (ADSfound)
		{
			Serial.println("ADS connected.");
			Serial.println("");
		}
		else
		{
			Serial.println("ADS not found.");
			Serial.println("");
		}
	}

	// ethernet start
	Serial.println("Starting Ethernet ...");
	IPAddress LocalIP(192, 168, PCB.IPpart3, 126);
	static uint8_t LocalMac[] = { 0x00,0x00,0x56,0x00,0x00,126 };

	Ethernet.begin(LocalMac, 0);
	Ethernet.setLocalIP(LocalIP);
	Serial.print("IP Address: ");
	Serial.println(Ethernet.localIP());
	Serial.println("");

	// main port
	UDPsteering.begin(UDPsteeringPort);

	// GPS port
	UDPgps.begin(PCB.RTCMport);

	// IMU
	uint8_t IMUaddress;
	switch (PCB.IMU)
	{
	case 1:
	case 3:
		// sparkfun BNO, Adafruit BNO
		IMUaddress = 0x4B;	// Sparkfun
		if (PCB.IMU == 3) IMUaddress = 0x4A;	// Adafruit

		ErrorCount = 0;
		Serial.println("Starting IMU ...");
		while (!IMUstarted)
		{
			IMUstarted = myIMU.begin(IMUaddress, Wire);
			Serial.print(".");
			delay(500);
			if (ErrorCount++ > 10) break;
		}
		Serial.println("");

		if (IMUstarted)
		{
			if (PCB.GyroOn) myIMU.enableGyro(PCB.IMU_Interval - 1);

			myIMU.enableGameRotationVector(PCB.IMU_Interval); //Send data update every REPORT_INTERVAL in ms for BNO085

			//Retrieve the getFeatureResponse report to check if Rotation vector report is corectly enable
			if (myIMU.getFeatureResponseAvailable() == true)
			{
				if (myIMU.checkReportEnable(SENSOR_REPORTID_GAME_ROTATION_VECTOR, PCB.IMU_Interval) == false) myIMU.printGetFeatureResponse();
				Serial.println("BNO08x init succeeded.");
			}
			else
			{
				Serial.println(F("BNO08x init fails!!"));
			}
		}
		else
		{
			Serial.println("IMU failed to start.");
		}
		break;

	case 2:
		// CMPS14
		ErrorCount = 0;
		Serial.println("Starting  CMPS14 IMU  ...");
		while (!IMUstarted)
		{
			Wire.beginTransmission(CMPS14_ADDRESS);
			IMUstarted = !Wire.endTransmission();
			Serial.print(".");
			delay(500);
			if (ErrorCount++ > 10) break;
		}
		Serial.println("");
		if (IMUstarted)
		{
			Serial.println("IMU started.");
		}
		else
		{
			Serial.println("IMU failed to start.");
		}
		break;

	case 4:
		// serial imu
		Serial.println("Using serial IMU.");
		IMUstarted = true;
		break;

	default:
		PCB.IMU = 0;
	}

	// RS485
	switch (PCB.RS485PortNumber)
	{
	case 1:
		SerialRS485 = &Serial1;
		break;
	case 2:
		SerialRS485 = &Serial2;
		break;
	case 3:
		SerialRS485 = &Serial3;
		break;
	case 4:
		SerialRS485 = &Serial4;
		break;
	case 5:
		SerialRS485 = &Serial5;
		break;
	case 6:
		SerialRS485 = &Serial6;
		break;
	case 7:
		SerialRS485 = &Serial7;
		break;
	default:
		SerialRS485 = &Serial8;
		break;
	}

	SerialRS485->begin(9600);
	pinMode(PINS.RS485SendEnable, OUTPUT);
	digitalWrite(PINS.RS485SendEnable, HIGH);

	if (PCB.UseRate)
	{
		Serial.println("");
		Serial.print("Rate Module ID: ");
		Serial.println(PCB.ModuleID);
		Serial.println();

		attachInterrupt(digitalPinToInterrupt(PINS.Encoder), ISR0, FALLING);
		UDPrate.begin(ListeningPortRate);
	}

	UDPconfig.begin(ListeningPortConfig);

	noTone(PINS.SpeedPulse);
	SteerSwitch = HIGH;

	// relays
	if (PCB.RelayControl == 2 || PCB.RelayControl == 3)
	{
		// PCA9555 I/O expander on default address 0x20
		Serial.println("");
		Serial.println("Starting PCA9555 I/O Expander ...");
		ErrorCount = 0;
		while (!IOexpanderFound)
		{
			Serial.print(".");
			Wire.beginTransmission(0x20);
			IOexpanderFound = (Wire.endTransmission() == 0);
			ErrorCount++;
			delay(500);
			if (ErrorCount > 5) break;
		}

		Serial.println("");
		if (IOexpanderFound)
		{
			Serial.println("I/O expander found.");

			ioex.attach(Wire);
			ioex.polarity(PCA95x5::Polarity::ORIGINAL_ALL);
			ioex.direction(PCA95x5::Direction::OUT_ALL);
			ioex.write(PCA95x5::Level::H_ALL);
		}
		else
		{
			Serial.println("I/O expander not found.");
		}
	}

	Serial.println("");
	Serial.println("Finished setup.");
	Serial.println("");
}

void loop()
{
	if (millis() - LoopLast >= LOOP_TIME)
	{
		LoopLast = millis();
		ReadSwitches();
		DoSteering();
		if (PCB.UseLinearActuator) PositionActuator();
		if (PCB.Receiver == 0) ReadIMU();
		if (DebugOn) DebugTheINO();
	}

	if (millis() - Analogtime > 5)
	{
		Analogtime = millis();
		ReadAnalog();
	}

	Blink();
	ReceiveSteerUDP();
	ReceiveSerialUSB();
	ReceiveSerialWemos();
	SendSpeedPulse();
	if (PCB.Receiver != 0) DoPanda();
	if (PCB.UseRate) DoRate();
	wdt.feed();
}


bool State = 0;
uint32_t BlinkTime;
uint32_t LastBlink;
void Blink()
{
	if (millis() - BlinkTime > 1000)
	{
		State = !State;
		if (State) digitalWrite(LED_BUILTIN, HIGH);
		else digitalWrite(LED_BUILTIN, LOW);
		BlinkTime = millis();
		Serial.print(" Loop interval (ms): ");
		Serial.print((float)(micros() - LastBlink) / 1000.0, 3);
		Serial.print(", Heading: ");
		Serial.print(IMU_Heading / 10);
		Serial.print(" , AIN0 (WAS): ");
		Serial.print(AINs.AIN0);
		Serial.print(", AIN1: ");
		Serial.print(AINs.AIN1);
		Serial.print(", AIN2: ");
		Serial.print(AINs.AIN2);

		Serial.println(".");	// needed to allow PCBsetup to connect
	}
	LastBlink = micros();
}

uint32_t SpeedPulseTime;
void SendSpeedPulse()
{
	// https://discourse.agopengps.com/t/get-feed-rate-from-ago-and-transform-it-into-weedkiller-sprayer-computer-compatible-pulses/2958/39
	// PulseCal: hz/mph - 41.0, hz/kmh - 25.5

	if (millis() - SpeedPulseTime > 400) //This section runs every 400 millis.  It gets speed and changes the frequency of the tone generator.
	{
		SpeedPulseTime = millis();
		if (Speed_KMH < 1.22) // If the speed is lower than (0.76 MPH, 1.22 KMH) or (31.1 Hz) it forces the output to 0. Tone will not work under 31 Hz 
		{
			noTone(PINS.SpeedPulse);
		}
		else
		{
			tone(PINS.SpeedPulse, (Speed_KMH * PCB.PulseCal / 10));
		}
	}
}

bool GoodCRC(byte Data[], byte Length)
{
	byte ck = CRC(Data, Length - 1, 0);
	bool Result = (ck == Data[Length - 1]);
	return Result;
}

byte CRC(byte Chk[], byte Length, byte Start)
{
	byte Result = 0;
	int CK = 0;
	for (int i = Start; i < Length; i++)
	{
		CK += Chk[i];
	}
	Result = (byte)CK;
	return Result;
}

void ControlMotor2(uint8_t Speed, uint8_t Direction)
{
	if (PCB.UseTB6612)
	{
		// on-board TB6612FNG motor driver
		if (Direction)
		{
			// clockwise
			digitalWrite(29, LOW);
			digitalWrite(9, HIGH);
		}
		else
		{
			// counter-clockwise
			digitalWrite(29, HIGH);
			digitalWrite(9, LOW);
		}
		analogWrite(28, Speed);
	}
	else
	{
		// external motor driver
		digitalWrite(PINS.Motor2Dir, Direction);
		analogWrite(PINS.Motor2PWM, Speed);
	}
}
