SK21/AOG_AutoSteer/AutoSteerTeensy/AutoSteerTeensy.ino

// autosteer for Teensy 4.1

#include <Wire.h>
#include <EEPROM.h>
#include <QNEthernet.h>		// https://github.com/ssilverman/QNEthernet  (lwIP stack for Teensy 4.1)
using namespace qindesign::network;	// brings Ethernet / EthernetUDP / EthernetServer into scope

#include "zNMEAParser.h"	
#include "Adafruit_BNO08x_RVC.h"	// https://github.com/VikingVoltage/Adafruit_BNO08x_RVC/tree/Get-most-recent-BNO08x-Data-from-Serial-Buffer
#include <Adafruit_Sensor.h>

#include "FXUtil.h"		// read_ascii_line(), hex file support
extern "C" {
#include "FlashTxx.h"		// TLC/T3x/T4x/TMM flash primitives
}

// Motion Module Interface:				https://www.syd-dynamics.com/download-center/
#include "EasyProfile/EasyObjectDictionary.h"
#include "EasyProfile/EasyProfile.h"
EasyObjectDictionary eOD;
EasyProfile          eP(&eOD);

#define InoDescription "AutoSteerTeensy"
const uint16_t InoID = 8086;	// change to send defaults to eeprom, ddmmy, no leading 0
const uint8_t InoType = 0;		// 0 - Teensy AutoSteer, 1 - Teensy Rate, 2 - Nano Rate, 3 - Nano SwitchBox, 4 - ESP Rate

// GPS source (stored in MDL.GPSSource)
#define GPS_F9P_IMU  0
#define GPS_ByNav    1	

// Steering mode (stored in MDL.SteeringMode)
#define STEER_WHEEL_ANGLE  0
#define STEER_TOOL_XTE     1

#define ReceiverBaud 460800
#define IMUBaud 115200
#define PassThruBaud 57600		// for RS232
#define NC 0xFF					// Pin not connected
#define ByNavBaud 115200

struct ModuleConfig		// about 28 bytes
{
	//	AS15-3 config
	uint8_t ID = 0;
	uint8_t ReceiverSerialPort = 4;
	uint8_t	IMUSerialPort = 3;
	uint8_t PassThruInSerialPort = 8;		// from F9P Uart2
	uint8_t PassThrOutSerialPort = 2;		// to Max232 for DB9 connector
	uint8_t PowerRelayPin = 0;
	uint8_t SteeringRelayPin = 1;	// pin for steering disconnect relay
	uint8_t SteerSwitchPin = 30;
	uint8_t WorkSwitchPin = 31;
	uint8_t WasPin = 25;
	uint8_t AnalogPin = 26;
	uint8_t DirPin = 23;
	uint8_t PWMpin = 22;
	float PWMFrequency = 490;	// teensy default 4482 Hz
	uint8_t EncoderPin = NC;
	uint8_t SpeedPulsePin = NC;
	uint16_t SpeedPulseCal = 255;	// Hz/KMH X 10
	int16_t ZeroOffset = 0;
	uint8_t IMUtype = 0;	// 0 BNO080, 1 TM171
	bool ADS1115Enabled = false;
	bool AutoZero = false;
	uint8_t GPSSource = 0;     // GPS_F9P_IMU(0) or GPS_ByNav(1)
	uint8_t SteeringMode = 0;  // STEER_WHEEL_ANGLE(0) or STEER_TOOL_XTE(1)
};

ModuleConfig MDL;

struct ModuleNetwork
{
	uint16_t Identifier = 9876;
	uint8_t IP0 = 192;
	uint8_t IP1 = 168;
	uint8_t IP2 = 1;
	uint8_t IP3 = 126;
};

ModuleNetwork MDLnetwork;

struct Storage
{
	uint8_t Kp = 40;  //proportional gain
	uint8_t lowPWM = 10;  //band of no action
	int16_t wasOffset = 0;
	uint8_t minPWM = 9;
	uint8_t highPWM = 60;//max PWM value
	float steerSensorCounts = 30;
	float AckermanFix = 1;     //sent as percent
};

Storage SteerSettings;  //11 bytes

struct Setup
{
	uint8_t InvertWAS = 0;
	uint8_t InvertRelays = 0;	//if zero, active low (default)
	uint8_t InvertSteer = 0;
	uint8_t SingleInputWAS = 1;
	uint8_t CytronDriver = 1;
	uint8_t SteerSwitch = 0;	//1 if switch selected
	uint8_t SteerButton = 0;	//1 if button selected
	uint8_t ShaftEncoder = 0;
	uint8_t PressureSensor = 0;
	uint8_t CurrentSensor = 0;
	uint8_t PulseCountMax = 5;
	uint8_t IsDanfoss = 0;
	uint8_t UseIMU_Y_Axis = 0;	//Set to 0 to use X Axis, 1 to use Y avis
	uint8_t WorkSwitchKickout = 0;	//1 if the work switch pin carries a kickout pulse train instead of a work switch
	float MinSpeed = 0;		// minimum kmh X 10
};

Setup SteerConfig;          //9 bytes

struct Tool_Settings
{
	uint8_t  kP = 40;
	uint8_t  kD = 0;
	uint8_t  minPWM = 20;
	uint8_t  lowPWM = 25;
	uint8_t  highPWM = 100;
	int16_t  zeroOffset_APOS = 0;
	float    lowHighDistance = 10.0f;
	uint8_t  CytronDriver = 1;
	uint8_t  invertAPOS = 0;
	uint8_t  invertActuator = 0;
	uint8_t  maxActuatorLimit = 60;
	uint8_t  isDirectionalValve = 0;
	uint8_t  valveOnTime = 5;     // Bang-bang: loop ticks energised per pulse (5 × 25ms = 125ms)
	uint8_t  valveOffTime = 15;    // Bang-bang: loop ticks de-energised per pulse (15 × 25ms = 375ms)
};

Tool_Settings toolSettings;   // 17 bytes, EEPROM offset 60 in STEER_TOOL_XTE mode

// board text ID for pcb
struct BoardLabel
{
	uint16_t Identifier;	// magic to detect an initialized slot
	char Text[16];			// up to 16 chars; app 0-pads short strings
};
BoardLabel MDLboard;
const int EE_BoardID = 178;			// free EEPROM region 
const uint16_t BoardIDMagic = 4321;	// marks an initialized board label slot

// Ethernet steering
EthernetUDP UDPsteering;	// UDP Steering traffic, to and from AGIO
const uint16_t ListeningPort = 8888;
const uint16_t DestinationPort = 9999;	// port that AGIO listens on
IPAddress DestinationIP(MDLnetwork.IP0, MDLnetwork.IP1, MDLnetwork.IP2, 255);
uint32_t AOGTime;

EthernetUDP UDPntrip;				// from AGIO to receiver
const uint16_t NtripPort = 2233;	// local port to listen on for NTRIP data
char NtripBuffer[4096];				// buffer for ntrip data

// Ethernet config
EthernetUDP UDPconfig;
const uint16_t ConfigListeningPort = 28888;
const uint16_t ConfigDestinationPort = 29500;

// firmware update
EthernetUDP UpdateComm;
const uint16_t UpdateReceivePort = 29100;
const uint16_t UpdateSendPort = 29000;
uint32_t buffer_addr, buffer_size;
bool FirmwareUpdateMode = false;

// web settings server (QNEthernet)
EthernetServer webServer(80);
bool webRebootPending = false;		// POST handlers defer the reset so the reply flushes first
uint32_t webRebootAt = 0;

//steering variables
float steerAngleActual = 0;
float steerAngleSetPoint = 0; //the desired angle from AgOpen
float Speed_KMH = 0.0;
bool AOGsteeringReady = false;	// AOG is ready to steer pending steer switch 
uint8_t SteerSwitch = HIGH;	// Low on, High off
uint8_t switchByte = 0;
float AnalogReadingAverage;

// Work switch pin used as a steering kickout (SteerConfig.WorkSwitchKickout). The sensor is a
// pulse train, not a level, so edges are counted in an ISR - the 25 ms main loop drops edges.
volatile uint32_t WorkSwitchEdges = 0;
volatile uint32_t WorkSwitchLastEdge = 0;	// micros(), ISR debounce

// attitude (from IMU or dual-antenna GPS)
float ATT_Heading = 0;
float ATT_Roll = 0;
float ATT_Pitch = 0;
float ATT_YawRate = 0;
uint32_t ATT_Time;
char attHeading[6];
char attRoll[6];
char attPitch[6];
char attYawRate[6];

//pwm variables
int16_t pwmDrive = 0;
int16_t MaxPWMvalue = 255;

//Heart beat hello AgIO
uint8_t helloFromIMU[] = { 128, 129, 121, 121, 5, 0, 0, 0, 0, 0, 71 };
uint8_t helloFromAutoSteer[] = { 128, 129, 126, 126, 5, 0, 0, 0, 0, 0, 71 };
int16_t helloSteerPosition = 0;

//fromAutoSteerData FD 253 - ActualSteerAngle*100 -5,6, SwitchByte-7, pwmDisplay-8
uint8_t PGN_253[] = { 128, 129, 123, 253, 8, 0, 0, 0, 0, 0,0,0,0, 12 };

//fromAutoSteerData FD 250 - sensor values etc
uint8_t PGN_250[] = { 128, 129, 123, 250, 8, 0, 0, 0, 0, 0,0,0,0, 12 };

NMEAParser<3> parser;
Adafruit_BNO08x_RVC rvc = Adafruit_BNO08x_RVC();
BNO08x_RVC_Data BNOdata;

uint16_t WasReading;
uint16_t AnalogReadingValue;
bool ADSfound = false;
int16_t ADS1115_Address = 72;

HardwareSerialIMXRT* SerialIMU;
HardwareSerialIMXRT* SerialReceiver;
HardwareSerialIMXRT* SerialPassIn;
HardwareSerialIMXRT* SerialPassOut;

bool SerialIMUEnabled = false;
bool SerialReceiverEnabled = false;
bool SerialPassThruEnabled = false;

const uint16_t  LOOP_TIME = 25;	// 40 hz, main loop
uint32_t  LoopLast;
uint16_t MaxLoopTime = 0;	// micros
float steerAngleError = 0;

// Tool steer variables
float   toolXTE_cm = 0;
float   vehicleXTE_cm = 0;		// received in PGN 233, not used in control logic
int16_t manualPWM = 0;			// manual override from PGN 233
int16_t pwmDisplay = 0;			// last pwmDrive before direction inversion, sent in PGN 230
uint8_t ValveCounter = 0;

//GGA
char fixTime[12];
char latitude[15];
char latNS[3];
char longitude[15];
char lonEW[3];
char fixQuality[2];
char numSats[4];
char HDOP[5];
char altitude[12];
char ageDGPS[10];

//VTG
char vtgHeading[12];
char speedKnots[10];

void setup()
{
	DoSetup();
}

void loop()
{
	DoWebUI();

	if (millis() - LoopLast >= LOOP_TIME)
	{
		LoopLast = millis();

		if (MDL.SteeringMode == STEER_WHEEL_ANGLE)
		{
			ReadAnalog();
			ReadSwitches();
			DoSteering();
		}
		else  // STEER_TOOL_XTE
		{
			ReadActuatorPosition();
			ReadSwitchesLite();
			DoToolSteering();
		}

		ReceiveConfig();
		SendSpeedPulse();
	}

	ReadIMU();
	DoPanda();

	if (MDL.SteeringMode == STEER_WHEEL_ANGLE)
	{
		ReceiveSteerData();
	}
	else
	{
		ReceiveToolSteerData();
	}

	ReceiveUpdate();

	if (SerialPassThruEnabled && SerialPassIn->available()) SerialPassOut->write(SerialPassIn->read());

	Blink();
}

//uint16_t debug1;
//uint16_t debug2;
void Blink()
{
	static elapsedMillis BlinkTmr;
	static bool State = false;
	static elapsedMicros LoopTmr;
	static byte Count = 0;
	static bool Initialized = false;

	if (BlinkTmr > 1000)
	{
		BlinkTmr = 0;
		State = !State;
		digitalWrite(LED_BUILTIN, State);
		if (!FirmwareUpdateMode)
		{
			//Serial.print(MaxLoopTime);

			//Serial.println("");

			if (Count++ > 10)
			{
				Count = 0;
				MaxLoopTime = 0;
			}
		}

		//Serial.println("");
		//Serial.print(debug1);
		//Serial.print(", ");
		//Serial.print(debug2);
	}

	if (!Initialized)
	{
		Initialized = true;
		MaxLoopTime = LoopTmr;
	}

	if (LoopTmr > MaxLoopTime) MaxLoopTime = LoopTmr;
	LoopTmr = 0;
}

bool GoodCRC(byte Data[], byte Length)
{
	byte ck = CRC(Data, Length - 1, 0);
	bool Result = (ck == Data[Length - 1]);
	return Result;
}

byte CRC(byte Chk[], byte Length, byte Start)
{
	byte Result = 0;
	for (int i = Start; i < Length; i++)
	{
		Result += Chk[i];
	}
	return Result;
}

byte ParseModID(byte ID)
{
	// top 4 bits
	return ID >> 4;
}

void SendSpeedPulse()
{
	// https://discourse.agopengps.com/t/get-feed-rate-from-ago-and-transform-it-into-weedkiller-sprayer-computer-compatible-pulses/2958/39
	// PulseCal: hz/mph - 41.0, hz/kmh - 25.5

	const uint16_t UpdateMS = 200;
	const uint16_t MinHz = 31;	// Tone will not work under 31 Hz 
	const uint16_t MaxHz = 1200;

	static float LastSpeed = 0;
	static uint32_t LastTime = 0;
	static bool ToneIsOn = false;

	if (MDL.SpeedPulsePin < NC && (millis() - LastTime > UpdateMS))
	{
		LastTime = millis();
		float PulseCal = MDL.SpeedPulseCal / 10.0;
		if (PulseCal < 1) PulseCal = 25.5;

		float CutOffSpeed = MinHz / PulseCal;

		if (ToneIsOn)
		{
			if (Speed_KMH < CutOffSpeed)
			{
				noTone(MDL.SpeedPulsePin);
				ToneIsOn = false;
			}
			else if (abs(Speed_KMH - LastSpeed) > 0.2)
			{
				uint16_t hz = Speed_KMH * PulseCal + 0.5;	// round up
				hz = constrain(hz, MinHz, MaxHz);
				tone(MDL.SpeedPulsePin, hz);
				LastSpeed = Speed_KMH;
			}
		}
		else
		{
			if (Speed_KMH >= (CutOffSpeed * 1.05))	// Add 5% to stop chatter
			{
				ToneIsOn = true;

				uint16_t hz = Speed_KMH * PulseCal + 0.5;
				hz = constrain(hz, MinHz, MaxHz);
				tone(MDL.SpeedPulsePin, hz);
				LastSpeed = Speed_KMH;
			}
		}
	}
}
