SK21/AOG_AutoSteer/AutoSteerTeensy/EthernetUpdate.ino

// based on https://github.com/joepasquariello/FlasherX

//******************************************************************************
// hex_info_t struct for hex record and hex file info
//******************************************************************************
typedef struct
{  
	char* data;			// pointer to array allocated elsewhere
	unsigned int addr;  // address in intel hex record
	unsigned int code;  // intel hex record type (0=data, etc.)
	unsigned int num;	// number of data bytes in intel hex record

	uint32_t base;  // base address to be added to intel hex 16-bit addr
	uint32_t min;   // min address in hex file
	uint32_t max;   // max address in hex file

	int eof;		// set true on intel hex EOF (code = 1)
	int lines;		// number of hex records received
} hex_info_t;

static char HexDataBuffer[16];	// buffer for hex data

hex_info_t hex =
{ // intel hex info struct
  HexDataBuffer, 0, 0, 0,       //   data,addr,num,code
  0, 0xFFFFFFFF, 0,				//   base,min,max,
  0, 0							//   eof,lines
};

enum UpdateStatus
{
	UpdateReady = 100,
	WrongModuleID = 101,
	WrongInoType = 102
};

uint8_t ReceivedData[500];

void ReceiveUpdate()
{
	// receive firmware update
	if (Ethernet.linkStatus() == LinkON)
	{
		int PacketLength = UpdateComm.parsePacket();	// QNEthernet returns -1 when empty; signed + > 0
		if (PacketLength > 0)
		{
			if (PacketLength > 500) PacketLength = 500;
			UpdateComm.read(ReceivedData, PacketLength);
			if (FirmwareUpdateMode)
			{
				if (process_hex_record(ReceivedData, PacketLength))
				{
					// return error or user abort, so clean up and
					// reboot to ensure that static vars get boot-up initialized before retry
					Serial.println();
					Serial.println("Update error.");
					Serial.printf("erase FLASH buffer / free RAM buffer...\n");
					delay(5000);
					firmware_buffer_free(buffer_addr, buffer_size);
					REBOOT;
				}
			}
			else
			{
				byte PGNlength;
				uint16_t PGN = ReceivedData[1] << 8 | ReceivedData[0];
				switch (PGN)
				{
				case 32800:
					// PGN32800, firmware update mode for Teensy 4.1
					//0		headerLo		32
					//1		headerHi		128
					//2		Module ID		
					//3		Module Type		0-4
					//4		Command
					//			- overwrite module type
					//5		CRC
					PGNlength = 6;
					if (PacketLength > PGNlength - 1)
					{
						if (GoodCRC(ReceivedData, PGNlength))
						{
							if (ParseModID(ReceivedData[2]) == MDL.ID)
							{
								if ((ReceivedData[4] == 1) || (ReceivedData[3] == InoType))
								{
									if (firmware_buffer_init(&buffer_addr, &buffer_size))
									{
										Serial.printf("target = %s (%dK flash in %dK sectors)\n", FLASH_ID, FLASH_SIZE / 1024, FLASH_SECTOR_SIZE / 1024);
										Serial.printf("buffer = %1luK %s (%08lX - %08lX)\n", buffer_size / 1024, IN_FLASH(buffer_addr) ? "FLASH" : "RAM", buffer_addr, buffer_addr + buffer_size);
										Serial.println("waiting for hex lines...\n");
										FirmwareUpdateMode = true;
										SendUpdateStatus(UpdateReady);
									}
									else
									{
										Serial.println("Unable to create update buffer.");
									}
								}
								else
								{
									SendUpdateStatus(WrongInoType);
								}
							}
							else
							{
								SendUpdateStatus(WrongModuleID);
							}
						}
					}
					break;
				}
			}
		}
	}
}

void SendLineCheck()
{
	// PGN32801
	//0		headerLo	33
	//1		headerHi	128
	//2		hex lines byte 0
	//3		hex lines byte 1
	//4		hex lines byte 2
	//5		hex lines byte 3
	//6		CRC

	if (Ethernet.linkStatus() == LinkON)
	{
		byte data[7];
		data[0] = 33;
		data[1] = 128;
		data[2] = hex.lines & 255;
		data[3] = hex.lines >> 8 & 255;
		data[4] = hex.lines >> 16 & 255;
		data[5] = hex.lines >> 24 & 255;
		data[6] = CRC(data, 6, 0);

		UpdateComm.beginPacket(DestinationIP, UpdateSendPort);
		UpdateComm.write(data, sizeof(data));
		UpdateComm.endPacket();
	}
}

void SendUpdateStatus(byte Status)
{
	// PGN32802
	//0		headerlo	34
	//1		headerHi	128
	//2		Module ID
	//3		Status		
	//4		CRC

	if (Ethernet.linkStatus() == LinkON)
	{
		byte data[5];
		data[0] = 34;
		data[1] = 128;
		data[2] = MDL.ID;
		data[3] = Status;
		data[4] = CRC(data, 4, 0);

		UpdateComm.beginPacket(DestinationIP, UpdateSendPort);
		UpdateComm.write(data, sizeof(data));
		UpdateComm.endPacket();
	}
}
//******************************************************************************
// process_hex_record()    process record and return okay (0) or error (1)
//******************************************************************************
int process_hex_record(const uint8_t* packetBuffer, int packetSize)
{
	static int DisplayCount = 0;

	if (packetSize < 5)
	{
		return 1;
	}
	else if (packetBuffer[0] != 0x3a)
	{
		Serial.printf("abort - invalid hex code %d\n", hex.code);
		return 0;
	}
	else
	{
		for (byte idx = 1; idx + 4 < packetSize;)
		{
			byte len = packetBuffer[idx];
			unsigned int addr = packetBuffer[idx + 1] << 8 | packetBuffer[idx + 2];

			byte type = packetBuffer[idx + 3];
			if (idx + 4 + len < packetSize)
			{
				unsigned sum = (len & 255) + ((addr >> 8) & 255) + (addr & 255) + (type & 255);

				for (byte j = 0; j < len; j++)
				{
					sum += packetBuffer[idx + 4 + j] & 255;
					hex.data[j] = packetBuffer[idx + 4 + j];
				}
				hex.num = len;
				hex.code = type;
				hex.addr = addr;

				byte Checksum = packetBuffer[idx + 4 + len];
				if (((sum & 255) + (Checksum & 255)) & 255)
				{
					Serial.println("abort - bad hex line");
					return 1;
				}
				else
				{
					if (hex.code == 0)// if data record
					{
						// update min/max address so far
						if (hex.base + hex.addr + hex.num > hex.max)
							hex.max = hex.base + hex.addr + hex.num;
						if (hex.base + hex.addr < hex.min)
							hex.min = hex.base + hex.addr;

						uint32_t addr = buffer_addr + hex.base + hex.addr - FLASH_BASE_ADDR;
						if (hex.max > (FLASH_BASE_ADDR + buffer_size))
						{
							Serial.printf("abort - max address %08lX too large\n", hex.max);
							return 1;
						}
						else if (!IN_FLASH(buffer_addr))
						{
							memcpy((void*)addr, (void*)hex.data, hex.num);
						}
						else if (IN_FLASH(buffer_addr))
						{
							int error = flash_write_block(addr, hex.data, hex.num);
							if (error)
							{
								Serial.println();
								Serial.printf("abort - error %02X in flash_write_block()\n", error);
								return 1;
							}
						}
					}
					else if (hex.code == 1)
					{
						// EOF (:flash command not received yet)
						Serial.println("");
						Serial.println("EOF");
						hex.eof = 1;
					}
					else if (hex.code == 2)
					{
						// extended segment address (top 16 of 24-bit addr)
						hex.base = ((hex.data[0] << 8) | hex.data[1]) << 4;
					}
					else if (hex.code == 4)
					{ // extended linear address (top 16 of 32-bit addr)
						hex.base = ((hex.data[0] << 8) | hex.data[1]) << 16;
					}
					else if (hex.code == 5)
					{ // start linear address (32-bit big endian addr)
						hex.base = (hex.data[0] << 24) | (hex.data[1] << 16)
							| (hex.data[2] << 8) | (hex.data[3] << 0);
					}
					else if (hex.code == 6)
					{
						Serial.printf("UPDATE!!!\n");
						// move new program from buffer to flash, free buffer, and reboot
						flash_move(FLASH_BASE_ADDR, buffer_addr, hex.max - hex.min);

						// should not return from flash_move(), but put REBOOT here as reminder
						REBOOT;
						return 0;
					}
					else if (hex.code == 7)
					{
						Serial.printf("LINES DONT Match\n");
						return 1;
					}
					else
					{
						// error on bad hex code
						Serial.println();
						Serial.printf("abort - invalid hex code %d\n", hex.code);
						return 1;
					}

					hex.lines++;
					if (DisplayCount++ > 100)
					{
						DisplayCount = 0;
						Serial.print(".");
					}

					if (hex.eof)
					{
						Serial.println();
						Serial.printf("\nhex file: %1d lines %1lu bytes (%08lX - %08lX)\n", hex.lines, hex.max - hex.min, hex.min, hex.max);
						SendLineCheck();

						// check for non Teensy4.1
//                        // check FSEC value in new code -- abort if incorrect
//
//#if defined(KINETISK) || defined(KINETISL)
//                        uint32_t value = *(uint32_t*)(0x40C + buffer_addr);
//                        if (value == 0xfffff9de)
//                        {
//                            Serial.println();
//                            Serial.printf("new code contains correct FSEC value %08lX\n", value);
//                        }
//                        else
//                        {
//                            Serial.println();
//                            Serial.printf("abort - FSEC value %08lX should be FFFFF9DE\n", value);
//                            return 1;
//                        }
//#endif
//
//                        // check FLASH_ID in new code - abort if not found
//                        if (check_flash_id(buffer_addr, hex.max - hex.min))
//                        {
//                            Serial.println();
//                            Serial.printf("new code contains correct target ID %s\n", FLASH_ID);
//                            SENDCheckUdp();
//                        }
//                        else
//                        {
//                            Serial.println();
//                            Serial.printf("abort - new code missing string %s\n", FLASH_ID);
//                            return 1;
//                        }
					}
					idx += 6 + len;//need for extra ::
				}
			}
			else
			{
				Serial.printf("abort - invalid hex code %d\n", hex.code);
				return 1;
			}
		}
	}
	return 0;
}
