SK21/AOG_AutoSteer/(commit log)

2021-03-15 autosteer for 4.3
    [AutoSteer.xls, AutoSteer6.kicad_pcb, AutoSteer6.sch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]
2023-04-19 Move autosteer files
    [AS12-B_Cu.gbr, AS12-B_Mask.gbr, AS12-B_Paste.gbr, AS12-B_SilkS.gbr, AS12-Edge_Cuts.gbr, AS12-F_Cu.gbr, AS12-F_Mask.gbr, AS12-F_Paste.gbr]
2023-04-19 Revert "Move autosteer files"
    This reverts commit 403095b6362e134b2a8abf9891f1a796aca93ff4.
    [AS12-B_Cu.gbr, AS12-B_Mask.gbr, AS12-B_Paste.gbr, AS12-B_SilkS.gbr, AS12-Edge_Cuts.gbr, AS12-F_Cu.gbr, AS12-F_Mask.gbr, AS12-F_Paste.gbr]
2023-04-19 Added steering modules for AOG 5
    [AS12-B_Cu.gbr, AS12-B_Mask.gbr, AS12-B_Paste.gbr, AS12-B_SilkS.gbr, AS12-Edge_Cuts.gbr, AS12-F_Cu.gbr, AS12-F_Mask.gbr, AS12-F_Paste.gbr]
2023-04-24 create BNO RVC version
    [MyConfig132.txt]
2023-04-25 remove wemos, cmps14
    [MyConfig132.txt]
2023-04-30 code cleanup, add Power Relay
2023-07-03 update pins for AS15, fix analog, fix pressure sensor
    [Analog.ino, AutoSteerTeensyRVC.ino, Begin.ino, StrSwitches.ino]
2023-07-03 add AS15 pcb
    [AS15-CuBottom.gbr, AS15-CuTop.gbr, AS15-EdgeCuts.gbr, AS15-MaskBottom.gbr, AS15-MaskTop.gbr, AS15-NPTH.drl, AS15-PTH.drl, AS15-PasteBottom.gbr]
2023-07-03 update folders
    [AS12-B_Cu.gbr, AS12-B_Mask.gbr, AS12-B_Paste.gbr, AS12-B_SilkS.gbr, AS12-Edge_Cuts.gbr, AS12-F_Cu.gbr, AS12-F_Mask.gbr, AS12-F_Paste.gbr]
2023-07-24 add MCP and PCA for relays
2023-07-31 update settings for AS14 pcb
2023-08-18 fix relays
2024-01-21 update switch code
2024-01-25 remove files
    [AS12-B_Cu.gbr, AS12-B_Mask.gbr, AS12-B_Paste.gbr, AS12-B_SilkS.gbr, AS12-Edge_Cuts.gbr, AS12-F_Cu.gbr, AS12-F_Mask.gbr, AS12-F_Paste.gbr]
2024-02-19 update pgns, validate pins
    [AS14 box v18.3mf, AS14 box v18.stl]
2024-02-25 update micro connection, relay types
2024-04-22 UDP send F9P Uart2
2025-07-23 Revert "change version #"
    This reverts commit e879a3827e5b329a56d8bb46ea690d67678a2326.
    [AutoSteerTeensyRVC.ino, Begin.ino, Config.ino, EthernetUpdate.ino]
2025-08-06 move swap pitch roll to SteerConfig
    [AutoSteerTeensyRVC.ino, Begin.ino, Panda.ino, SteerComm.ino, Steering.ino, StrSwitches.ino]
2025-08-06 add TM171 imu
2025-08-06 IMU config
2025-08-06 add imu url
2025-08-11 max reads for TM171 imu
2025-08-11 fix SetSerialPort, add pressure
    [Analog.ino, AutoSteerTeensy.ino, Begin.ino, SteerComm.ino, StrSwitches.ino]
2025-08-13 fix steer switches
2025-08-14 add shaftencoder
2025-08-18 add speed pulse, update switches
2025-08-19 add current was to status
2025-09-12 revert to previous analog read
    [Analog.ino, AutoSteerTeensy.ino]
2025-09-20 fix defaults, network struct
    [AutoSteerTeensy.ino, Begin.ino, Config.ino, SteerComm.ino, Steering.ino]
2025-09-20 virtual encoder
2025-10-21 remove invert roll, handled by aog
    [AutoSteerTeensy.ino, Begin.ino, Config.ino, IMU.ino]
2026-04-29 change pwm frequency, fix build errors
    [AutoSteerTeensy.ino, Begin.ino]
2026-05-10 add UM982 and tool steer support
2026-07-01 switch to KSXT sentence
2026-07-01 board label
2026-07-01 fix loop time display
    [AutoSteerTeensy.ino]
2026-07-01 pcb presets
2026-07-02 add WAS zero button
2026-08-04 support PCBsetup update pgn
2026-08-04 add pcb
    [AS15-3 config.txt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]
2026-08-08 workswitch as an encoder
